jumorap/Geolo/one_geoV1.2-master/cambio-driver-camera-SDK.odt

Transición de software de Flycapture a Spinnaker

Durante el proceso de ejecución del programa, se observo una incompatibilidad para la comunicación del software con la camara cuya referencia pertenece BFS-U3-50S5C-C. El programa para la inicialización, captura y control se encuentra asociado con el SDK (software development kit) Flycapture2, que se encuentra en el programa servidor, ubicación code/pgr/serverzmq/camera_driver.hpp. Para su correcta configuración es necesario un SDK llamado Spinnaker, el cual contiene una estructura lógica diferente a la que se encuentra en el programa, lo que involucra, una modificación, en archivos relacionados con el procesamiento de imagen, sobre el control servidor y la comunicación con el cliente y sus dispositivos (arduino y perifericos “motores, iluminacion, finales de carrera.”).

Una posible solución:

-Inicio de documentación detallada del funcionamiento del programa que genera la ejecución del servidor, el objetivo principal de este proceso es alcanzar el analisis especifico de las funciones involucradas en el manejo de la camara, para de esta manera lograr asociar las funciones correspondietes al SDK Spinnaker.

-El tiempo para la estructuración del diseño presente en software (de lo que se tiene hasta el momento), en un documento legible y entendible para el refinamiento y escabilidad del proyecto, es aproximadamente de 3 semanas. Esto se debe a que parte del procesamiento y el control se encuentra en el servidor y corresponde a la arquitectura mas extensa de todo el proyecto.

-Para el rediseño a partir de la documentación antes elaborada, esta propuesta entre 2-3 semanas, pueden encontrarse incompatiblidad entre las funciones existentes y las que se quieren incorporar sobre el diseño, ademas de generar un control de errores para su correcto funcionamiento.

-En la implementacion en codigo, se estima un tiempo entre 1-2 semanas, como en el caso anteriror puede presentarse errores como el uso de dependencias o librerias presentes en el sistema operativo, que no esten incorporadas e impidan el correcto funcionamiento de la aplicación.
