jumorap/Geolo/one_geoV1.2-master/electrx/datasheet_onegeo/RAMPS_FD.png

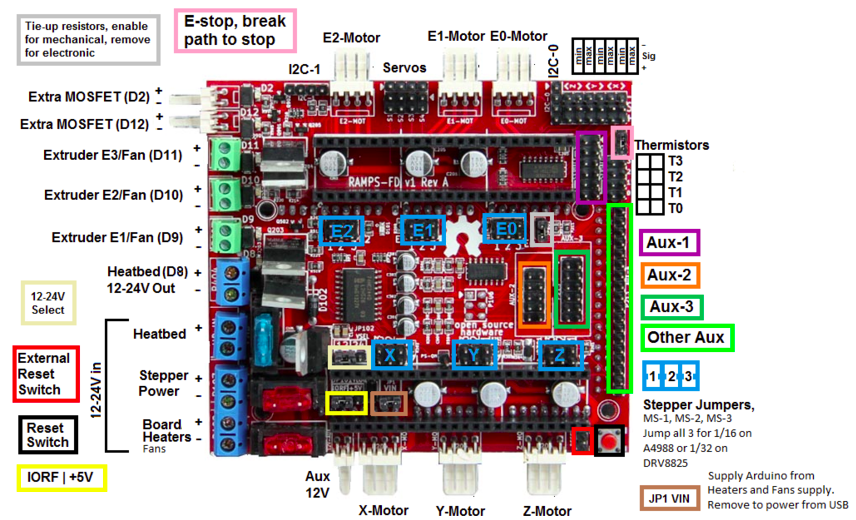
one_geoV1.2-master/electrx/datasheet_onegeo/RAMPS_FD.png
