jumorap/Geolo/one_geoV1.2-master/electrx/datasheet_onegeo/Screenshot_20191112_094737.png

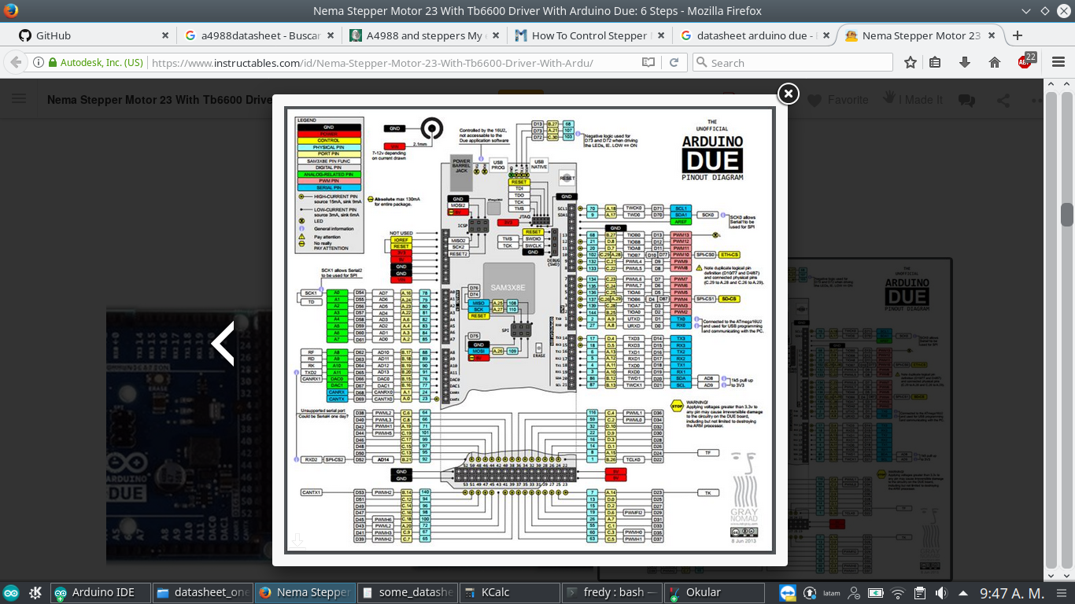
one_geoV1.2-master/electrx/datasheet_onegeo/Screenshot_20191112_094737.png
