jumorap/Geolo/one_geoV1.2-master/Mechanics/optica/imagenes_muestra/1.jpeg

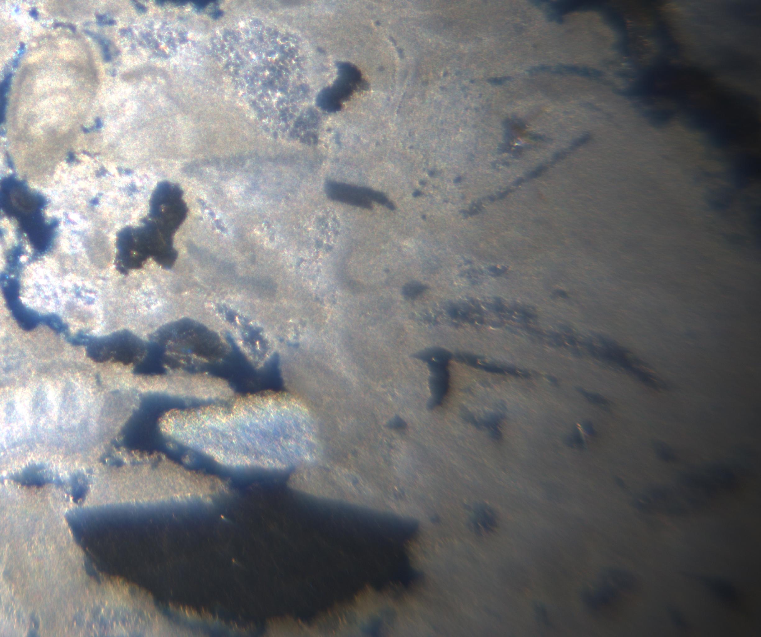
one_geoV1.2-master/Mechanics/optica/imagenes_muestra/1.jpeg
