jumorap/Geolo/one_geoV1.2-master/Mechanics/optica/imagenes_muestra/2.jpeg

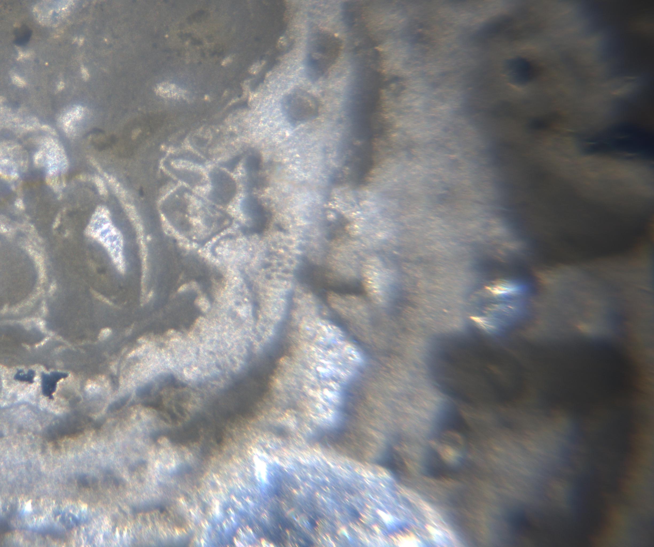
one_geoV1.2-master/Mechanics/optica/imagenes_muestra/2.jpeg
