jumorap/Geolo/one_geoV1.2-master/Mechanics/optica/imagenes_muestra/3.jpeg

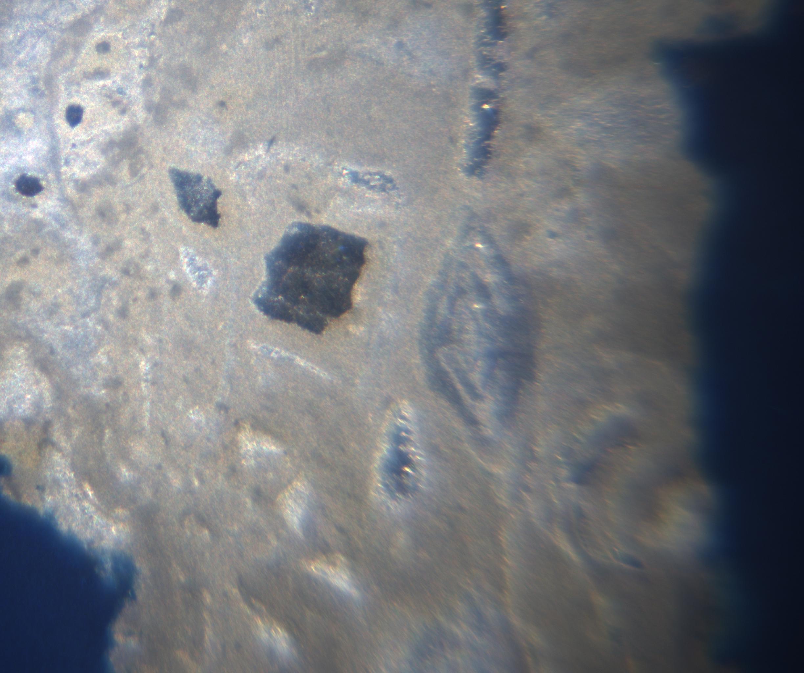
one_geoV1.2-master/Mechanics/optica/imagenes_muestra/3.jpeg
