jumorap/Geolo/one_geoV1.2-master/electrx/mainboard/BoardI_O.ods

SALIDAS | USO | OBS
Borne DC_OUT1 | Salida +V3 | Conversor DC/DC
Borne JM2 | Control Motor DC 1
Borne JM3 | Control Motor DC 2
Borne QM1 | Control MOSFET M1 | PWM
Borne QM2 | Control MOSFET M2 | PWM
Borne QG1 | Control MOSFET MX | On/Off
ENTRADAS | USO | OBS
Borne DC_IN1 | Entrada +V2 | Conversor DC/DC
Pinset x6 J11 | Sensores efecto hall 1 y 2
MD0 (ftp POLOLU) | Driver Motores DC
DSO (ftp POLOLU MOD) | Conversor DC/DC
PINS EN USO | USO | OBS
PWM(D2-5) | Driver motores DC | out
PWM(D6-7) | Mosfets M1 M2 | out
D37/9 | Control MOSFET Mx | out
D49 | NN | in
D32 | Sensor H1 | in
D47 | Sensor H2 | in
PINS DISPONIBLES | OBS
D8 | PWM
D9 | PWM
D10 | PWM
D11 | PWM
D12 | PWM
D23
D25
D27
D29
D31
D33
D35
D50-MISO
D51-MOSI
D52-SCK
AD0
AD1
AD2
AD3
