jumorap/Geolo/one_geoV1.2-master/electrx/mainboard/OneGeo/Lista de elementos y referencias.xlsx

Placa OneGeo V2.0 Controller |  |  |  |  |  |  |  |  | COMPONENTES GENERICOS
 | Empresa | Gmas+ |  |  |  |  | Descripción: | Placa RAMPS v2.0 (Shield de Arduino due) modificada para el proyecto OneGeo V2.0
 | Ingeniero responsabe | Fredy Osorio | Contacto | 3057210951
 | Proyecto | OneGeoV2.0
 |  |  |  |  | Electronilab | Sigma
ITEM | STATUS | N° DE PARTE en la PBC | CANTIDAD DEL COMPONENTE EN LA PCB | DESCRIPCIÓN DEL COMPONENTE |  |  | REFERENCIA : FABRICANTE | Segunda Opción de fabricante
1 | COLCIRCUITOS | D102 : SS10P4 | 1 | Schottky Barrier Rectifiers TO-277A 10A 40V | x | o | SS10P4:Vishay | podria ser modificado
2 | COLCIRCUITOS | R231 : 10k | 1 | resistencia SM 0805 10k | o |  | ERJ 6GEYJ103V:panasonic | generico
3 | COLCIRCUITOS | R305 : 4k7 | 1 | resistencia SM 0805 4K7 | o |  | ERJ 6GEYJ472V:panasonic | generico
4 | COLCIRCUITOS | RD23, RD24, RD25, RD26 : 2k | 4 | resistencia SM 0805 2k | x |  | ERJ 6GEYJ202V:panasonic | generico
5 | disponible | C1, C2, C305, C601 , C102: 100n 50V | 5 | Capacitor dielectrico 100nF 50V SM 0805 | o |  | Ref:CC0805 0.1UF50 | generico
6 | disponible | C100, C200, C400, C500 : 220n | 4 | Capacitor dielectrico 220nF 50V SM 0805 | o |  | Ref: CC0805 220NF50 | generico
7 | disponible | C101, C201, C202, C203, C205, C206 : 100u 35V | 6 | condensador electrolitico 100uF 35v 6.3x7.7mm | x | o | EEEFK1V101XP:panasonic | generico
8 | disponible | C3 : 47u | 1 | condensador electrolitico 47uF 16v 5x5.4mm | x | o | SMDAC-Dia5*5.4mm-16V47uF:Koky | generico
9 | disponible | D101 : LED GRN | 1 | Led verde smd 0805 5V | o |  | 598-8180-107F:dialight | WENGN01-C1M:Winger Electronics /generico
10 | disponible | D301 : 1N4148 | 1 | diodo small signal SM sod 323, 75V 150 mA | o |  | 1N4148WS SOD323: PANJIT | Vishay
11 | disponible | Dm2, Dm1 : 1N5819 | 2 | Schottky Diode 1N5819 40V 1A | x | o | SS5819:Vishay | generico
12 | disponible | DS0 : DC-DC-DSUN | 1 | cama hembra para conversor dc-dc d-sun/pin socket 2x1 (x4) | 0 |  | Linea de pines hembra 2x1 (x4) | generico
13 | disponible | F103, F102 : FUSE 10A | 2 | Soporte para fusible tipo bayoneta // elemento no disponible, no instalar solo dejar el espacio | x |  | PTF/50:RU | VDC
14 | disponible | J11, J22 : CONN_02X03 | 2 | Linea de pin macho 2x3 | o |  | 951206-8722AR:3M (x3) | generico
15 | disponible | J23 : V2_V3 | 1 | Linea de pin macho 1x3 | o |  | 951118-8722AR:3M (x8) | generico
16 | disponible | JM2 , JM3 , P102 JPMT1, JPPI1 | 5 | Linea de pin macho 1x2 | o |  | 951118-8722AR:3M (x8) | generico
17 | disponible | FCNT1, FCNT2, LD1, P107, P108, MSF2, MSF1, P105 | 8 | bloque terminal, borne atornillable, 10x7.5mm | o |  | PCB Screw Terminal Block Connector 2p (KF301-2P) | generico
18 | disponible | MD0 : A4990, U201 : X, U202 : Y, U203 : Z, U205 : Analyzer, U206 : Polarizer | 6 | cama hembra para um driver de stepper pololu A3988 (linea de pines hembra 1x8 (x2)) | o |  | DBCIDCB1S08AG1 : Dubilier | generico
19 | disponible | O1,O2, OR2 : IXDI604 | 3 | IXDI604SI 4-Ampere Dual Low-Side Ultrafast MOSFET Drivers SOIC-8 | x | o | IXDI604SI:IXYS
20 | disponible | P1 : SERIAL1, P216 : SERIAL0, P801 : CONN_6 | 3 | Linea de pin macho 1x6 | o |  | 951118-8722AR:3M (x8) | generico
21 | disponible | P103 : PS-ON | 1 | Linea de pin macho 1x1 | o |  | 951118-8722AR:3M (x8) | generico
22 | disponible | P2 : I2C-1 , P211 : I2C-0 | 2 | Linea de pin macho 1x4 | o |  | 951118-8722AR:3M (x8) | generico
23 | disponible | P204 : X-MOT, P205 : Y-MOT, P206 : Z-MOT, P212 : E1-MOT, P217 : E0-MOT | 5 | conector 4way tipo kk | x | o | KK 254 7395 4way:molex | generico
24 | disponible | P213 : AUX-4 | 1 | Linea de pin macho 1x18 | o |  | 951118-8722AR:3M (x8) | generico
25 | disponible | P214 : AUX-2 | 1 | Linea de pin macho 2x5 | o |  | 951206-8722AR:3M (x3) | generico
26 | disponible | P219 : EXT_5V, P302 : ESTOP | 2 | conector 2way tipo kk | x |  | KK 254 7395 2way:molex | generico
27 | disponible | P802 : CONN_6X2 | 1 | Linea de pin macho 2x6 | o |  | 951206-8722AR:3M (x3) | generico
28 | disponible | Q101 : 2N7002 | 1 | 2N7002 60 V, 300 mA N-channel Trench MOSFET sot23 | x | o | 2n7002:NXP | Vishay
29 | disponible | QG1 , QG2 : IRLZ44N | 2 | Power MOSFET N TO220AB 55V 49A | x | o | IRFZ44N:IOR | Vishay,NXP
30 | disponible | QM1, QM2 : IRF9530 | 2 | Power MOSFET P TO220AB -100V -12A | x | o | IRF9530:IOR | Samsung, Vishay
31 | disponible | R1, R2, R211, R212 : 1.5k | 4 | resistencia SM 0805 1.5k | o |  | ERJ 6GEYJ152V:panasonic | generico
32 | disponible | R101 : 330R | 1 | resistencia SM 0805 330R | o |  | ERJ 6GEYJ331V:panasonic | generico
33 | disponible | R201, R202, R203, R208, R210, R304 : 100k | 6 | resistencia SM 0805 100k | o |  | ERJ 6GEYJ104V:panasonic | generico
34 | disponible | RN23, RP801, RP802 : 10k | 3 | Arreglo de 4 resistencias sm 0603 10k | x | o | EXB V8V103JV :panasonic | generico
35 | disponible | SW101 : RESET | 1 | Switch B3F-1000 6x6mm | o |  | omron | generico
36 | disponible | U2 : 74ACT244D | 1 | Octal Buffer/Line Driver with 3-State Outputs 74ACT244D soic-20 | x | o | SN74ACT244DW:TI | MC75ACT244:on
38 | disponible | U601 : 24C512 | 1 | 2-wire Serial EEPROM 24c512 soic 8 5v | x | o | Ref:CAT24C512WI-GT3 | on semiconductor
39 | disponible | U801 : 4050_RMC | 1 | HCF4050BM1 Hex non-inverting HIGH -to-LOW level shifter so 16 | x | o | HCF4050BM1:ST Ref:CD4050BNSR
