jumorap/Geolo/one_geoV1.2-master/Mechanics/onegeo-prototype3/bandeja/STL/assembly.stl

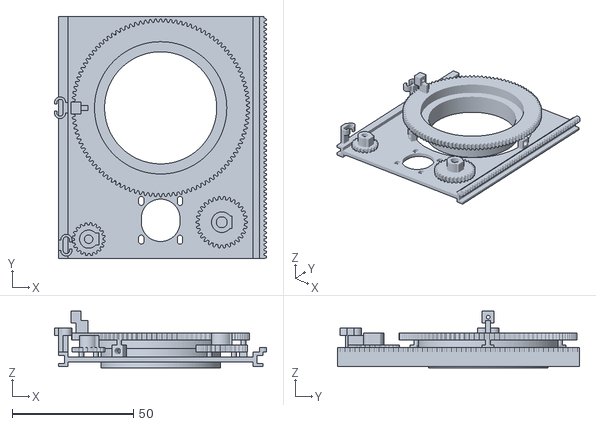
[picture p7: CAD file, 2020-01-25]
one_geoV1.2-master/Mechanics/onegeo-prototype3/bandeja/STL/assembly.stl
87.6 x 100.0 x 23.5
