jumorap/Geolo/one_geoV1.2-master/Mechanics/onegeo-prototype3/bandeja/DXF/gear_N108P2.1.dxf

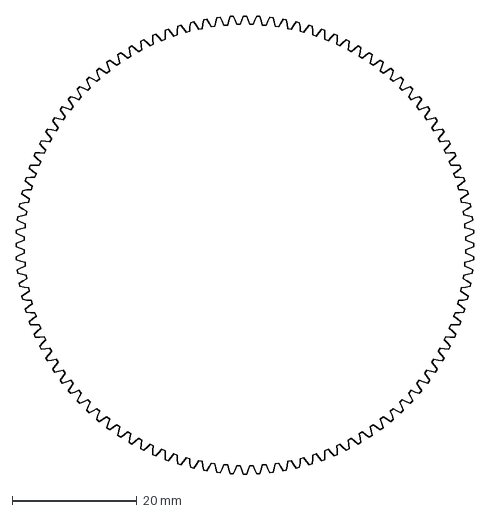
[picture p8: CAD file, 2020-01-25]
one_geoV1.2-master/Mechanics/onegeo-prototype3/bandeja/DXF/gear_N108P2.1.dxf
73.5 x 73.5 mm
