jumorap/Geolo/one_geoV1.2-master/Mechanics/onegeo-prototype3/muestra/STL/inferior.stl

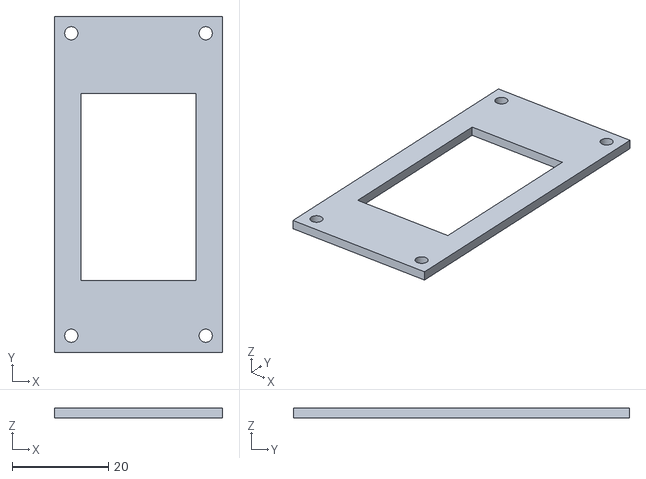
[picture p9: CAD file, 2020-01-25]
one_geoV1.2-master/Mechanics/onegeo-prototype3/muestra/STL/inferior.stl
35.0 x 70.0 x 2.00
