jumorap/Geolo/one_geoV1.2-master/Mechanics/onegeo-prototype3/soportes/STL/disipador_amortiguador.stl

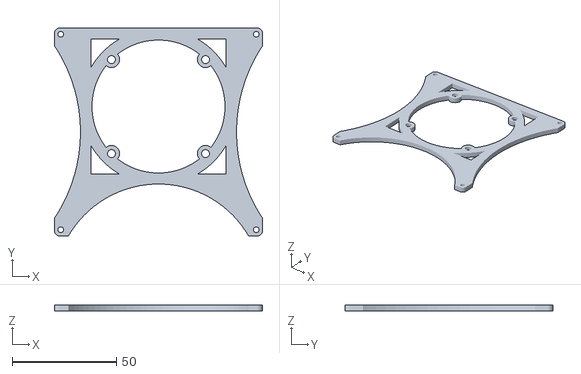
[picture p10: CAD file, 2020-01-25]
one_geoV1.2-master/Mechanics/onegeo-prototype3/soportes/STL/disipador_amortiguador.stl
100.0 x 100.0 x 3.00
