jumorap/Geolo/one_geoV1.2-master/Mechanics/onegeo-prototype3/bandeja/DXF/rack_pinion.dxf

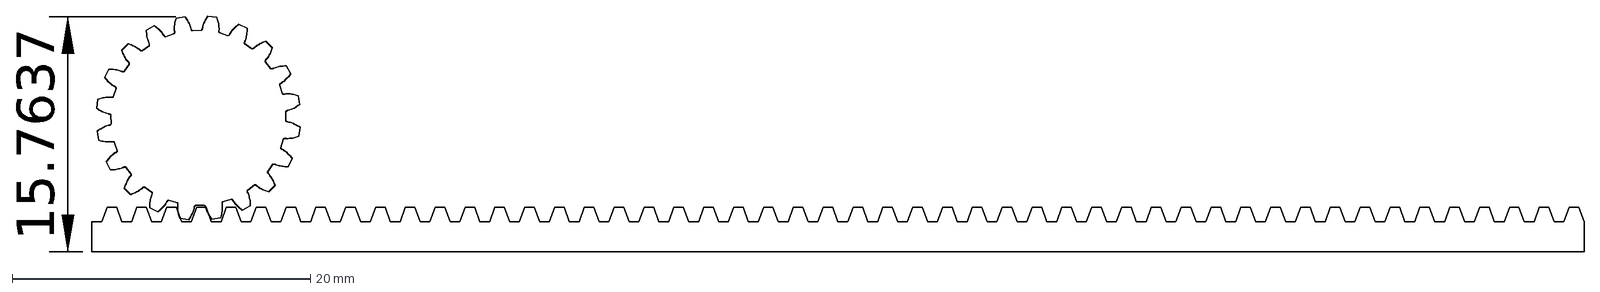
[picture p11: CAD file, 2020-01-25]
one_geoV1.2-master/Mechanics/onegeo-prototype3/bandeja/DXF/rack_pinion.dxf
15.7637
