jumorap/Geolo/one_geoV1.2-master/Mechanics/onegeo-prototype3/bandeja/STL/plate.stl

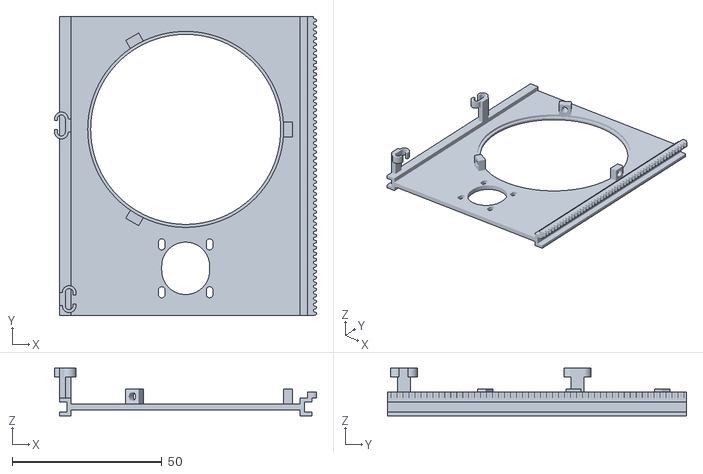
[picture p12: CAD file, 2020-01-25]
one_geoV1.2-master/Mechanics/onegeo-prototype3/bandeja/STL/plate.stl
87.6 x 100.0 x 16.0
