jumorap/Geolo/one_geoV1.2-master/Mechanics/onegeo-prototype3/muestra/STL/superior.stl

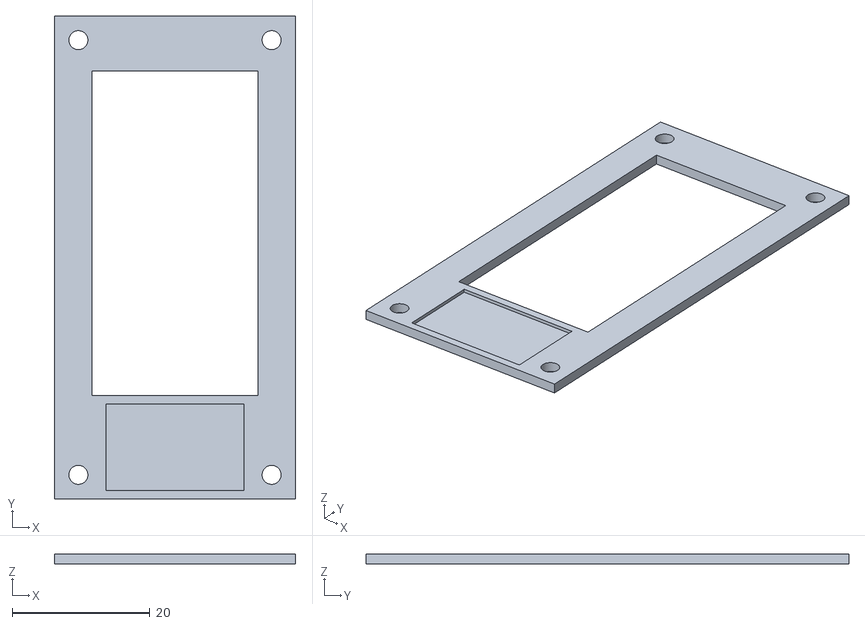
[picture p13: CAD file, 2020-01-25]
one_geoV1.2-master/Mechanics/onegeo-prototype3/muestra/STL/superior.stl
35.0 x 70.0 x 1.50
