jumorap/Geolo/one_geoV1.2-master/Mechanics/onegeo-prototype3/soportes/STL/objetivo.stl

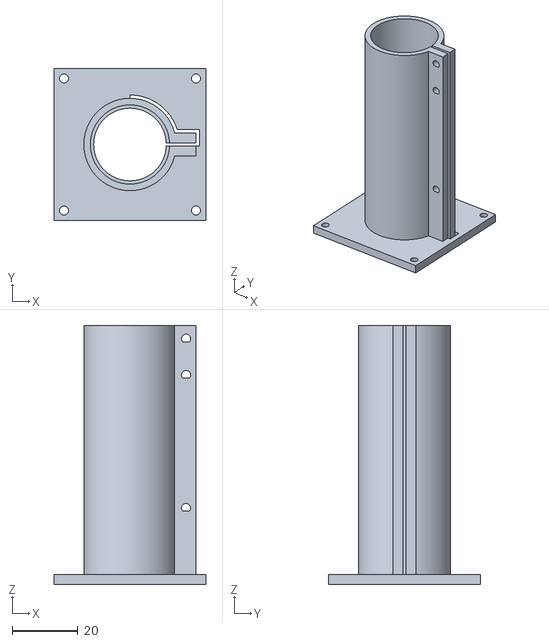
[picture p14: CAD file, 2020-01-25]
one_geoV1.2-master/Mechanics/onegeo-prototype3/soportes/STL/objetivo.stl
46.0 x 46.0 x 78.5
