jumorap/Geolo/one_geoV1.2-master/Mechanics/onegeo-prototype3/bandeja/DXF/pinion.dxf

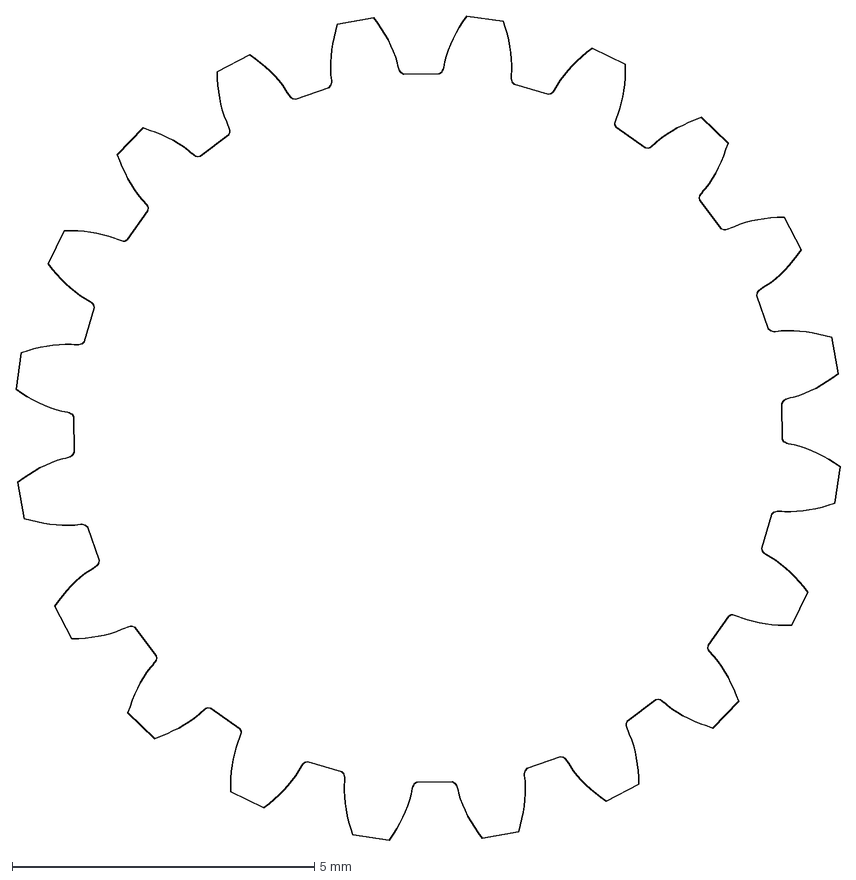
[picture p15: CAD file, 2020-01-25]
one_geoV1.2-master/Mechanics/onegeo-prototype3/bandeja/DXF/pinion.dxf
13.6 x 13.6 mm
