jumorap/Geolo/one_geoV1.2-master/Mechanics/onegeo-prototype3/bandeja/STL/stepper-gear.stl

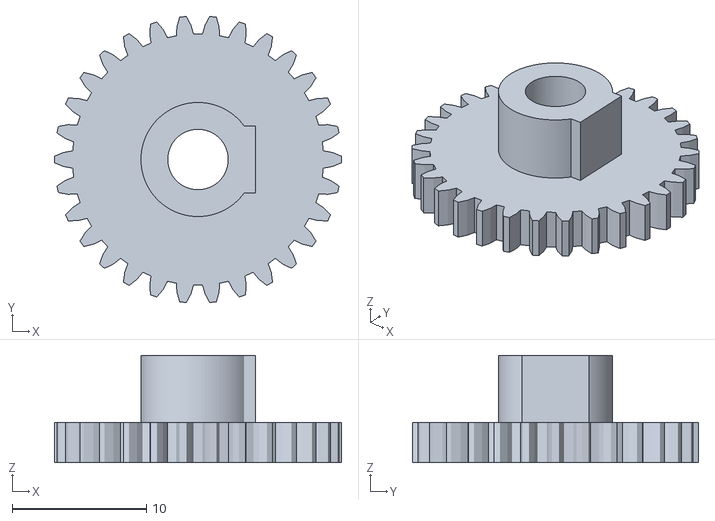
[picture p16: CAD file, 2020-01-25]
one_geoV1.2-master/Mechanics/onegeo-prototype3/bandeja/STL/stepper-gear.stl
21.4 x 21.3 x 8.00
