jumorap/Geolo/one_geoV1.2-master/Mechanics/onegeo-prototype3/muestra/STL/placa_1.stl

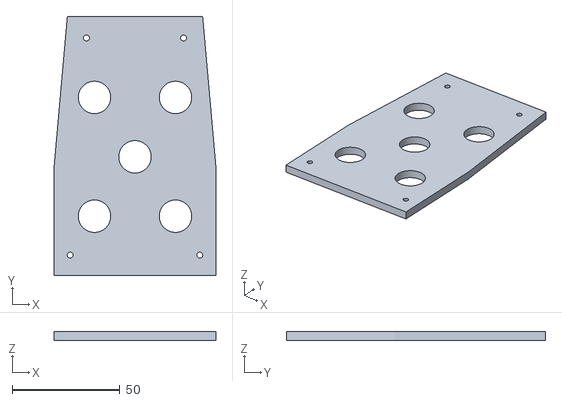
[picture p17: CAD file, 2020-01-25]
one_geoV1.2-master/Mechanics/onegeo-prototype3/muestra/STL/placa_1.stl
75.0 x 120.0 x 4.00
