jumorap/Geolo/one_geoV1.2-master/Mechanics/onegeo-prototype3/bandeja/DXF/gear_N30P2.1.dxf

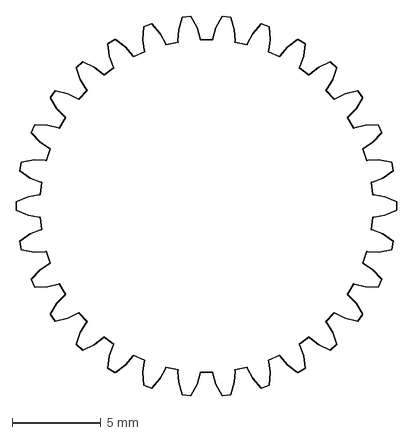
[picture p19: CAD file, 2020-01-25]
one_geoV1.2-master/Mechanics/onegeo-prototype3/bandeja/DXF/gear_N30P2.1.dxf
21.4 x 21.3 mm
