jumorap/Geolo/one_geoV1.2-master/Mechanics/onegeo-prototype3/bandeja/STL/bearing.stl

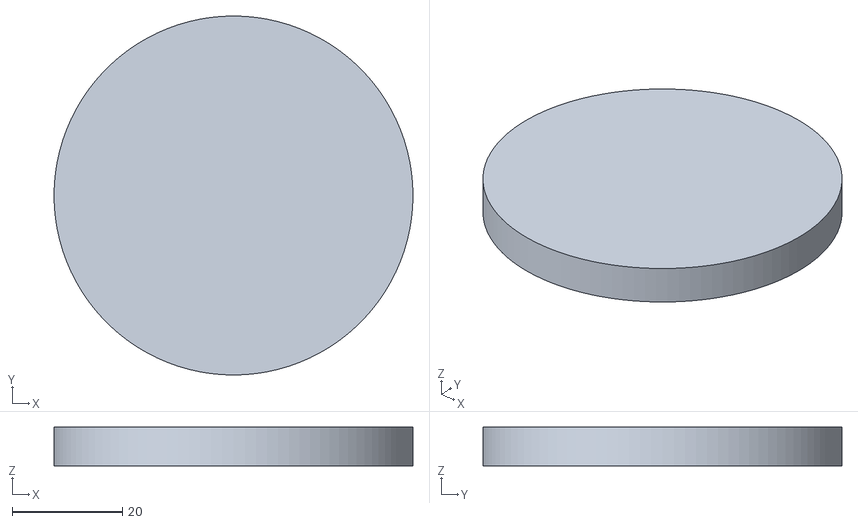
[picture p20: CAD file, 2020-01-25]
one_geoV1.2-master/Mechanics/onegeo-prototype3/bandeja/STL/bearing.stl
65.0 x 65.0 x 7.00
