jumorap/Geolo/one_geoV1.2-master/Mechanics/onegeo-prototype3/muestra/STL/placa_2.stl

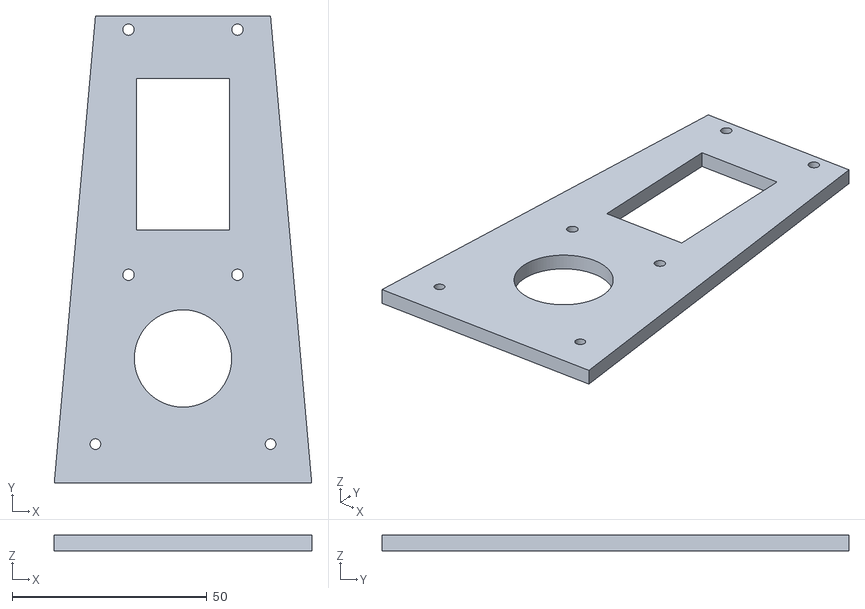
[picture p21: CAD file, 2020-01-25]
one_geoV1.2-master/Mechanics/onegeo-prototype3/muestra/STL/placa_2.stl
66.2 x 120.0 x 4.00
