jumorap/Geolo/one_geoV1.2-master/Mechanics/onegeo-prototype3/soportes/STL/camara-placa.stl

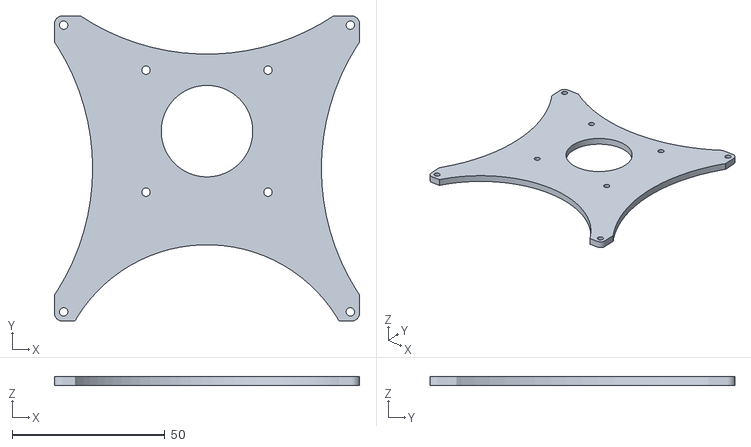
[picture p22: CAD file, 2020-01-25]
one_geoV1.2-master/Mechanics/onegeo-prototype3/soportes/STL/camara-placa.stl
100.0 x 100.0 x 3.00
