jumorap/Geolo/one_geoV1.2-master/Mechanics/onegeo-prototype3/bandeja/STL/motor-dc_pinion.stl

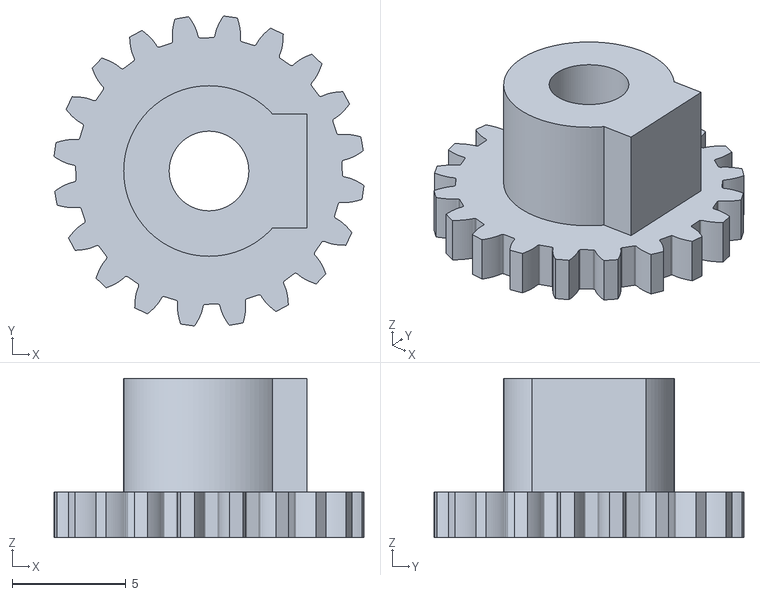
[picture p23: CAD file, 2020-01-25]
one_geoV1.2-master/Mechanics/onegeo-prototype3/bandeja/STL/motor-dc_pinion.stl
13.6 x 13.6 x 7.00
