jumorap/Geolo/one_geoV1.2-master/Mechanics/onegeo-prototype3/soportes/STL/platina.stl

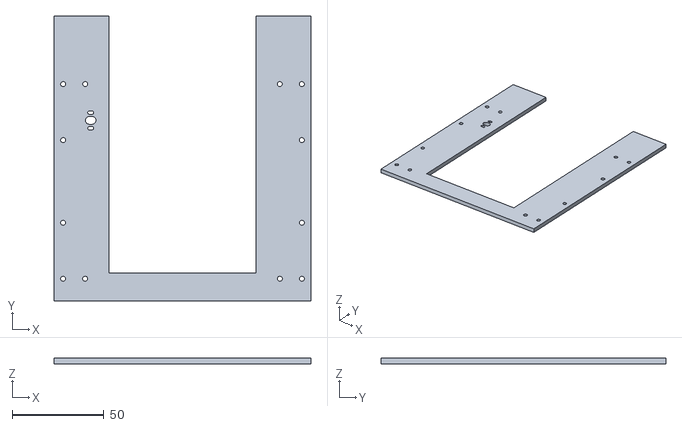
[picture p24: CAD file, 2020-01-25]
one_geoV1.2-master/Mechanics/onegeo-prototype3/soportes/STL/platina.stl
140.0 x 155.0 x 3.00
