jumorap/Geolo/one_geoV1.2-master/Mechanics/onegeo-prototype3/bandeja/DXF/engranajes.dxf

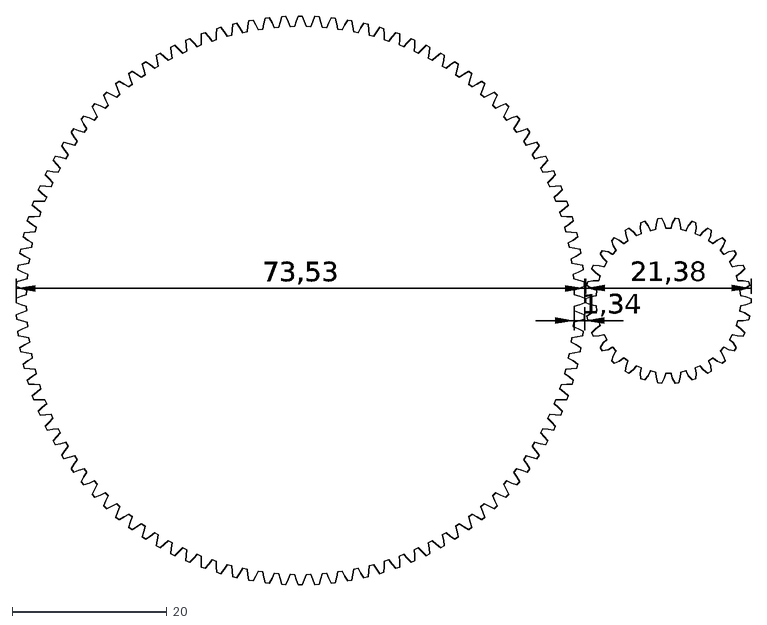
[picture p25: CAD file, 2020-01-25]
one_geoV1.2-master/Mechanics/onegeo-prototype3/bandeja/DXF/engranajes.dxf
73,53
21,38
1,34
