jumorap/Geolo/one_geoV1.2-master/Mechanics/onegeo-prototype3/soportes/STL/carcasa-superior.stl

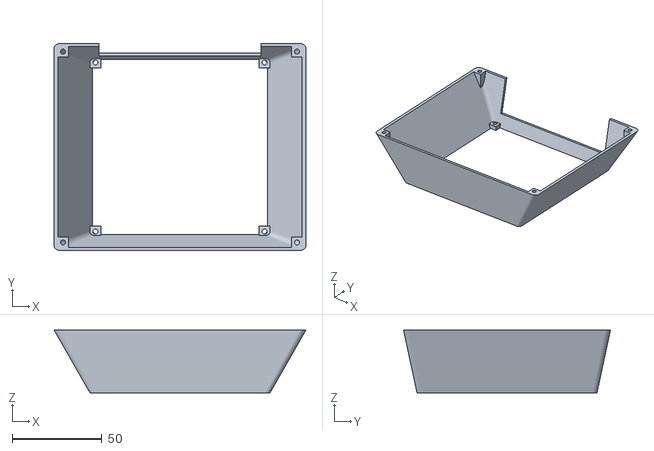
[picture p31: CAD file, 2020-01-25]
one_geoV1.2-master/Mechanics/onegeo-prototype3/soportes/STL/carcasa-superior.stl
140.0 x 115.0 x 35.0
