jumorap/Geolo/one_geoV1.2-master/Mechanics/onegeo-prototype3/soportes/STL/camara-ventilador.stl

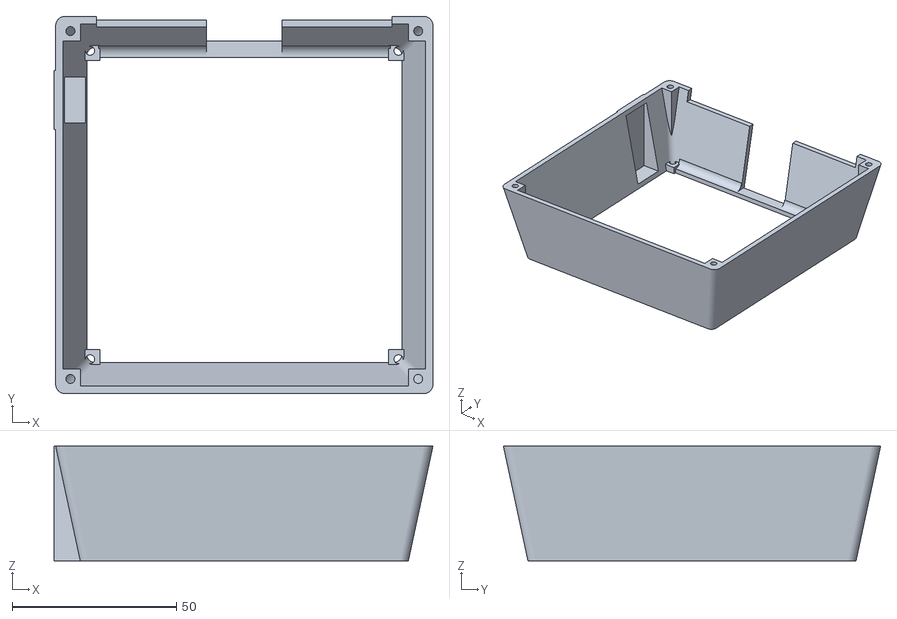
[picture p32: CAD file, 2020-01-25]
one_geoV1.2-master/Mechanics/onegeo-prototype3/soportes/STL/camara-ventilador.stl
115.5 x 115.0 x 35.0
