jumorap/Geolo/one_geoV1.2-master/Mechanics/onegeo-prototype3/soportes/STL/lente-tubo-clip.stl

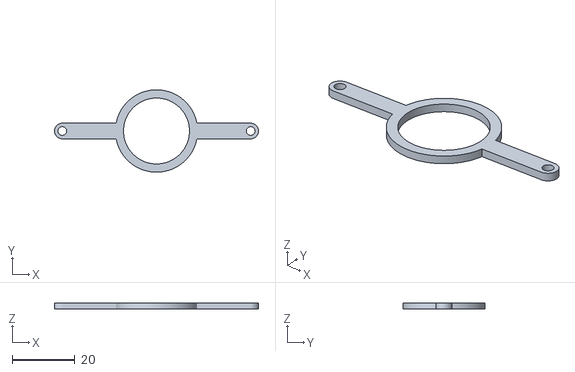
[picture p33: CAD file, 2020-01-25]
one_geoV1.2-master/Mechanics/onegeo-prototype3/soportes/STL/lente-tubo-clip.stl
65.0 x 26.2 x 2.00
