jumorap/Geolo/one_geoV1.2-master/Mechanics/onegeo-prototype3/muestra/inferior.scad

$fn = 90;

// Placa
lx = 35;
ly = 70;
lz = 2;

// Agujero
lx1 = 24;
ly1 = 39;
lz1 = lz;

// Tornillos
r = 2.75/2;
h = lz;
d = 3.5;


difference() {
  cube([lx, ly, lz]);

  // Agujero
  translate([(lx-lx1)/2, 15, 0]) cube([lx1, ly1, lz1]);

  // Tornillos
  translate([d, d, 0]) cylinder(r=r, h=h);
  translate([d, ly-d, 0]) cylinder(r=r, h=h);
  translate([lx-d, d, 0]) cylinder(r=r, h=h);
  translate([lx-d, ly-d, 0]) cylinder(r=r, h=h);
}
