jumorap/Geolo/(list of files, cad)

Other CAD files:
one_geoV1.2-master/Mechanics/onegeo-prototype3/bandeja/stepper_gear.scad
one_geoV1.2-master/Mechanics/onegeo-prototype3/muestra/superior.scad
one_geoV1.2-master/Mechanics/onegeo-prototype3/soportes/lente-tubo.scad
one_geoV1.2-master/Mechanics/onegeo-prototype3/soportes/objetivo.scad
one_geoV1.2-master/Mechanics/onegeo-prototype3/assembly.blend
one_geoV1.2-master/Mechanics/onegeo-prototype3/bandeja/DXF/gear_N108P2.1_old.dxf
one_geoV1.2-master/Mechanics/onegeo-prototype3/bandeja/DXF/gear_N30P2.1_old.dxf
one_geoV1.2-master/Mechanics/onegeo-prototype3/bandeja/assembly.blend
