jumorap/Geolo/one_geoV1.2-master/Manual/main.tex

%----------------------------------------------------------------------------------------
%	PACKAGES AND OTHER DOCUMENT CONFIGURATIONS
%----------------------------------------------------------------------------------------

\documentclass{tufte-book} % Use the tufte-book class which in turn uses the tufte-common class
\usepackage[spanish]{babel}
\usepackage[latin1]{inputenc}
\usepackage{flowfram}		
\hypersetup{colorlinks} % Comment this line if you don't wish to have colored links
\usepackage{microtype} % Improves character and word spacing
\usepackage{lipsum} % Inserts dummy text
\usepackage{booktabs} % Better horizontal rules in tables
\usepackage{graphicx}										% figures
\usepackage{url}											% URLs
\usepackage[usenames,dvipsnames]{xcolor}					% olor
\usepackage{multicol}										% columns env.
\setlength{\multicolsep}{0pt}
\usepackage{paralist}										% compact lists
\usepackage{tikz}
\usepackage{mfirstuc}
\usepackage{lipsum}
\usepackage{anyfontsize}
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
\newcommand{\na}{\quad--} % Used in tables for N/A cells
\newcommand{\measure}[3]{#1/#2$\times$\unit[#3]{pc}} % Typesets the font size, leading, and measure in the form of: 10/12x26 pc.
\newcommand{\tuftebs}{\symbol{'134}} % Command to print a backslash in tt type in OT1/T1

\providecommand{\XeLaTeX}{X\lower.5ex\hbox{\kern-0.15em\reflectbox{E}}\kern-0.1em\LaTeX}
\newcommand{\tXeLaTeX}{\XeLaTeX\index{XeLaTeX@\protect\XeLaTeX}} % Command to print the XeLaTeX logo while simultaneously adding the position to the index

\newcommand{\doccmdnoindex}[2][]{\texttt{\tuftebs#2}} % Command to print a command in texttt with a backslash of tt type without inserting the command into the index

\newcommand{\doccmddef}[2][]{\hlred{\texttt{\tuftebs#2}}\label{cmd:#2}\ifthenelse{\isempty{#1}} % Command to define a command in red and add it to the index
{ % If no package is specified, add the command to the index
\index{#2 command@\protect\hangleft{\texttt{\tuftebs}}\texttt{#2}}% Command name
}
{ % If a package is also specified as a second argument, add the command and package to the index
\index{#2 command@\protect\hangleft{\texttt{\tuftebs}}\texttt{#2} (\texttt{#1} package)}% Command name
\index{#1 package@\texttt{#1} package}\index{packages!#1@\texttt{#1}}% Package name
}}

\newcommand{\doccmd}[2][]{% Command to define a command and add it to the index
\texttt{\tuftebs#2}%
\ifthenelse{\isempty{#1}}% If no package is specified, add the command to the index
{%
\index{#2 command@\protect\hangleft{\texttt{\tuftebs}}\texttt{#2}}% Command name
}
{%
\index{#2 command@\protect\hangleft{\texttt{\tuftebs}}\texttt{#2} (\texttt{#1} package)}% Command name
\index{#1 package@\texttt{#1} package}\index{packages!#1@\texttt{#1}}% Package name
}}

% A bunch of new commands to print commands, arguments, environments, classes, etc within the text using the correct formatting
\newcommand{\docopt}[1]{\ensuremath{\langle}\textrm{\textit{#1}}\ensuremath{\rangle}}
\newcommand{\docarg}[1]{\textrm{\textit{#1}}}
\newenvironment{docspec}{\begin{quotation}\ttfamily\parskip0pt\parindent0pt\ignorespaces}{\end{quotation}}
\newcommand{\docenv}[1]{\texttt{#1}\index{#1 environment@\texttt{#1} environment}\index{environments!#1@\texttt{#1}}}
\newcommand{\docenvdef}[1]{\hlred{\texttt{#1}}\label{env:#1}\index{#1 environment@\texttt{#1} environment}\index{environments!#1@\texttt{#1}}}
\newcommand{\docpkg}[1]{\texttt{#1}\index{#1 package@\texttt{#1} package}\index{packages!#1@\texttt{#1}}}
\newcommand{\doccls}[1]{\texttt{#1}}
\newcommand{\docclsopt}[1]{\texttt{#1}\index{#1 class option@\texttt{#1} class option}\index{class options!#1@\texttt{#1}}}
\newcommand{\docclsoptdef}[1]{\hlred{\texttt{#1}}\label{clsopt:#1}\index{#1 class option@\texttt{#1} class option}\index{class options!#1@\texttt{#1}}}
\newcommand{\docmsg}[2]{\bigskip\begin{fullwidth}\noindent\ttfamily#1\end{fullwidth}\medskip\par\noindent#2}
\newcommand{\docfilehook}[2]{\texttt{#1}\index{file hooks!#2}\index{#1@\texttt{#1}}}
\newcommand{\doccounter}[1]{\texttt{#1}\index{#1 counter@\texttt{#1} counter}}

\usepackage{makeidx} % Used to generate the index
\makeindex % Generate the index which is printed at the end of the document

% This block contains a number of shortcuts used throughout the book

\newcommand{\GM}{\textit{Gmas $+$}\xspace}
\newcommand{\OG}{\textit{One Geo}\xspace}
\newcommand{\SDs}{\textit{secciones delgadas}\xspace}
\newcommand{\SD}{\textit{sección delgada}\xspace}

%----------------------------------------------------------------------------------------
%	BOOK META-INFORMATION
%----------------------------------------------------------------------------------------

\title{Manual de Operacion de OneGeo} % Title of the book

\author[Ing. Fredy Osorio]{Ing. Fredy Osorio\textbackslash Gmas} % Author

%\publisher{Publisher of This Book} % Publisher

%----------------------------------------------------------------------------------------

\begin{document}

\frontmatter

%----------------------------------------------------------------------------------------
%	EPIGRAPH
%----------------------------------------------------------------------------------------

\thispagestyle{empty}
%\openepigraph{The public is more familiar with bad design than good design. It is, in effect, conditioned to prefer bad design, because that is what it lives with. The new becomes threatening, the old reassuring.}{Paul Rand, {\itshape Design, Form, and Chaos}}
%\vfill
%\openepigraph{A designer knows that he has achieved perfection not when there is nothing left to add, but when there is nothing left to take away.}{Antoine de Saint-Exup\'{e}ry}
%\vfill
%\openepigraph{\ldots the designer of a new system must not only be the implementor and the first large-scale user; the designer should also write the first user manual\ldots If I had not participated fully in all these activities, literally hundreds of improvements would never have been made, because I would never have thought of them or perceived why they were important.}{Donald E. Knuth}

%----------------------------------------------------------------------------------------

\maketitle % Print the title page

%----------------------------------------------------------------------------------------
%	COPYRIGHT PAGE
%----------------------------------------------------------------------------------------

\newpage
\begin{fullwidth}
~\vfill
\thispagestyle{empty}
\setlength{\parindent}{0pt}
\setlength{\parskip}{\baselineskip}
Copyright \copyright\ \the\year\ \thanklessauthor

%\par\smallcaps{Published by \thanklesspublisher}

%\par\smallcaps{tufte-latex.googlecode.com}

%\par Licensed under the Apache License, Version 2.0 (the ``License''); you may not use this file except in compliance with the License. You may obtain a copy of the License at \url{http://www.apache.org/licenses/LICENSE-2.0}. Unless required by applicable law or agreed to in writing, software distributed under the License is distributed on an \smallcaps{``AS IS'' BASIS, WITHOUT WARRANTIES OR CONDITIONS OF ANY KIND}, either express or implied. See the License for the specific language governing permissions and limitations under the License.\index{license}

\par\textit{Primera impresión, \monthyear}
\end{fullwidth}

%----------------------------------------------------------------------------------------

\tableofcontents % Print the table of contents

%----------------------------------------------------------------------------------------

\listoffigures % Print a list of figures

%----------------------------------------------------------------------------------------

\listoftables % Print a list of tables

%----------------------------------------------------------------------------------------
%	INTRODUCTION
%----------------------------------------------------------------------------------------

\cleardoublepage

\chapter{Introducción}
\label{ch:intro}

Este documento tiene como propósito proporcionar una guía detallada para llevar a cabo la operación cotidiana del microscopio de \OG de \GM, además de ofrecer una manera raída y eficiente de desempeñar las tareas de toma y procesamiento de \SDs y de esta manera apoyar las tareas en el laboratorio de geología y petrofísica de la compañía.

\section{Objetivo del Manual de Operación}

El Objetivo del presente manual es el de proveer una guía y procedimientos de operación del microscopio de \OG que permita la efectiva y ágil toma y procesamiento de muestras de \SDs.

\section{Alcance del Manual}

El alcance de presente documento abarca las actividades a realizar desde la recepción de la \SD hasta el procedimiento de procesamiento de imágenes (\textit{stitching}) e ingreso del resultado a la plataforma web de \OG.
%----------------------------------------------------------------------------------------
%	BIBLIOGRAPHY
%----------------------------------------------------------------------------------------

%\bibliography{bibliography} % Use the bibliography.bib file for the bibliography
%\bibliographystyle{plainnat} % Use the plainnat style of referencing

%----------------------------------------------------------------------------------------

%\printindex % Print the index at the very end of the document

\end{document}
