jumorap/Geolo/one_geoV1.2-master/Manual/main.pdf

I N G . F R E DY O S O R I O \ G M A S

# M A N U A L D E O P E R A C I O N D E O N E G E O

Copyright © 2017 Ing. Fredy Osorio\Gmas

Primera impresión, Mayo 2017

## Índice general

Introducción 9

4

## Índice de figuras

6

## Índice de cuadros

8

## Introducción

Este documento tiene como propósito proporcionar una guía detallada para llevar a cabo la operación cotidiana del microscopio de One Geo de Gmas +, además de ofrecer una manera raída y eficiente de desempeñar las tareas de toma y procesamiento de secciones delgadas y de esta manera apoyar las tareas en el laboratorio de geología y petrofísica de la compañía.

Objetivo del Manual de Operación
El Objetivo del presente manual es el de proveer una guía y procedimientos de operación del microscopio de One Geo que permita la efectiva y ágil toma y procesamiento de muestras de secciones delgadas.

Alcance del Manual
El alcance de presente documento abarca las actividades a realizar desde la recepción de la sección delgada hasta el procedimiento de procesamiento de imágenes (stitching) e ingreso del resultado a la plataforma web de One Geo.
