jumorap/Geolo/one_geoV1.2-master/Manual/graphics/LOGOONEGEOblue.pdf

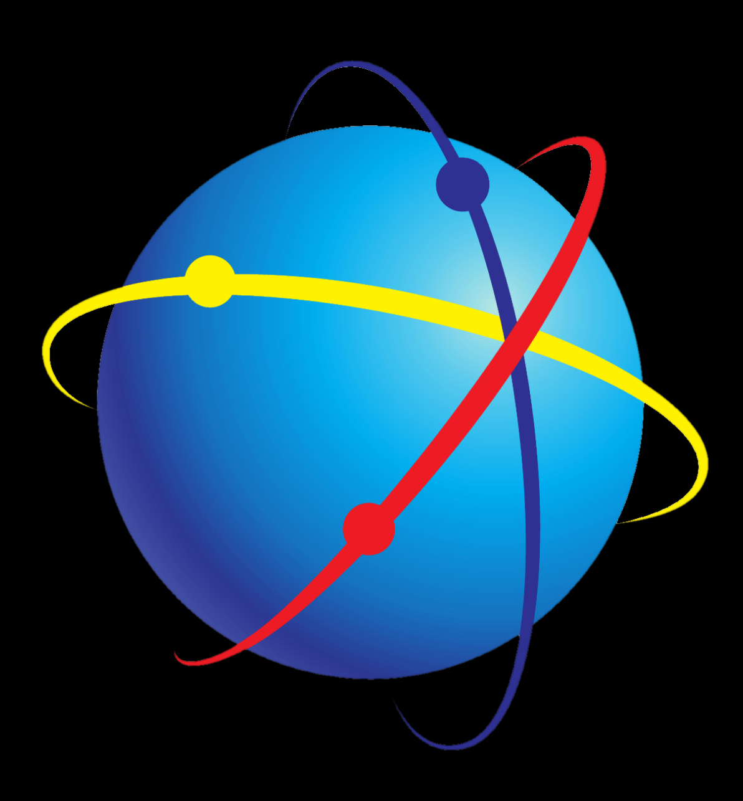
[picture p44: figure]

OneGeo
