jumorap/Geolo/one_geoV1.2-master/Manual/graphics/screen.pdf

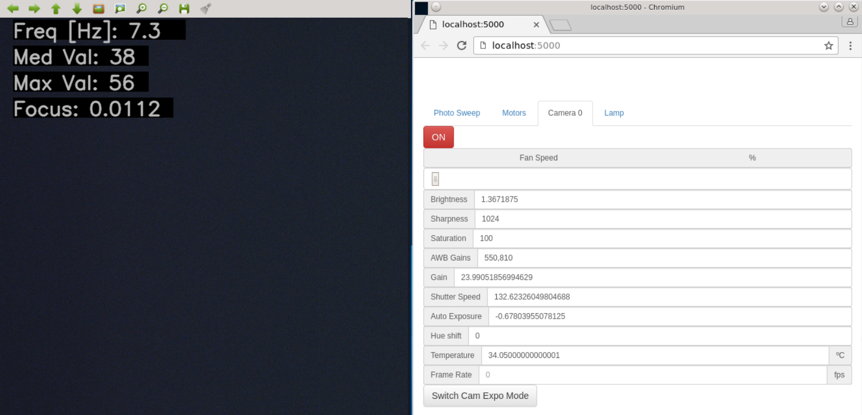
[picture p45: page 1]
