jumorap/Geolo/one_geoV1.2-master/Manual/graphics/alcohol.jpg

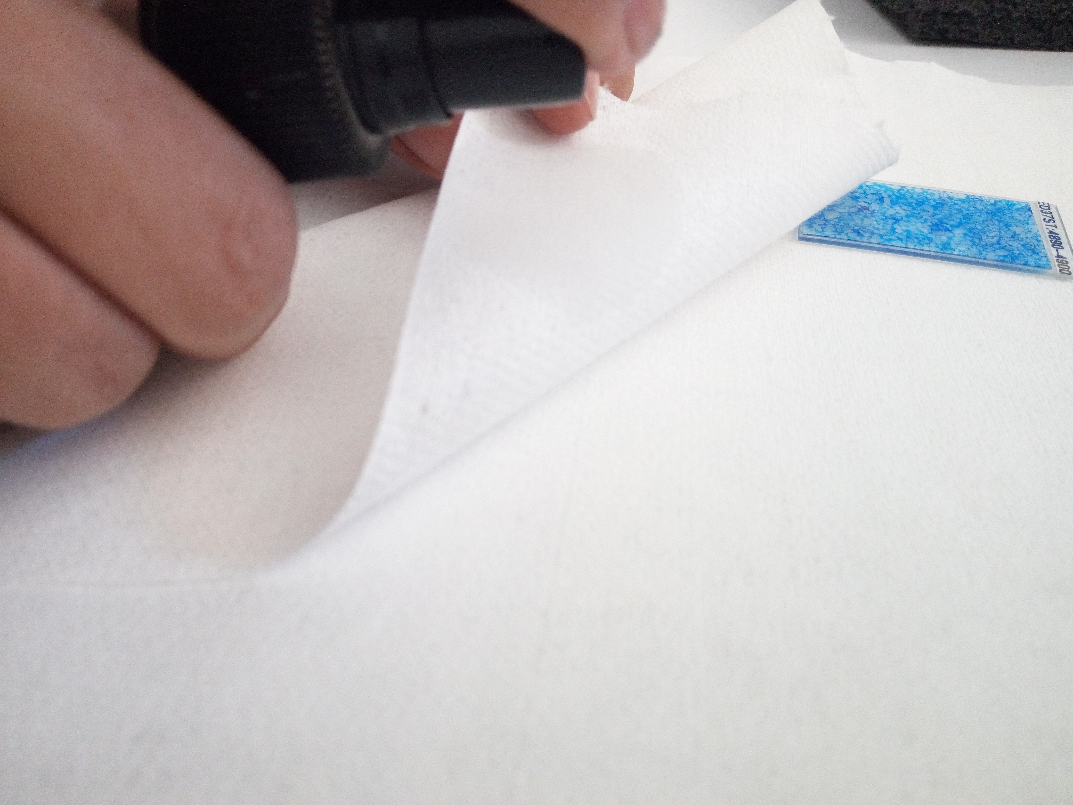
one_geoV1.2-master/Manual/graphics/alcohol.jpg
