jumorap/Geolo/one_geoV1.2-master/Manual/graphics/allsets.png

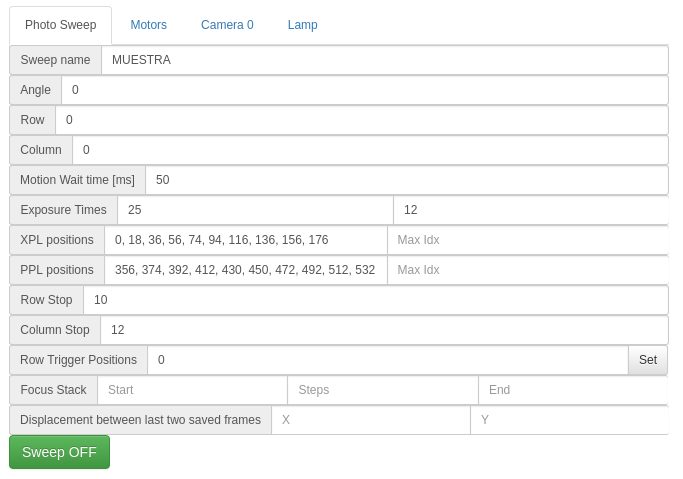
one_geoV1.2-master/Manual/graphics/allsets.png
