jumorap/Geolo/one_geoV1.2-master/Manual/graphics/analizer.png

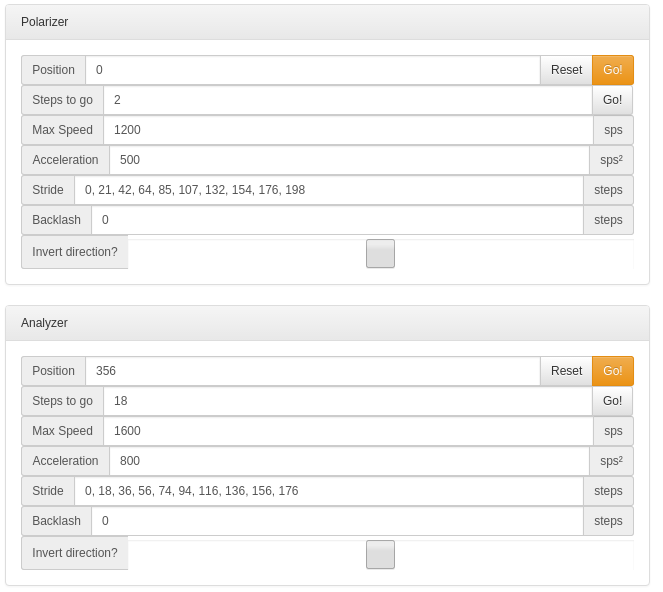
one_geoV1.2-master/Manual/graphics/analizer.png
