jumorap/Geolo/one_geoV1.2-master/Manual/graphics/OneGeo.png

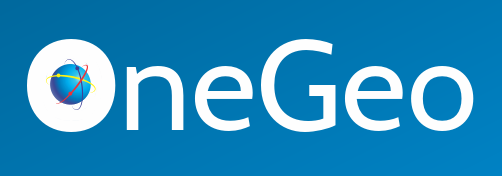
one_geoV1.2-master/Manual/graphics/OneGeo.png
