jumorap/Geolo/one_geoV1.2-master/Manual/graphics/pano.jpg

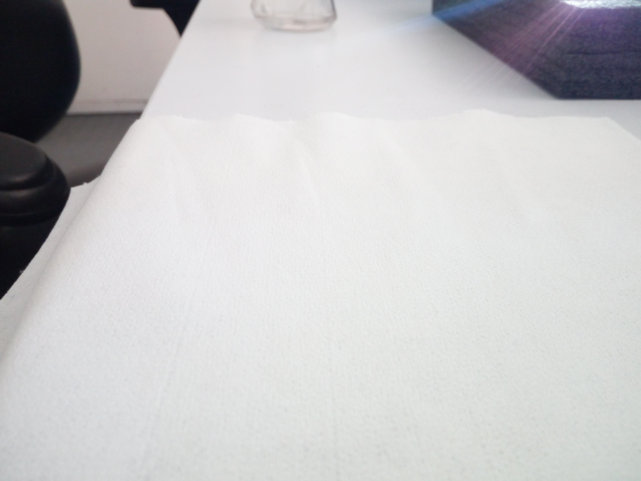
one_geoV1.2-master/Manual/graphics/pano.jpg
