jumorap/Geolo/one_geoV1.2-master/Manual/graphics/polar2.png

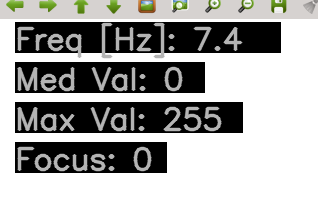
one_geoV1.2-master/Manual/graphics/polar2.png
