jumorap/Geolo/one_geoV1.2-master/Manual/graphics/polarized.png

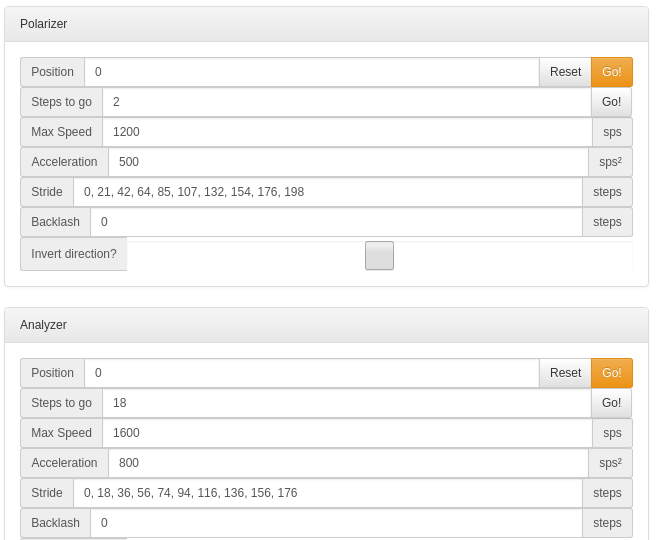
one_geoV1.2-master/Manual/graphics/polarized.png
