jumorap/Geolo/one_geoV1.2-master/Manual/graphics/satcali.png

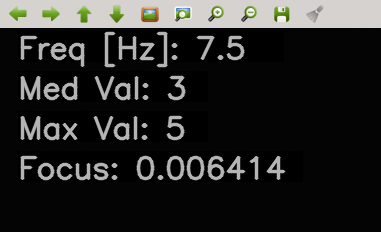
one_geoV1.2-master/Manual/graphics/satcali.png
