jumorap/Geolo/one_geoV1.2-master/Manual/graphics/screen.png

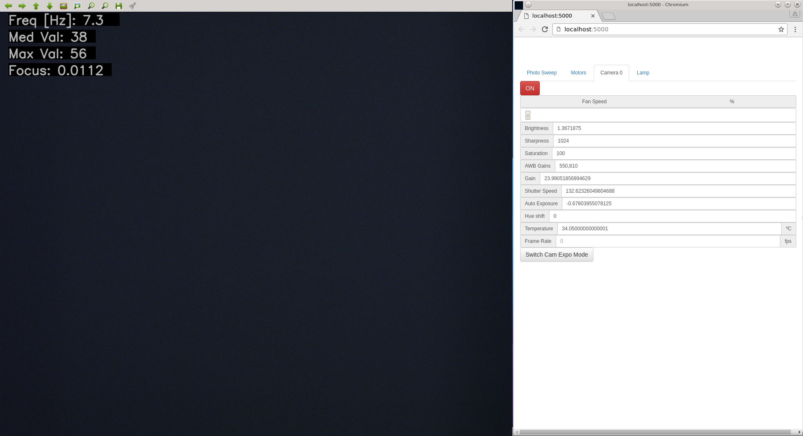
one_geoV1.2-master/Manual/graphics/screen.png
