jumorap/Geolo/one_geoV1.2-master/Mechanics/optica/experimento/calculo_distancias.htm

Aspectos de la Óptica OneGeo

1. Especificaciones de la Cámara





Tamaño del Sensor = 2/3"













2. Tamaño de la Sección Delgada



















3. Características de la Imagen obtenida



4. Distancias de Plano de Objeto y de Imagen

Al desconocer las características del lente fue necesario hacer un
experimento en el cual se deseaba encontrar la distacia al plano de
imagen, que es el plano donde la imagen se encuentra enfocada, teniendo
en cuenta la magnificación requerida.

Entonces se uso una fuente de luz de 3mm de diámetro y se empezo a
variar tanto la distancia entre un punto del lente (L) y la fuente
de luz que es plano del Objeto (O), y la distancia entre el plano de
Imagen enfocada (I) y el mismo punto de la lente (L). Tal como se
muestra en la siguiente figura:



El resultado fue que para una magnificación de 2.5X, donde D=2.5d,
las distancias son aproximadamente las siguientes:





5. Esquema de Montaje en OneGeo

La cámara Flir (antes PointGrey) que será empleada en el microscopio
es del modelo Blackfly S USB3, y la referencia es BFS-U3-50S5.
Parte de las especificaciones se presentaron en la sección 1. y
fueron empleadas para determinar las distancias al plano del objeto
y al plano de la imagen.

El link de acceso a la compra es
https://www.flir.com/products/blackfly-s-usb3/?model=BFS-U3-50S5C-C

En lo posible se piensa utilizar las piezas de sujeción de la cámara
al chasis del microscópio que ya existen, pero debe ser modificado
el tubo de extensión para ajustar la distancia del lente a la sensor
a la determinada en la sección 4. procurando tener un sistema que nos
de la oportunidad de hacer un ajuste fino.

Para el diseño del nuevo tubo de extensión se debe tener muy en cuenta
que hay la distancia en la cámara del punto de montaje del lente al
sensor de la cámara, que se conoce como Flange Back Length, que es
igual a 17,53mm según se informa en el enlace

www.flir.com/support-center/iis/machine-vision/application-note/selecting-a-lens-for-your-camera/
