jumorap/Geolo/one_geoV1.2-master/Mechanics/optica/experimento/IMG_20191119_122104.jpg

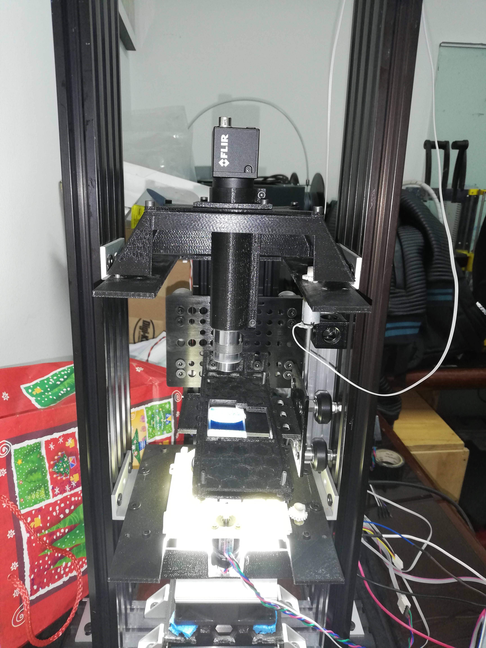
one_geoV1.2-master/Mechanics/optica/experimento/IMG_20191119_122104.jpg
