jumorap/Geolo/one_geoV1.2-master/electrx/mainboard/mainboard.pdf

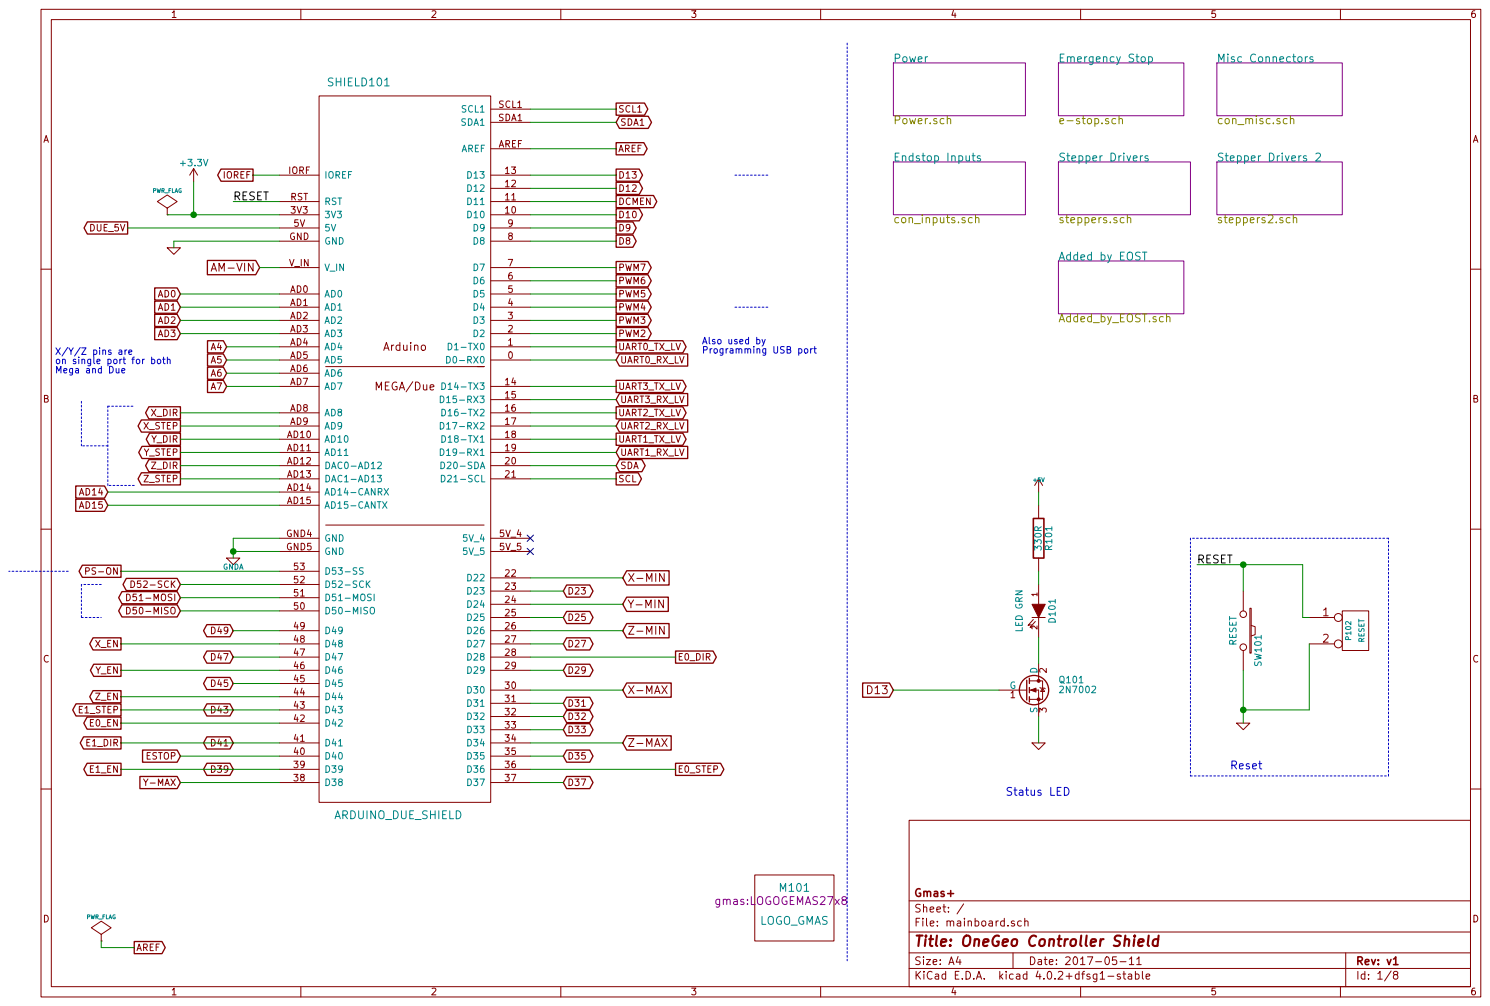
[picture p56: page 1]

X/Y/Z pins are
on single port for both

File: mainboard.sch Sheet: / Gmas+

Id: 1/8 Title: OneGeo Controller Shield

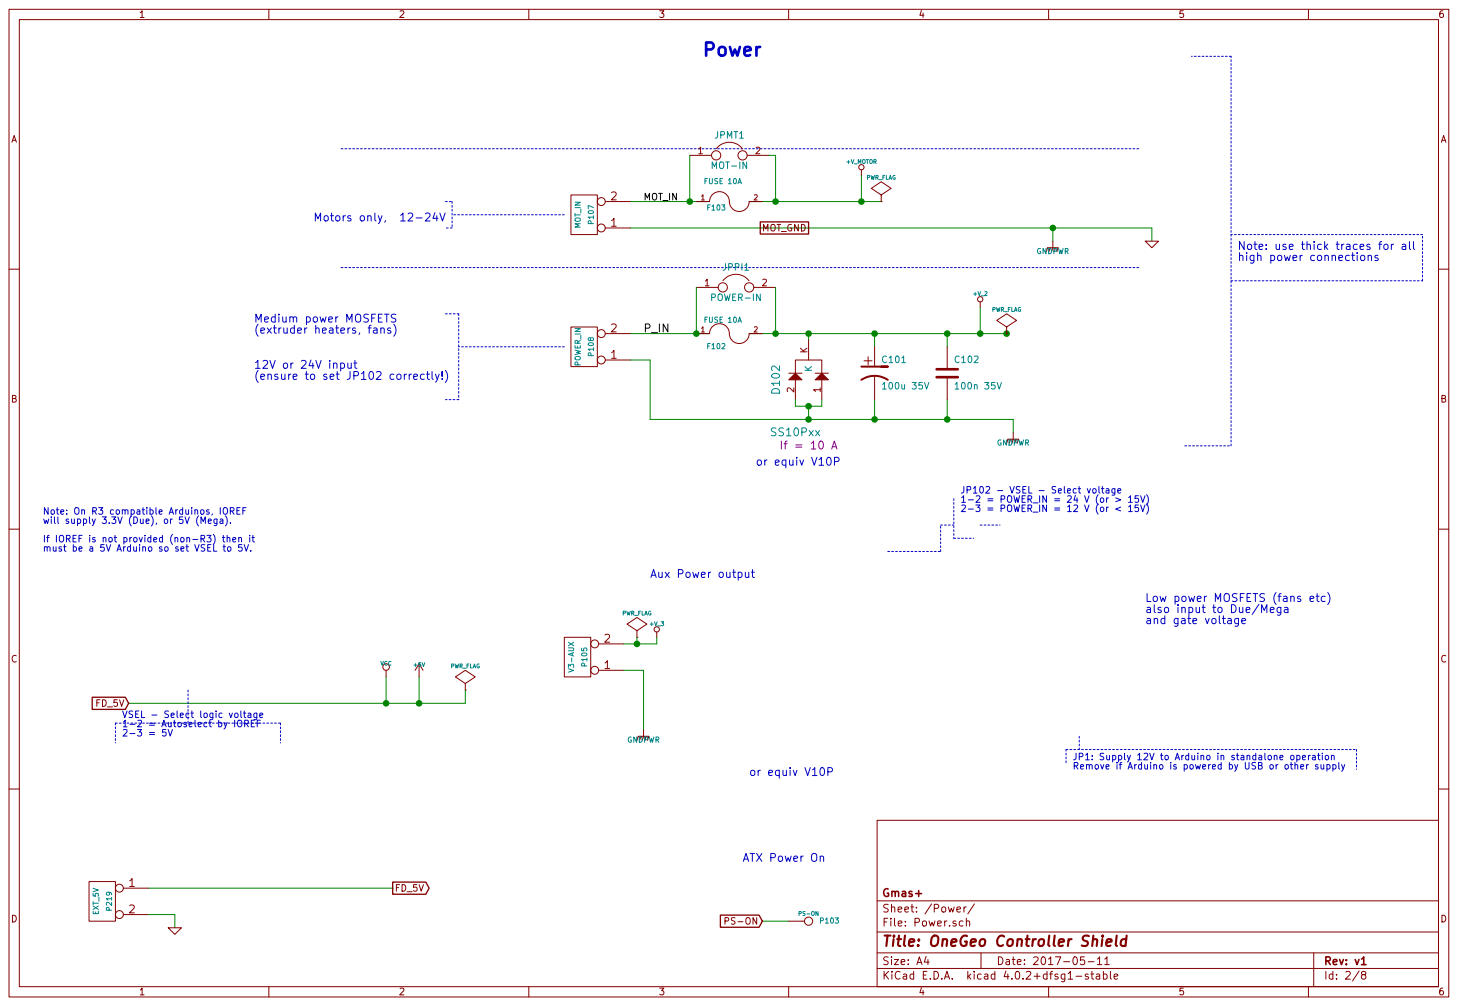
[picture p57: page 2]

Remove if Arduino is powered by USB or other supply Note: use thick traces for all high power connections

12V or 24V input
(ensure to set JP102 correctly!)

Note: On R3 compatible Arduinos, IOREF
will supply 3.3V (Due), or 5V (Mega).

Aux Power output VCC VSEL - Select logic voltage

Low power MOSFETS (fans etc)
also input to Due/Mega
and gate voltage

JP1: Supply 12V to Arduino in standalone operation

File: Power.sch Sheet: /Power/ Gmas+

Id: 2/8 Title: OneGeo Controller Shield

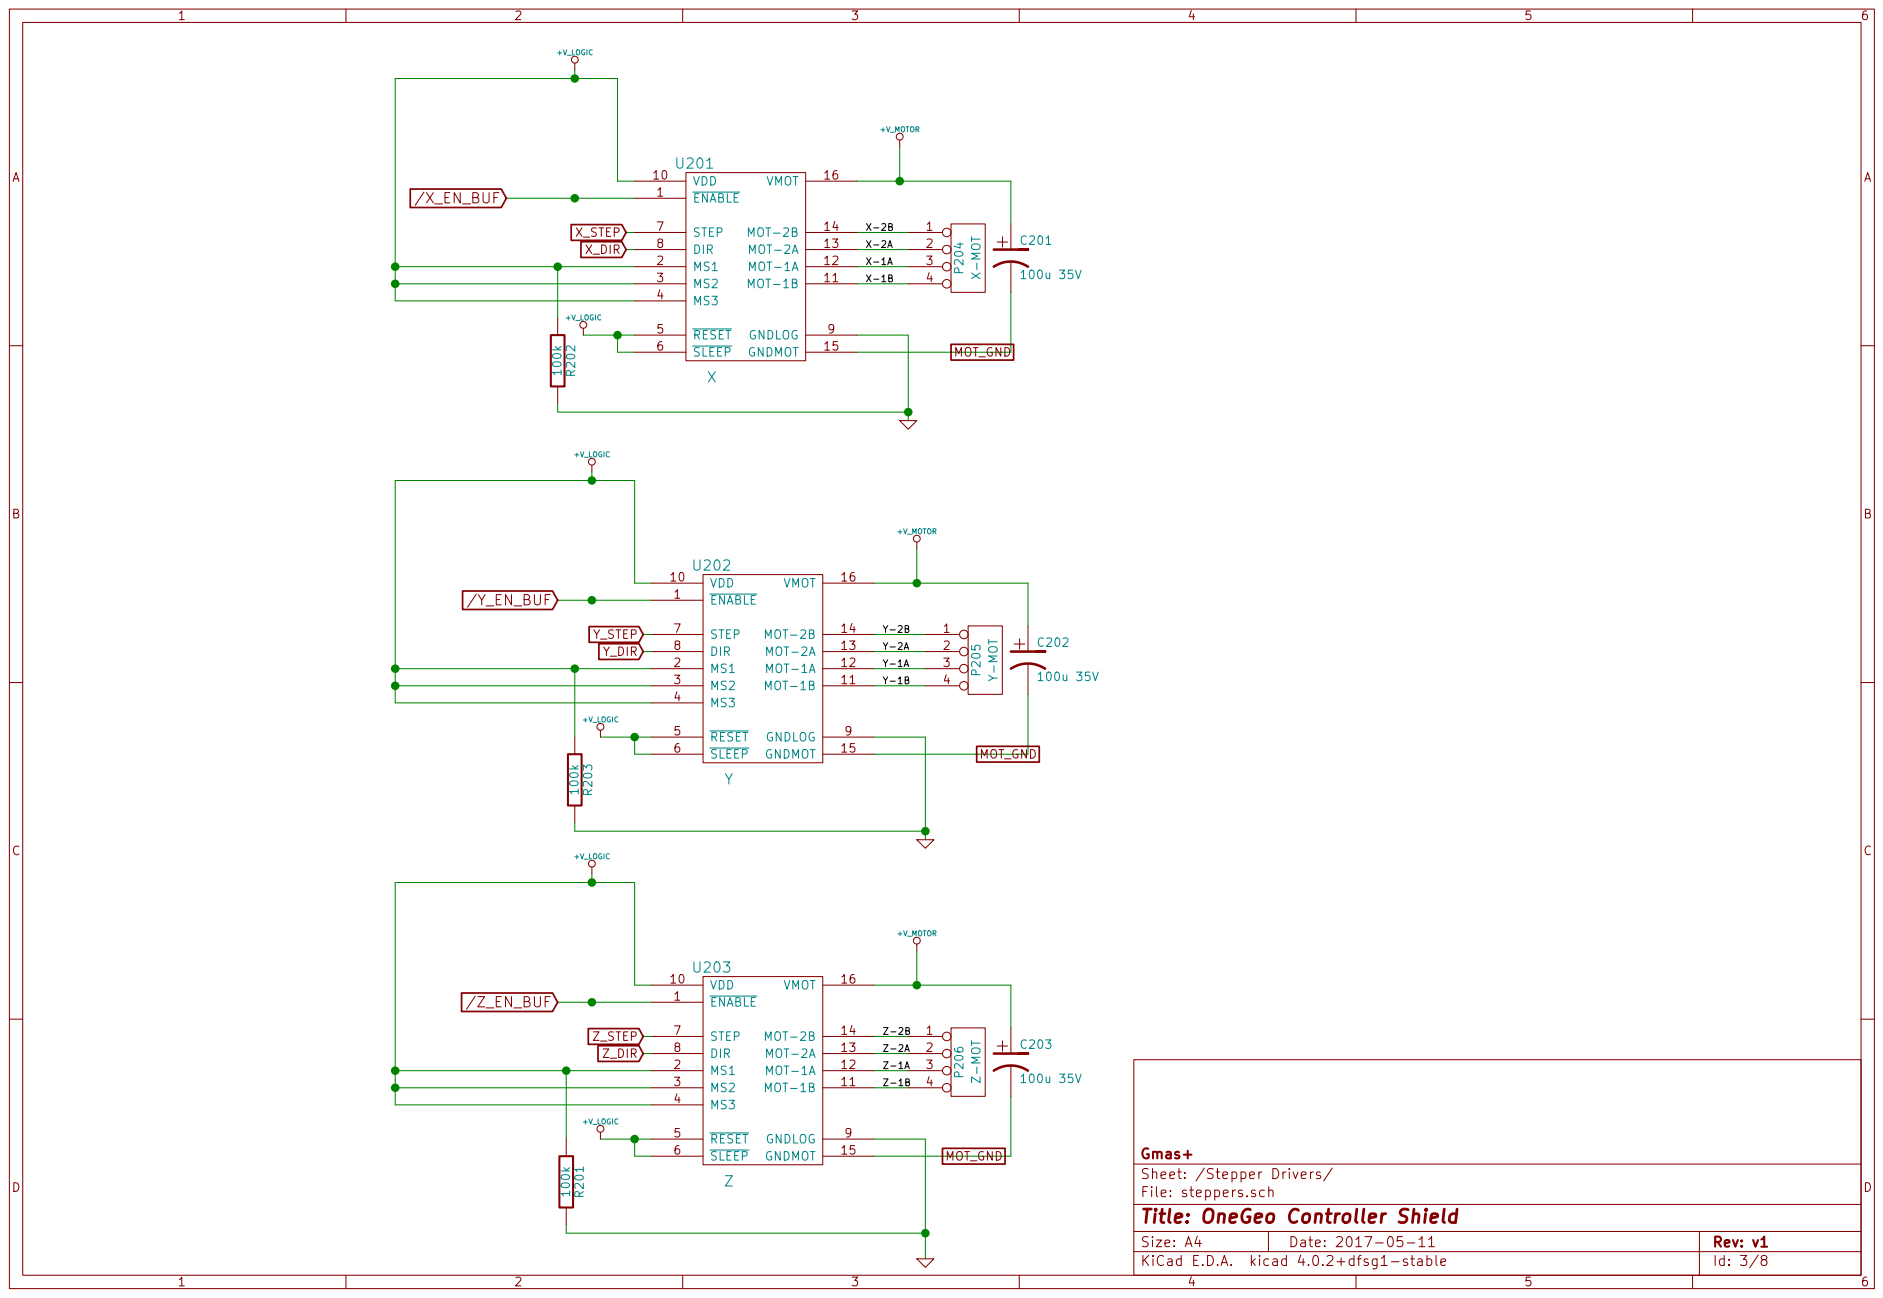
[picture p58: page 3]

Sheet: /Stepper Drivers/ Gmas+

File: steppers.sch
Id: 3/8 Title: OneGeo Controller Shield

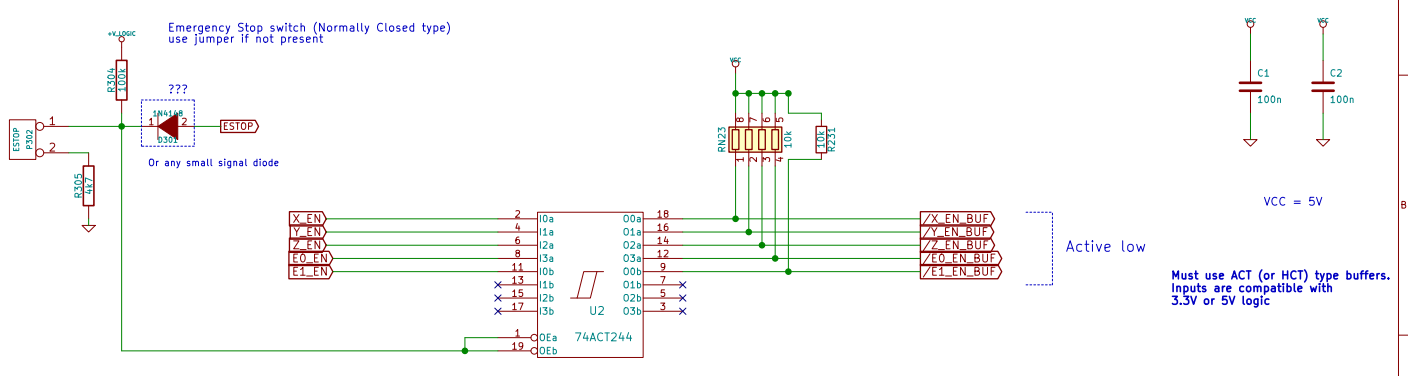
[picture p59: page 4]

VCC Emergency Stop switch (Normally Closed type)

Or any small signal diode

Must use ACT (or HCT) type buffers.
Inputs are compatible with
3.3V or 5V logic

Sheet: /Emergency Stop/ Gmas+

File: e-stop.sch
Id: 4/8 Title: OneGeo Controller Shield

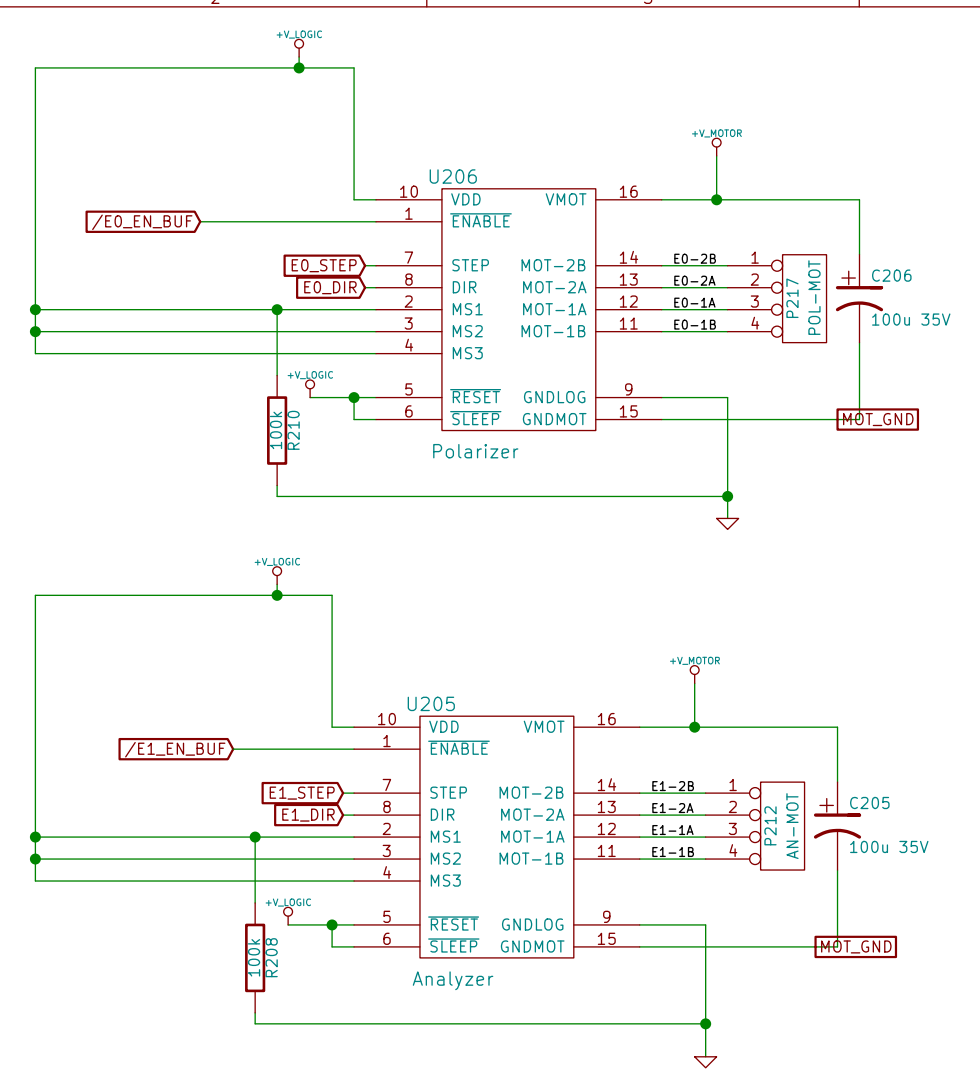
[picture p60: page 5]

Sheet: /Stepper Drivers 2/ Gmas+

File: steppers2.sch
Id: 5/8 Title: OneGeo Controller Shield

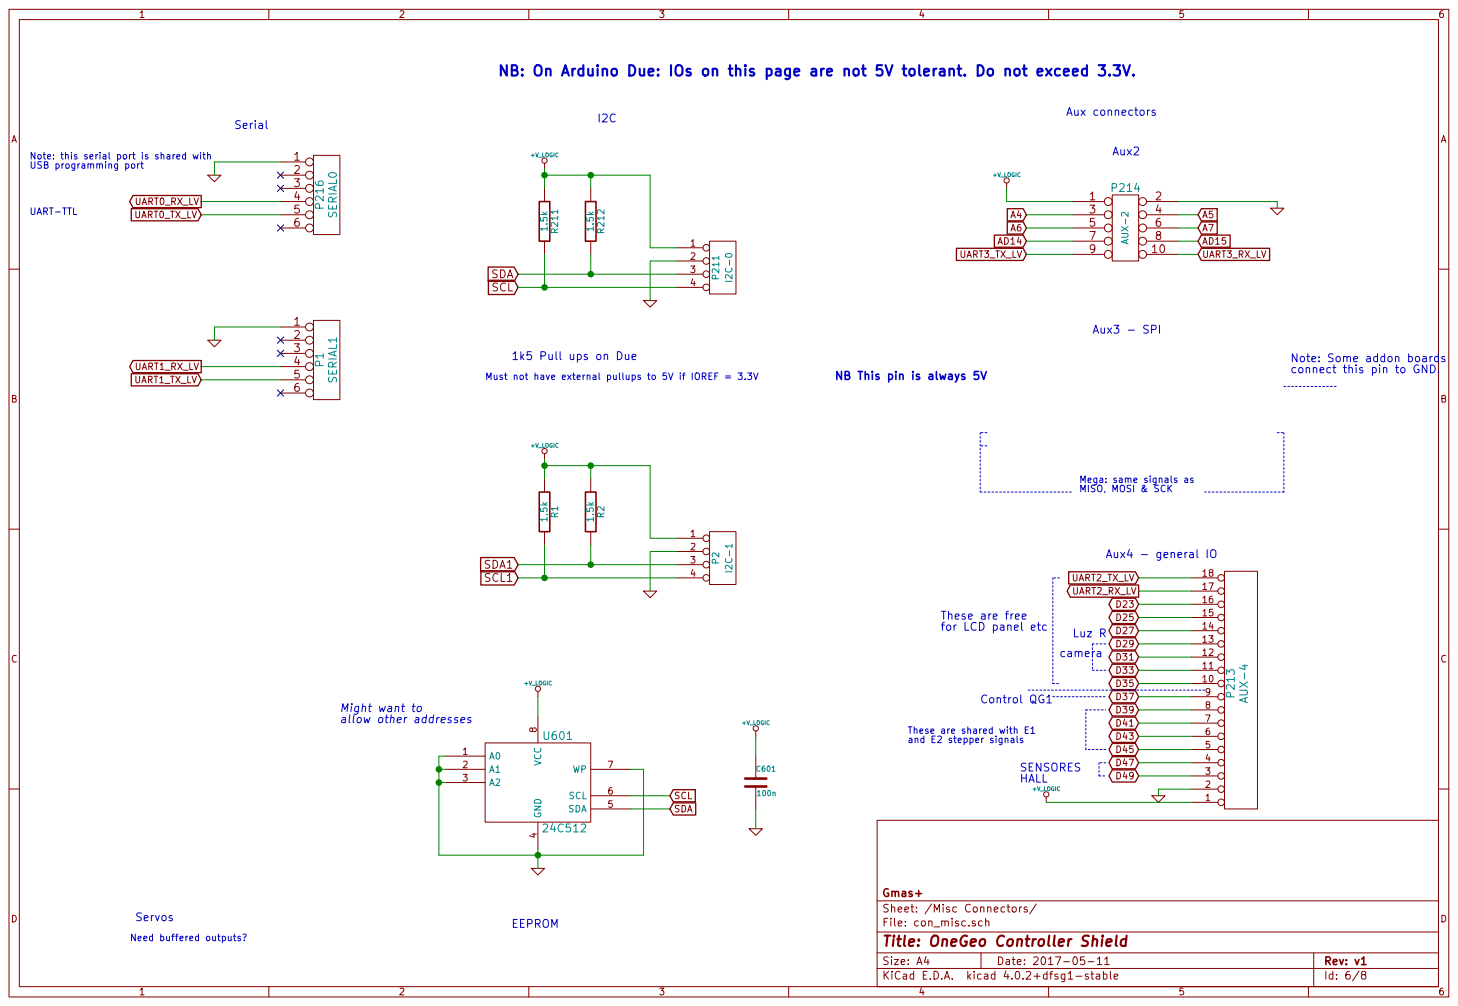
[picture p61: page 6]

NB: On Arduino Due: IOs on this page are not 5V tolerant. Do not exceed 3.3V.

Note: this serial port is shared with

Note: Some addon boards

connect this pin to GND. GND

Mega: same signals as MISO, MOSI & SCK D49 NB This pin is always 5V

These are free
for LCD panel etc

These are shared with E1 and E2 stepper signals

File: con_misc.sch Sheet: /Misc Connectors/ Gmas+

Id: 6/8 Title: OneGeo Controller Shield

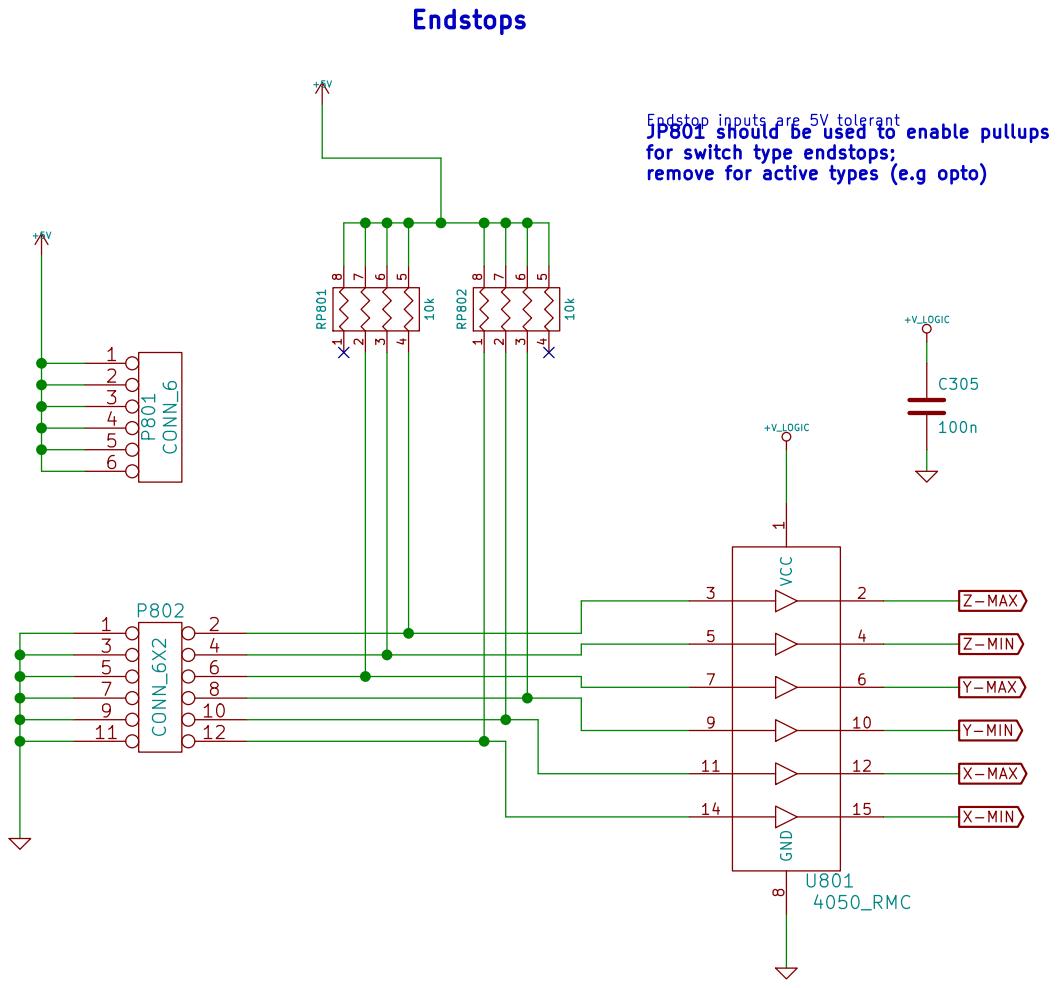
[picture p62: page 7]

JP801 should be used to enable pullups
for switch type endstops;
remove for active types (e.g opto)

Sheet: /Endstop Inputs/ Gmas+

File: con_inputs.sch
Id: 7/8 Title: OneGeo Controller Shield

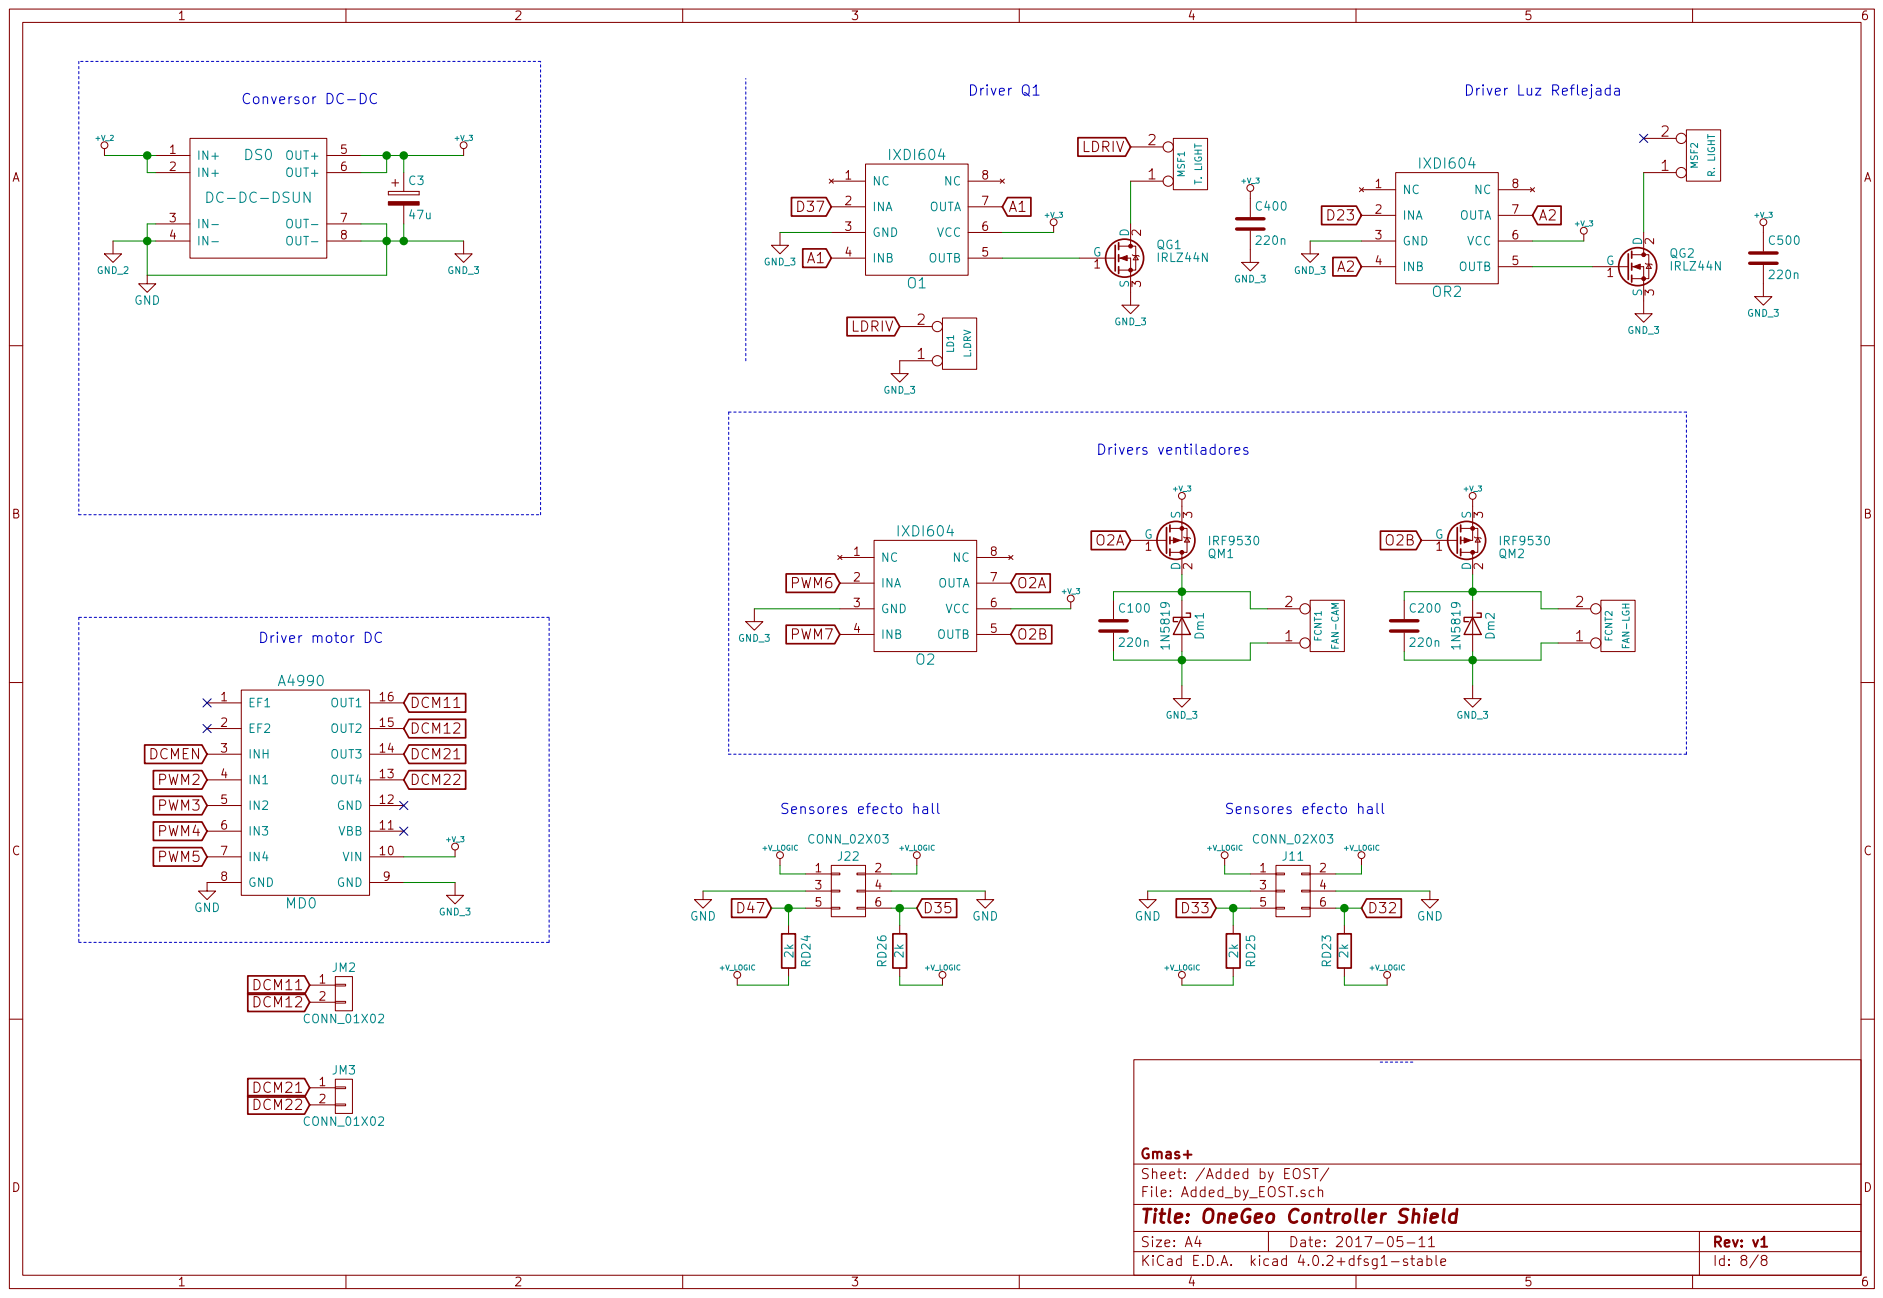
[picture p63: page 8]

Sheet: /Added by EOST/ Gmas+

File: Added_by_EOST.sch
Id: 8/8 Title: OneGeo Controller Shield
