jumorap/Geolo/one_geoV1.2-master/electrx/mainboard/OneGeo/mainboard-F.Paste.pdf

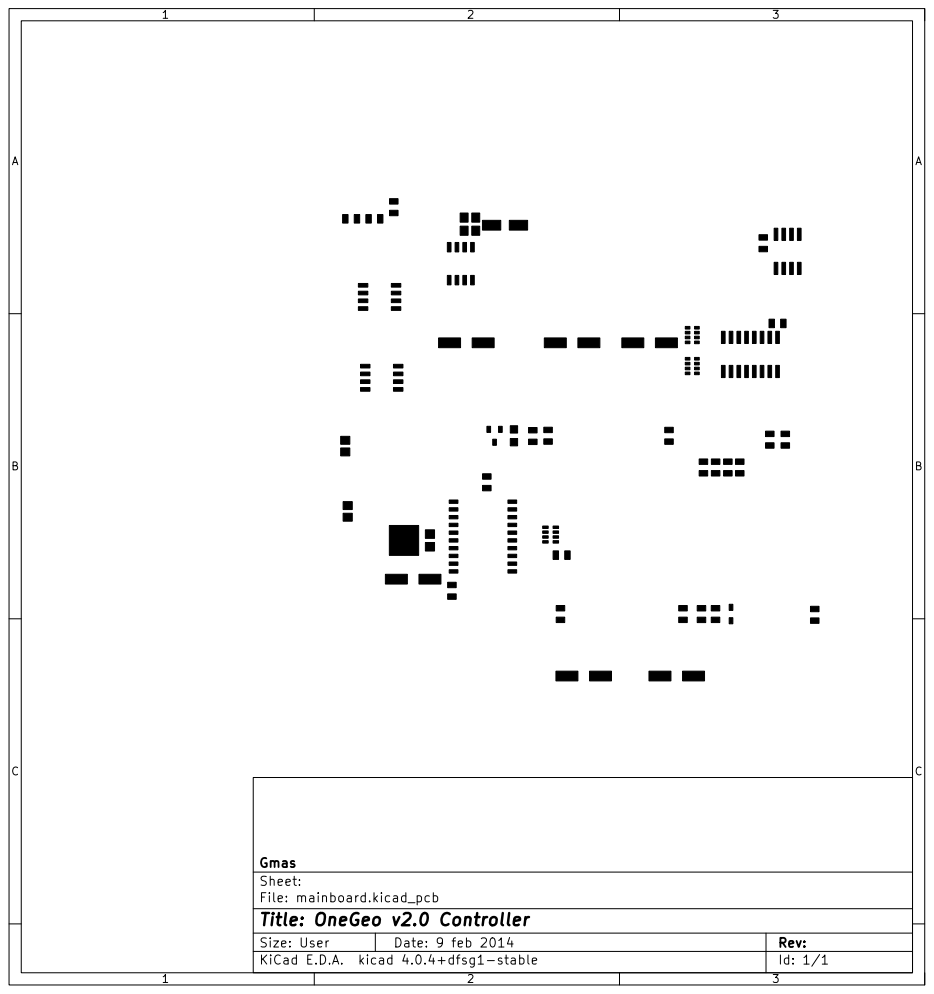
[picture p67: page 1]

File: mainboard.kicad_pcb Sheet: Gmas

Id: 1/1 Title: OneGeo v2.0 Controller
