jumorap/Geolo/one_geoV1.2-master/electrx/mainboard/OneGeo/mainboard-Front.pdf

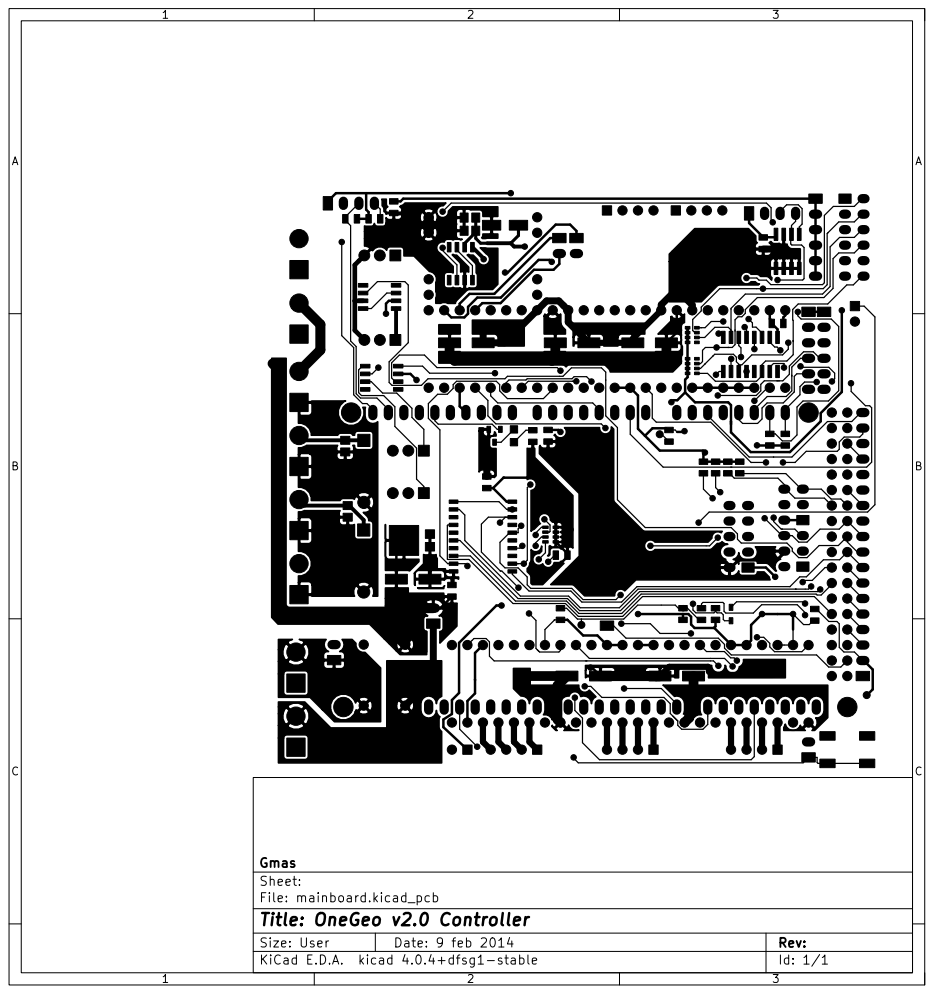
[picture p68: page 1]

File: mainboard.kicad_pcb Sheet: Gmas

Id: 1/1 Title: OneGeo v2.0 Controller
