jumorap/Geolo/one_geoV1.2-master/electrx/mainboard/OneGeo/mainboard-F.SilkS.pdf

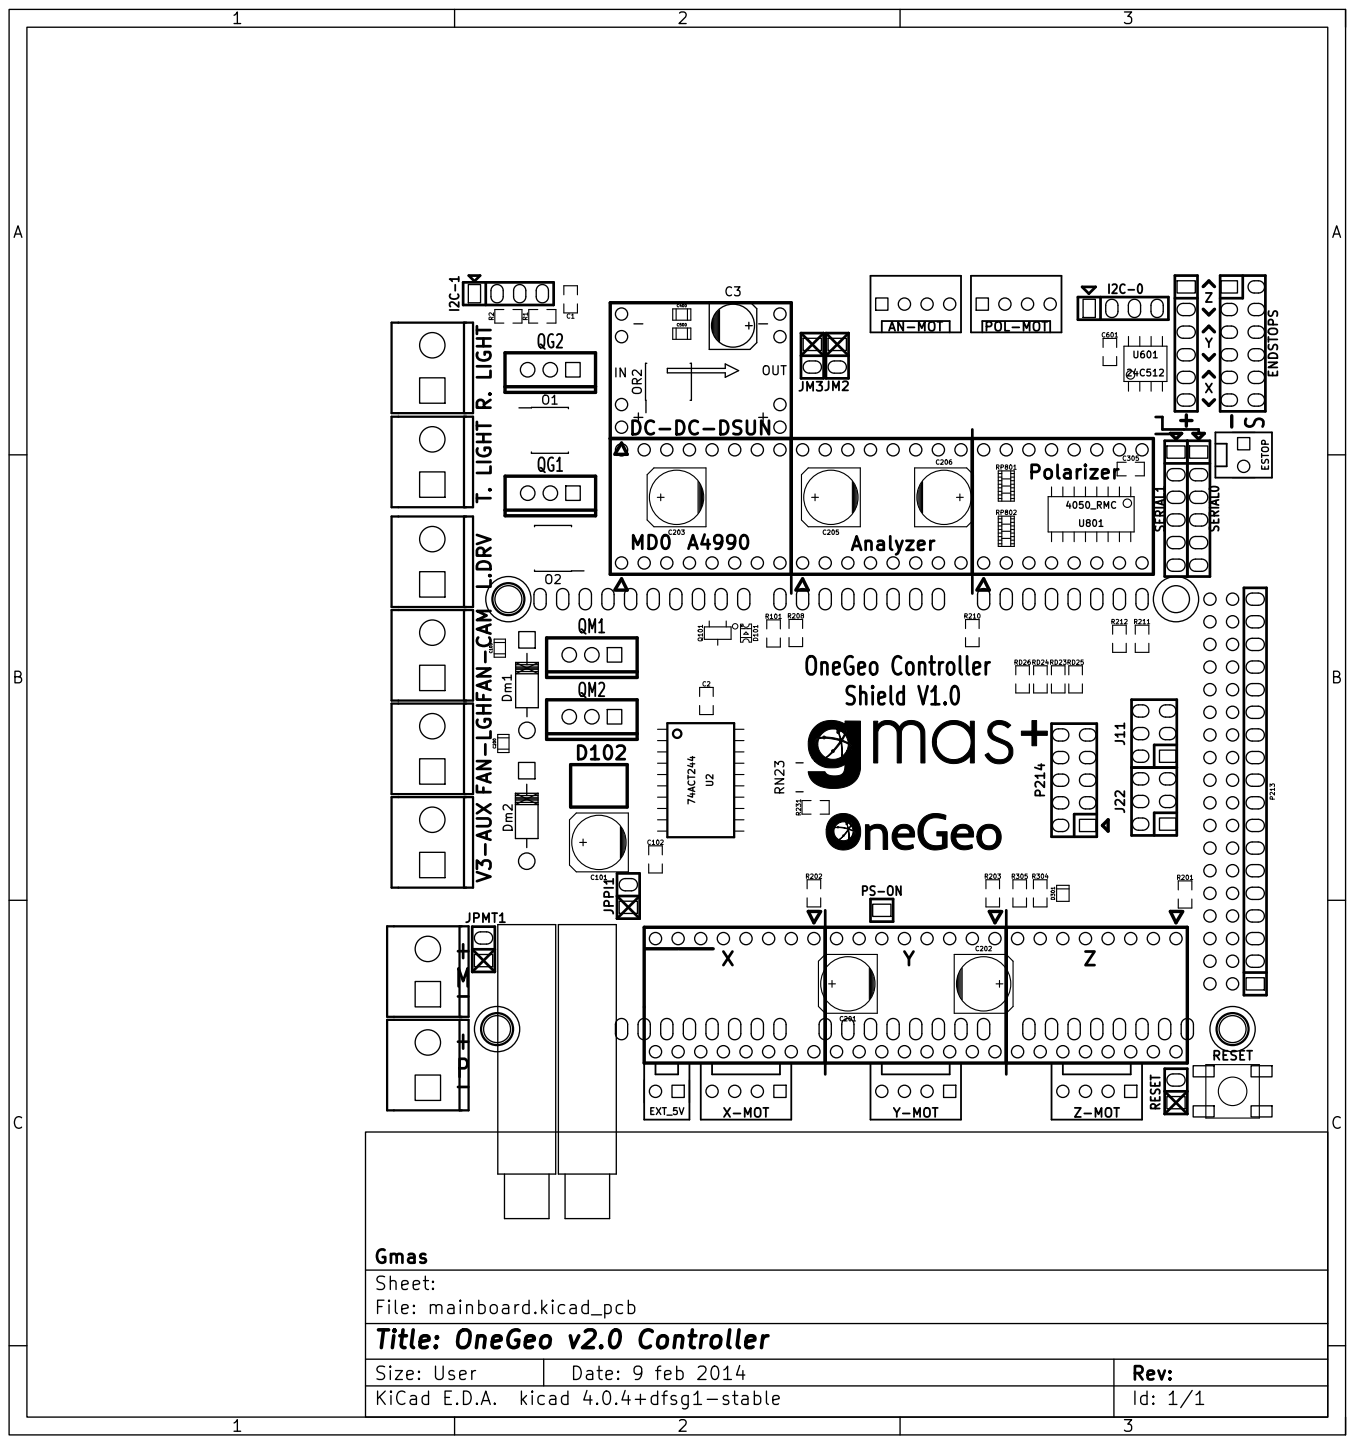
[picture p69: page 1]

Id: 1/1 Title: OneGeo v2.0 Controller
