jumorap/Geolo/(list of files, drawings)

Other design files:
one_geoV1.2-master/electrx/mainboard/routing file.dsn
one_geoV1.2-master/electrx/RAMPS-FD/RAMPS-FD.dsn
