jumorap/Geolo/one_geoV1.2-master/electrx/mainboard/mainboard.kicad_pcb

## KiCad design one_geoV1.2-master/electrx/mainboard/mainboard.kicad_pcb (2020-01-25)

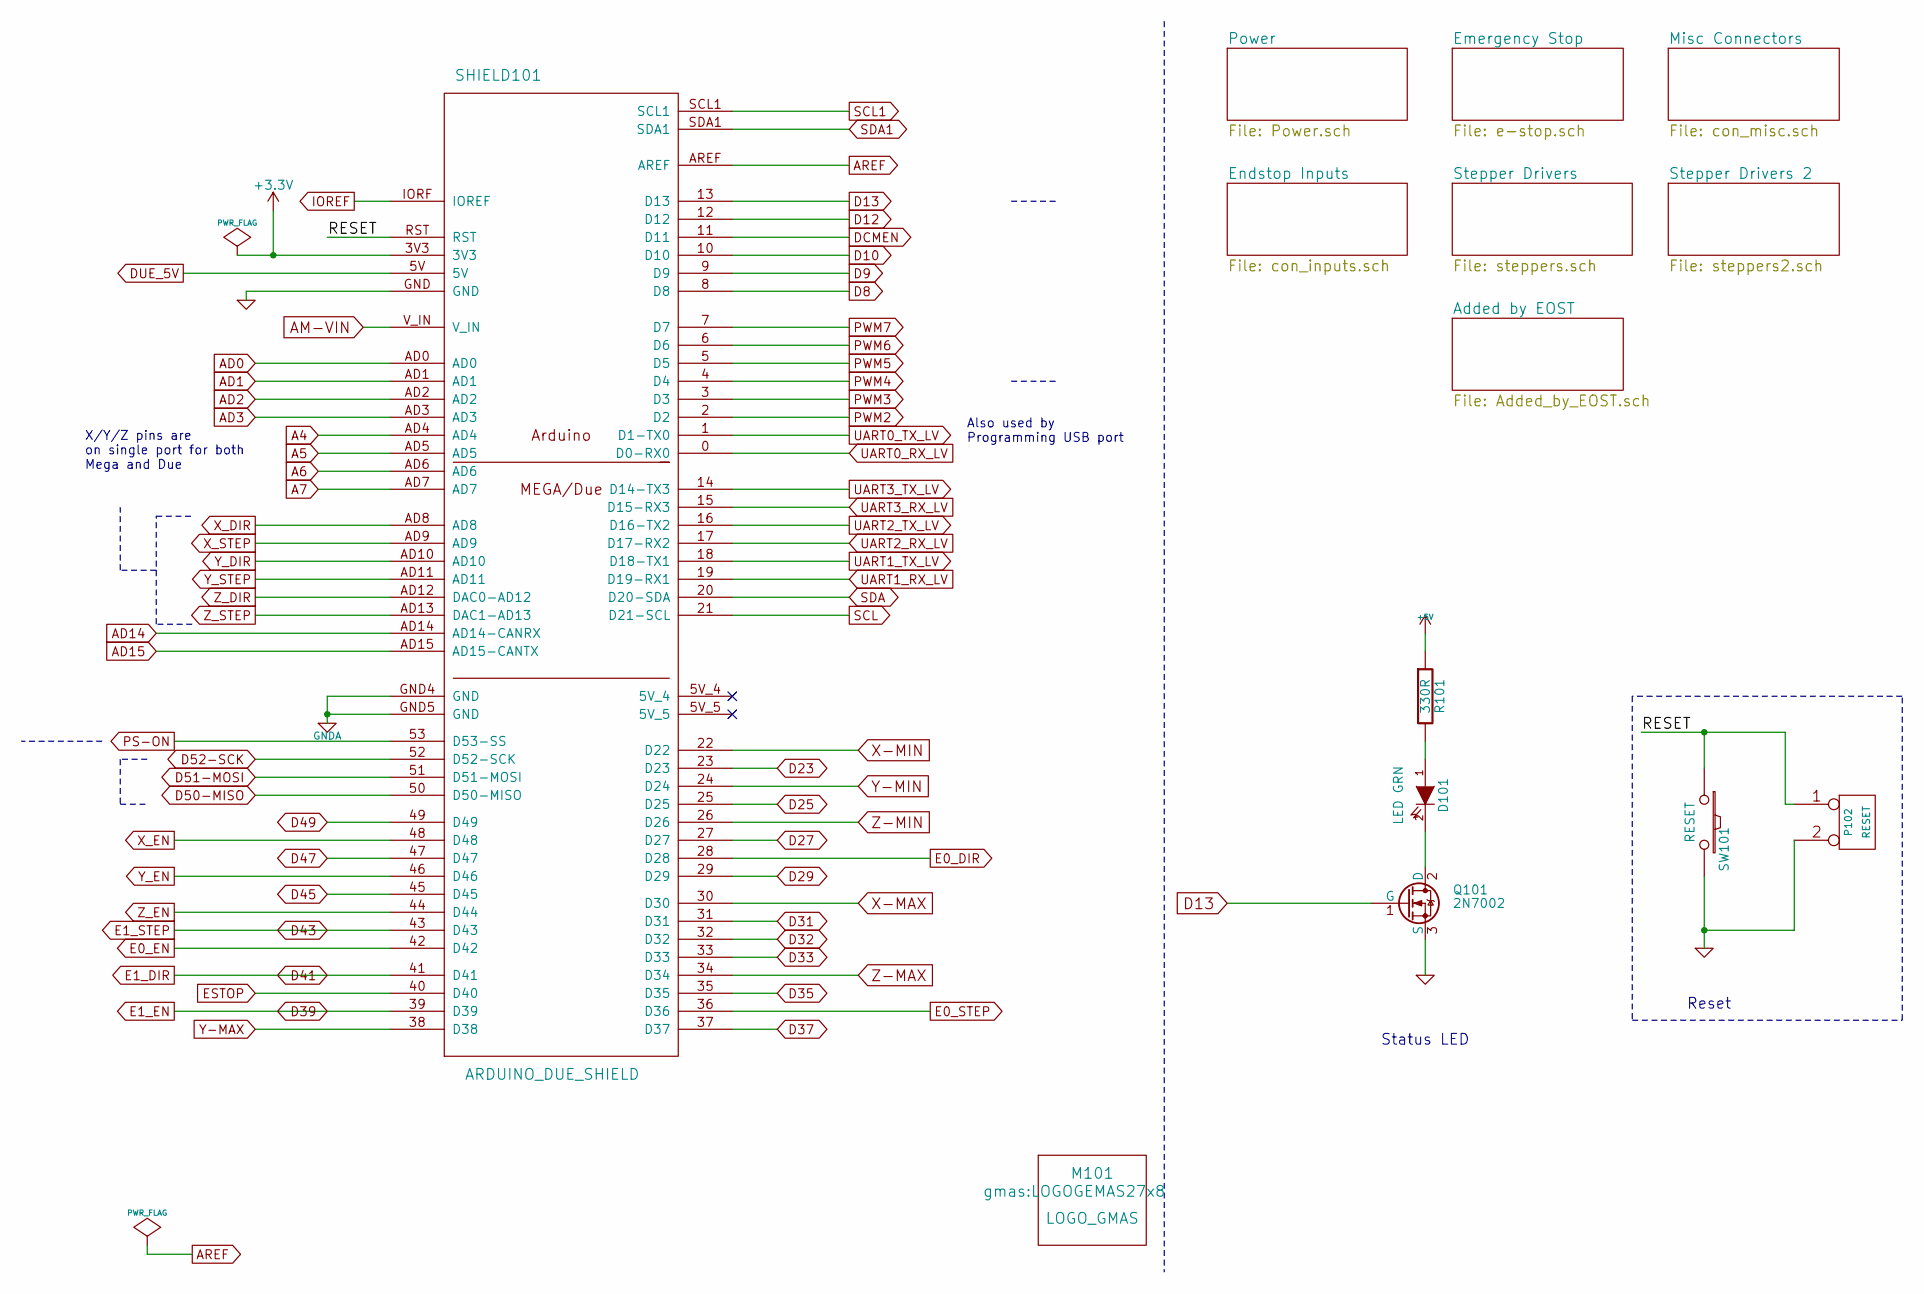
[picture p70: schematic mainboard.sch, OneGeo Controller Shield]

Parts:
D101: LED GRN; LED-0805_GREEN
M101: LOGO_GMAS; LOGOGEMAS27x8
P102: RESET; pin_strip_2
Q101: 2N7002; sot23
R101: 330R; SM0805_Opendous
SHIELD101: ARDUINO_DUE_SHIELD; ARDUINO_MEGA_DUE_SHIELD_FOOTPRINT_RMC
SW101: RESET; SW_6x6_MULTI

Connections:
+3V3: SHIELD101.3V3
/RESET: P102.1, SHIELD101.RST, SW101.1
A4: SHIELD101.AD4; also elsewhere on the board
A5: SHIELD101.AD5; also elsewhere on the board
A6: SHIELD101.AD6; also elsewhere on the board
A7: SHIELD101.AD7; also elsewhere on the board
AD0: SHIELD101.AD0
AD1: SHIELD101.AD1
AD2: SHIELD101.AD2
AD3: SHIELD101.AD3
AD14: SHIELD101.AD14 (AD14-CANRX); also elsewhere on the board
AD15: SHIELD101.AD15 (AD15-CANTX); also elsewhere on the board
AM-VIN: SHIELD101.V_IN
AREF: SHIELD101.AREF
D8: SHIELD101.8 (D8)
D9: SHIELD101.9 (D9)
D10: SHIELD101.10 (D10)
D12: SHIELD101.12 (D12)
D13: Q101.1 (G), SHIELD101.13 (D13)
D23: SHIELD101.23 (D23); also elsewhere on the board
D25: SHIELD101.25 (D25); also elsewhere on the board
D27: SHIELD101.27 (D27); also elsewhere on the board
D29: SHIELD101.29 (D29); also elsewhere on the board
D31: SHIELD101.31 (D31); also elsewhere on the board
D32: SHIELD101.32 (D32); also elsewhere on the board
D33: SHIELD101.33 (D33); also elsewhere on the board
D35: SHIELD101.35 (D35); also elsewhere on the board
D37: SHIELD101.37 (D37); also elsewhere on the board
D39: SHIELD101.39 (D39); also elsewhere on the board
D41: SHIELD101.41 (D41); also elsewhere on the board
D43: SHIELD101.43 (D43); also elsewhere on the board
D45: SHIELD101.45 (D45); also elsewhere on the board
D47: SHIELD101.47 (D47); also elsewhere on the board
D49: SHIELD101.49 (D49); also elsewhere on the board
D50-MISO: SHIELD101.50 (D50-MISO)
D51-MOSI: SHIELD101.51 (D51-MOSI)
D52-SCK: SHIELD101.52 (D52-SCK)
DCMEN: SHIELD101.11 (D11); also elsewhere on the board
DUE_5V: SHIELD101.5V
E0_DIR: SHIELD101.28 (D28); also elsewhere on the board
E0_EN: SHIELD101.42 (D42); also elsewhere on the board
E0_STEP: SHIELD101.36 (D36); also elsewhere on the board
ESTOP: SHIELD101.40 (D40); also elsewhere on the board
FD_5V: R101.1; also elsewhere on the board
GNDA: SHIELD101.GND4 (GND), SHIELD101.GND5 (GND)
IOREF: SHIELD101.IORF (IOREF)
MOT_GND: P102.2 (PM), Q101.3 (S), SHIELD101.GND, SW101.2; also elsewhere on the board
unnamed: D101.1 (A), R101.2
unnamed: D101.2 (K), Q101.2 (D)
PS-ON: SHIELD101.53 (D53-SS); also elsewhere on the board
PWM2: SHIELD101.2 (D2); also elsewhere on the board
PWM3: SHIELD101.3 (D3); also elsewhere on the board
PWM4: SHIELD101.4 (D4); also elsewhere on the board
PWM5: SHIELD101.5 (D5); also elsewhere on the board
PWM6: SHIELD101.6 (D6); also elsewhere on the board
PWM7: SHIELD101.7 (D7); also elsewhere on the board
SCL: SHIELD101.21 (D21-SCL); also elsewhere on the board
SCL1: SHIELD101.SCL1; also elsewhere on the board
SDA: SHIELD101.20 (D20-SDA); also elsewhere on the board
SDA1: SHIELD101.SDA1; also elsewhere on the board
UART0_RX_LV: SHIELD101.0 (D0-RX0); also elsewhere on the board
UART0_TX_LV: SHIELD101.1 (D1-TX0); also elsewhere on the board
UART1_RX_LV: SHIELD101.19 (D19-RX1); also elsewhere on the board
UART1_TX_LV: SHIELD101.18 (D18-TX1); also elsewhere on the board
UART2_RX_LV: SHIELD101.17 (D17-RX2); also elsewhere on the board
UART2_TX_LV: SHIELD101.16 (D16-TX2); also elsewhere on the board
UART3_RX_LV: SHIELD101.15 (D15-RX3); also elsewhere on the board
UART3_TX_LV: SHIELD101.14 (D14-TX3); also elsewhere on the board
X-MAX: SHIELD101.30 (D30); also elsewhere on the board
X-MIN: SHIELD101.22 (D22); also elsewhere on the board
X_DIR: SHIELD101.AD8; also elsewhere on the board
X_EN: SHIELD101.48 (D48); also elsewhere on the board
X_STEP: SHIELD101.AD9; also elsewhere on the board
Y-MAX: SHIELD101.38 (D38); also elsewhere on the board
Y-MIN: SHIELD101.24 (D24); also elsewhere on the board
Y_DIR: SHIELD101.AD10; also elsewhere on the board
Y_EN: SHIELD101.46 (D46); also elsewhere on the board
Y_STEP: SHIELD101.AD11; also elsewhere on the board
Z-MAX: SHIELD101.34 (D34); also elsewhere on the board
Z-MIN: SHIELD101.26 (D26); also elsewhere on the board
Z_DIR: SHIELD101.AD12 (DAC0-AD12); also elsewhere on the board
Z_EN: SHIELD101.44 (D44); also elsewhere on the board
Z_STEP: SHIELD101.AD13 (DAC1-AD13); also elsewhere on the board

Notes on the sheet:
Also used by Programming USB port
X/Y/Z pins are on single port for both Mega and Due
Reset
Status LED

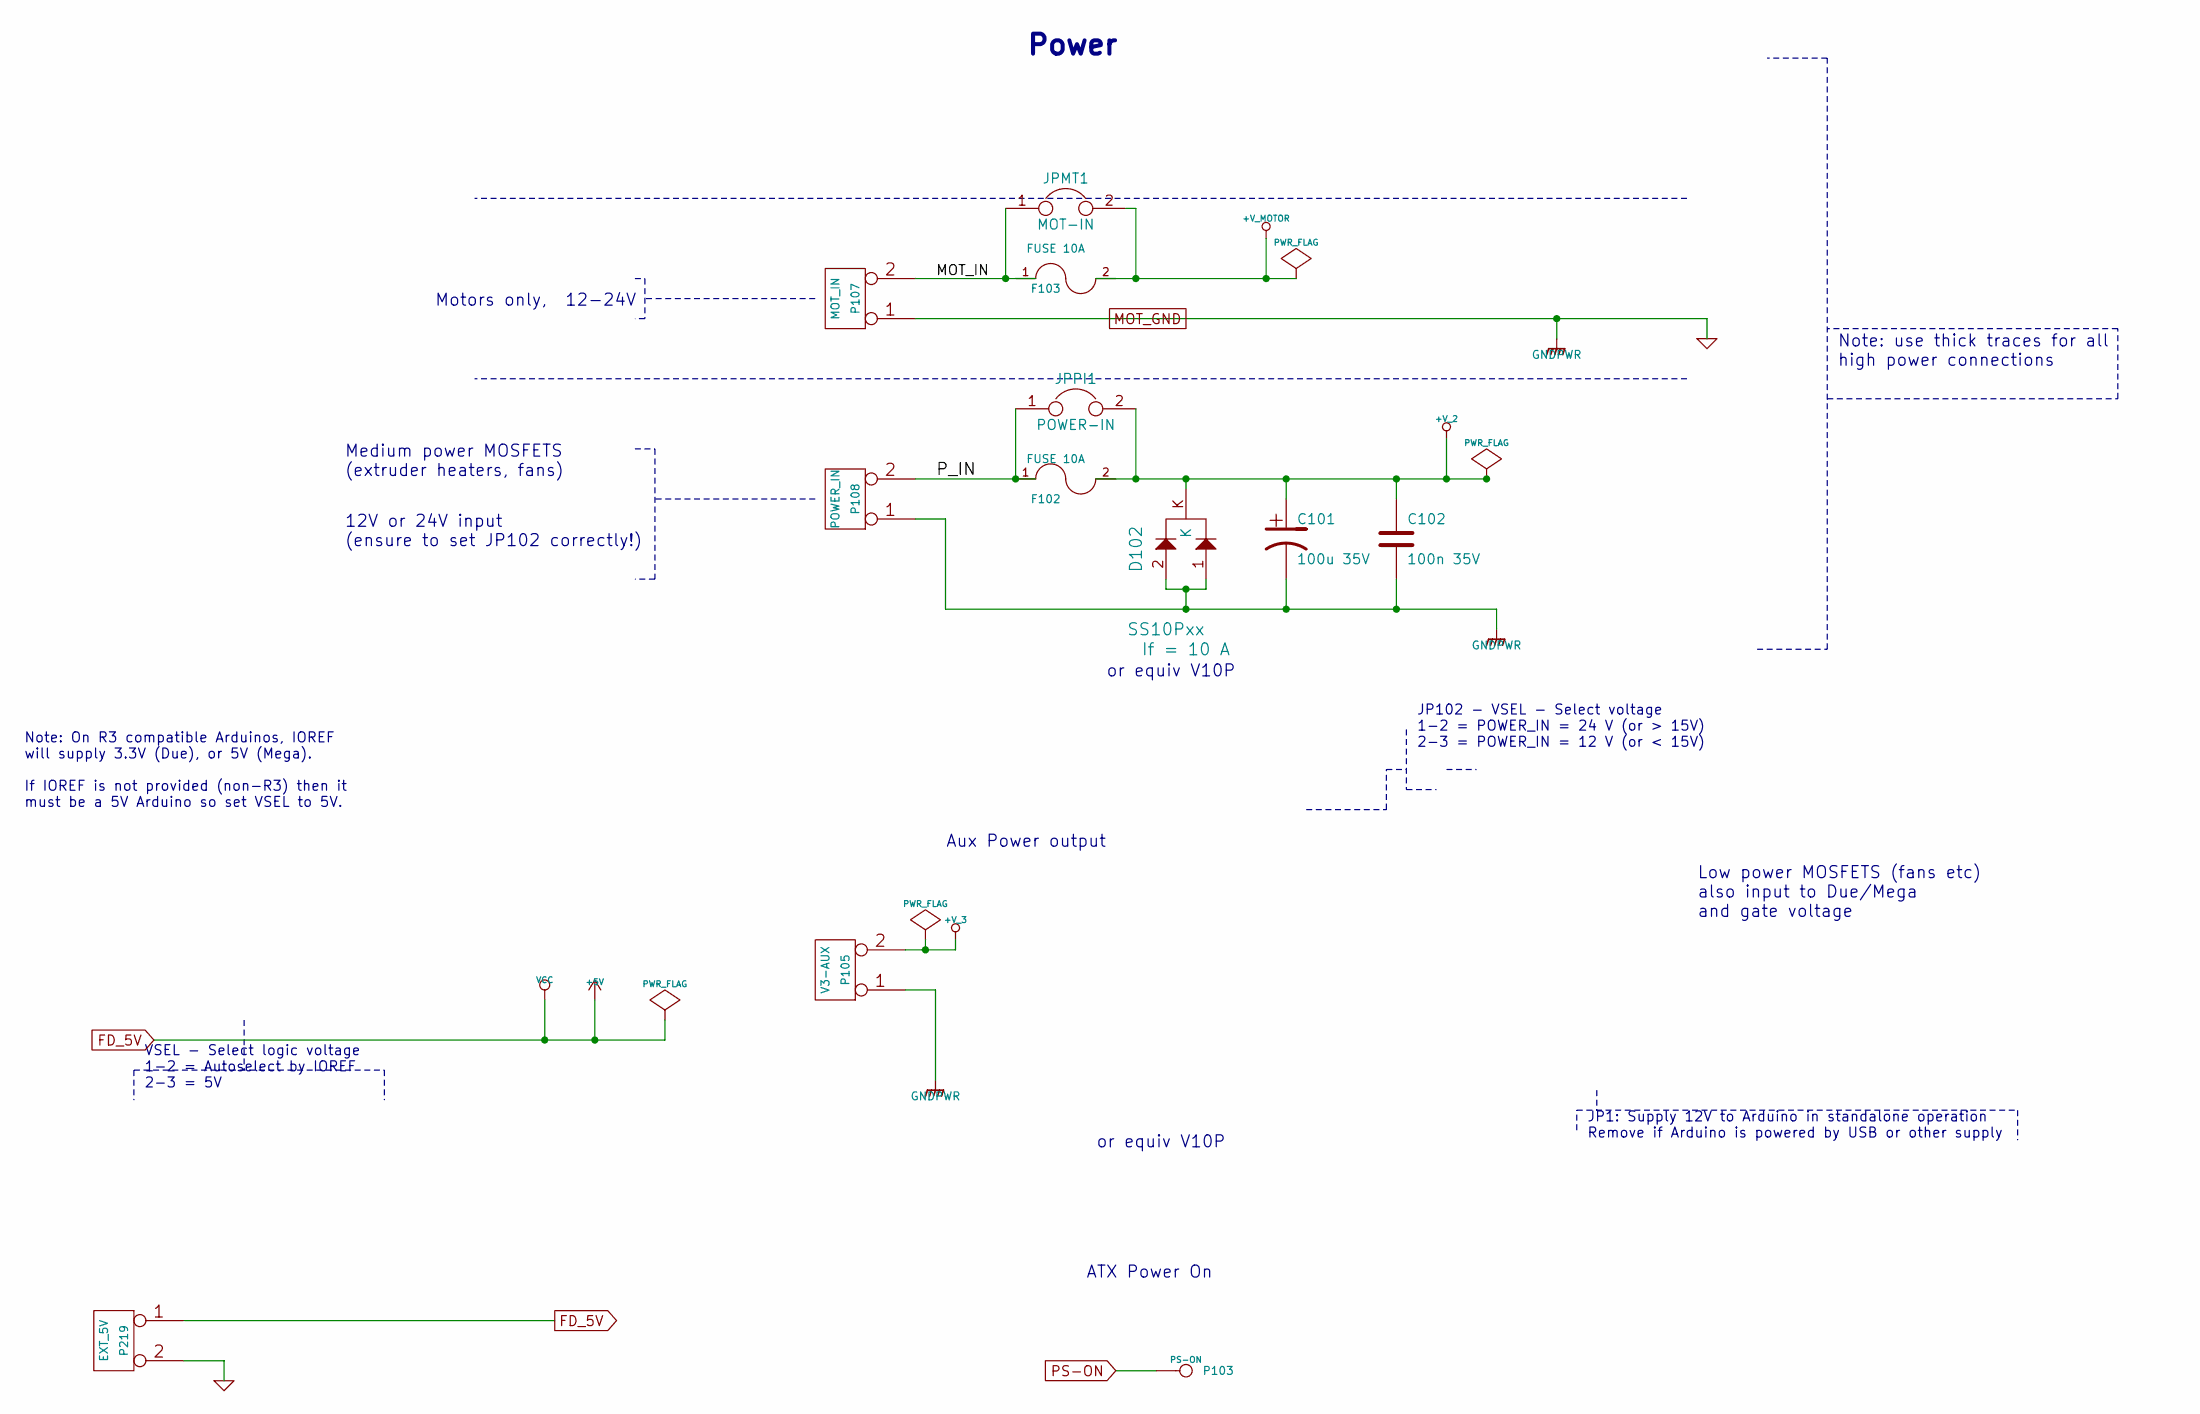
[picture p71: schematic Power.sch, OneGeo Controller Shield]

Parts:
C101: 100u 35V; c_elec_6.3x7.7
C102: 100n 35V; SM0805_Opendous
D102: SS10Pxx; TO277A_RMC
F102, F103: FUSE 10A; Fuse_Holder_bayoneta
JPMT1: MOT-IN; pin_socket_2
JPPI1: POWER-IN; pin_socket_2
P103: PS-ON; pin_strip_1
P105: V3-AUX; mors_2p
P107: MOT_IN; mors_2p
P108: POWER_IN; mors_2p
P219: EXT_5V; CONN_KK_2.54_2W

Connections:
+V_2: C101.1, C102.1, D102.K, F102.2, JPPI1.2; also elsewhere on the board
+V_3: P105.2 (PM); also elsewhere on the board
+V_MOTOR: F103.2, JPMT1.2; also elsewhere on the board
/Power/MOT_IN: F103.1, JPMT1.1, P107.2 (PM)
/Power/P_IN: F102.1, JPPI1.1, P108.2 (PM)
FD_5V: P219.1; also elsewhere on the board
MOT_GND: C101.2, C102.2, D102.1, D102.2, P105.1, P107.1, P108.1, P219.2 (PM); also elsewhere on the board
PS-ON: P103.1; also elsewhere on the board

Notes on the sheet:
JP102 - VSEL - Select voltage 1-2 = POWER_IN = 24 V (or > 15V) 2-3 = POWER_IN = 12 V (or < 15V)
Low power MOSFETS (fans etc) also input to Due/Mega and gate voltage
Aux Power output
VSEL - Select logic voltage 1-2 = Autoselect by IOREF 2-3 = 5V
Note: On R3 compatible Arduinos, IOREF will supply 3.3V (Due), or 5V (Mega). If IOREF is not provided (non-R3) then it must be a 5V Arduino so set VSEL to 5V.
Medium power MOSFETS (extruder heaters, fans)
Motors only, 12-24V
Power
JP1: Supply 12V to Arduino in standalone operation Remove if Arduino is powered by USB or other supply
Note: use thick traces for all high power connections
12V or 24V input (ensure to set JP102 correctly!)
ATX Power On
or equiv V10P

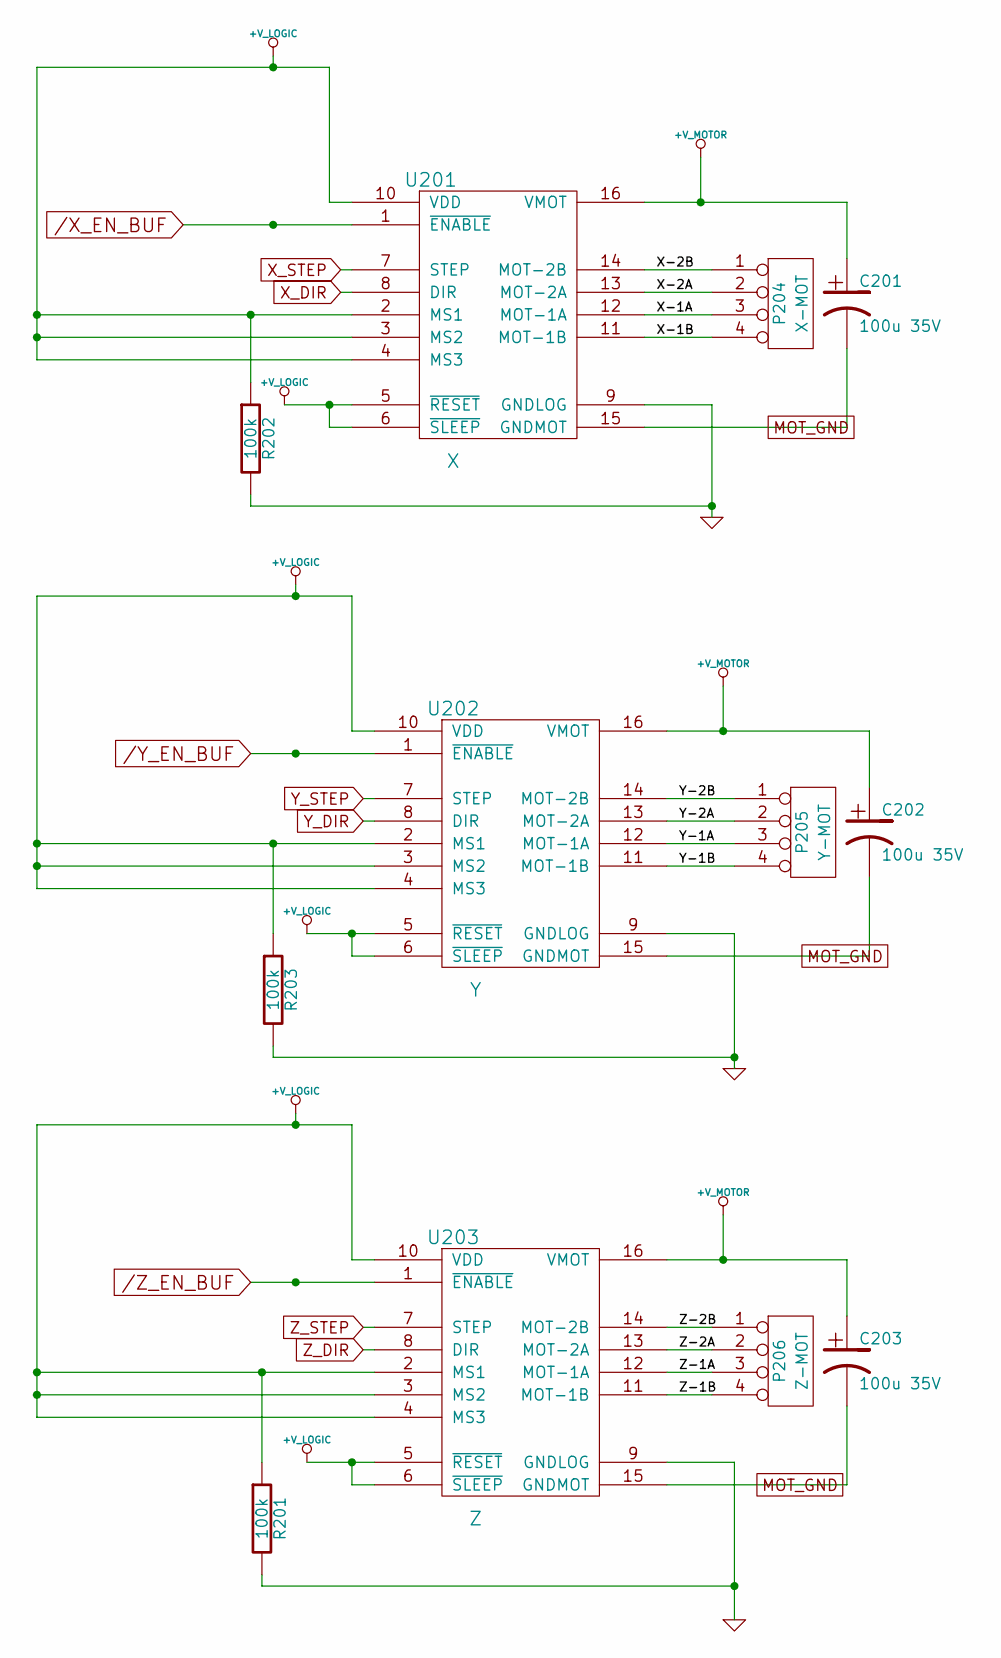
[picture p72: schematic steppers.sch, OneGeo Controller Shield]

Parts:
C201, C202, C203: 100u 35V; c_elec_6.3x7.7
P204: X-MOT; CONN_KK_2.54_4W
P205: Y-MOT; CONN_KK_2.54_4W
P206: Z-MOT; CONN_KK_2.54_4W
R201, R202, R203: 100k; SM0805_Opendous
U201: X; POLOLU
U202: Y; POLOLU
U203: Z; POLOLU

Connections:
+V_LOGIC: R201.1, R202.1, R203.1, U201.2 (MS1), U201.3 (MS2), U201.4 (MS3), U201.5 (~RESET), U201.6 (~SLEEP), U201.10 (VDD), U202.2 (MS1), U202.3 (MS2), U202.4 (MS3), U202.5 (~RESET), U202.6 (~SLEEP), U202.10 (VDD), U203.2 (MS1), U203.3 (MS2), U203.4 (MS3), U203.5 (~RESET), U203.6 (~SLEEP), U203.10 (VDD); also elsewhere on the board
+V_MOTOR: C201.1, C202.1, C203.1, U201.16 (VMOT), U202.16 (VMOT), U203.16 (VMOT); also elsewhere on the board
/Stepper Drivers/X-1A: P204.3, U201.12 (MOT-1A)
/Stepper Drivers/X-1B: P204.4, U201.11 (MOT-1B)
/Stepper Drivers/X-2A: P204.2, U201.13 (MOT-2A)
/Stepper Drivers/X-2B: P204.1, U201.14 (MOT-2B)
/Stepper Drivers/Y-1A: P205.3, U202.12 (MOT-1A)
/Stepper Drivers/Y-1B: P205.4, U202.11 (MOT-1B)
/Stepper Drivers/Y-2A: P205.2, U202.13 (MOT-2A)
/Stepper Drivers/Y-2B: P205.1, U202.14 (MOT-2B)
/Stepper Drivers/Z-1A: P206.3, U203.12 (MOT-1A)
/Stepper Drivers/Z-1B: P206.4, U203.11 (MOT-1B)
/Stepper Drivers/Z-2A: P206.2, U203.13 (MOT-2A)
/Stepper Drivers/Z-2B: P206.1, U203.14 (MOT-2B)
/X_EN_BUF: U201.1 (~ENABLE); also elsewhere on the board
/Y_EN_BUF: U202.1 (~ENABLE); also elsewhere on the board
/Z_EN_BUF: U203.1 (~ENABLE); also elsewhere on the board
MOT_GND: C201.2, C202.2, C203.2, R201.2, R202.2, R203.2, U201.9 (GNDLOG), U201.15 (GNDMOT), U202.9 (GNDLOG), U202.15 (GNDMOT), U203.9 (GNDLOG), U203.15 (GNDMOT); also elsewhere on the board
X_DIR: U201.8 (DIR); also elsewhere on the board
X_STEP: U201.7 (STEP); also elsewhere on the board
Y_DIR: U202.8 (DIR); also elsewhere on the board
Y_STEP: U202.7 (STEP); also elsewhere on the board
Z_DIR: U203.8 (DIR); also elsewhere on the board
Z_STEP: U203.7 (STEP); also elsewhere on the board

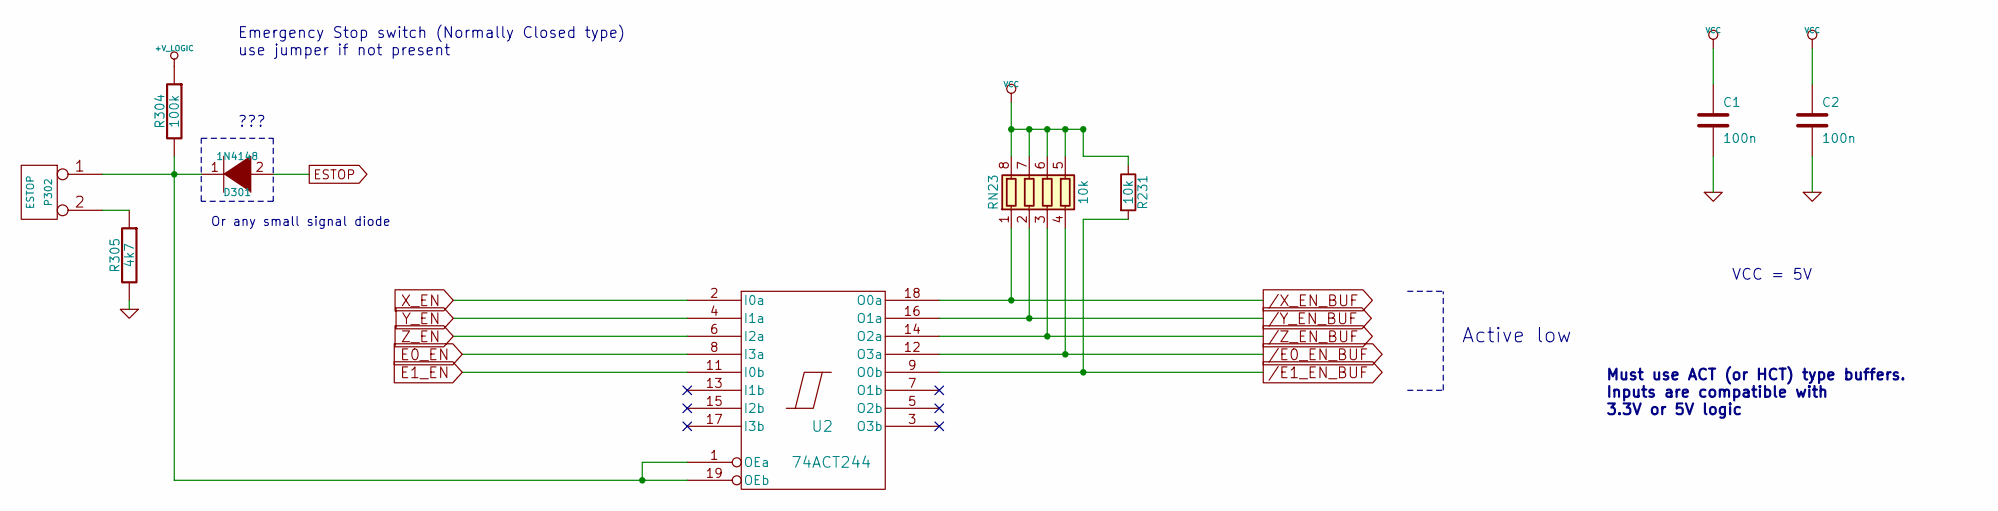
[picture p73: schematic e-stop.sch, OneGeo Controller Shield]

Parts:
C1, C2: 100n; SM0805_Opendous
D301: 1N4148; SOD323
P302: ESTOP; CONN_KK_2.54_2W
R231: 10k; SM0805_Opendous
R304: 100k; SM0805_Opendous
R305: 4k7; SM0805_Opendous
RN23: 10k; R_Array_Concave_4x0603
U2: 74ACT244; soic-20

Connections:
+V_LOGIC: R304.1; also elsewhere on the board
/E0_EN_BUF: RN23.4 (R4.1), U2.12 (O3a); also elsewhere on the board
/E1_EN_BUF: R231.2, U2.9 (O0b); also elsewhere on the board
/X_EN_BUF: RN23.1 (R1.1), U2.18 (O0a); also elsewhere on the board
/Y_EN_BUF: RN23.2 (R2.1), U2.16 (O1a); also elsewhere on the board
/Z_EN_BUF: RN23.3 (R3.1), U2.14 (O2a); also elsewhere on the board
D39: U2.11 (I0b); also elsewhere on the board
E0_EN: U2.8 (I3a); also elsewhere on the board
ESTOP: D301.2 (A); also elsewhere on the board
FD_5V: C1.1, C2.1, R231.1, RN23.5 (R4.2), RN23.6 (R3.2), RN23.7 (R2.2), RN23.8 (R1.2), U2.20 (VCC); also elsewhere on the board
MOT_GND: C1.2, C2.2, R305.2, U2.10 (GND); also elsewhere on the board
unnamed: D301.1 (K), P302.1, R304.2, U2.1 (OEa), U2.19 (OEb)
unnamed: P302.2 (PM), R305.1
X_EN: U2.2 (I0a); also elsewhere on the board
Y_EN: U2.4 (I1a); also elsewhere on the board
Z_EN: U2.6 (I2a); also elsewhere on the board

Notes on the sheet:
Emergency Stop switch (Normally Closed type) use jumper if not present
Or any small signal diode
Active low
VCC = 5V
Must use ACT (or HCT) type buffers. Inputs are compatible with 3.3V or 5V logic
???

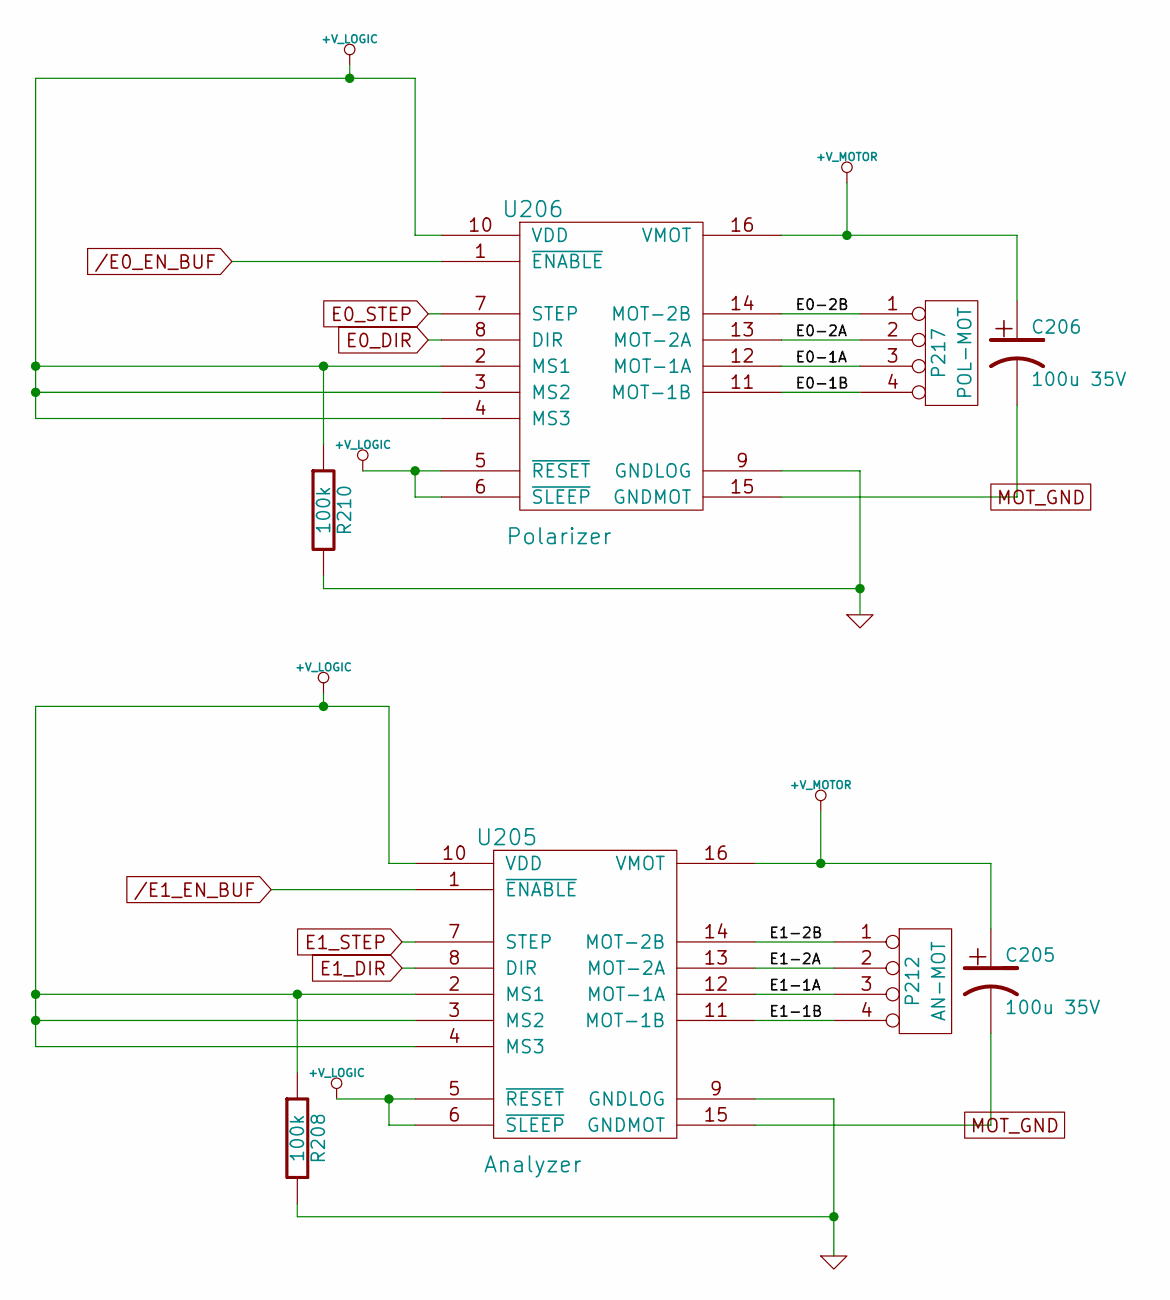
[picture p74: schematic steppers2.sch, OneGeo Controller Shield]

Parts:
C205, C206: 100u 35V; c_elec_6.3x7.7
P212: AN-MOT; CONN_KK_2.54_4W
P217: POL-MOT; CONN_KK_2.54_4W
R208, R210: 100k; SM0805_Opendous
U205: Analyzer; POLOLU
U206: Polarizer; POLOLU

Connections:
+V_LOGIC: R208.1, R210.1, U205.2 (MS1), U205.3 (MS2), U205.4 (MS3), U205.5 (~RESET), U205.6 (~SLEEP), U205.10 (VDD), U206.2 (MS1), U206.3 (MS2), U206.4 (MS3), U206.5 (~RESET), U206.6 (~SLEEP), U206.10 (VDD); also elsewhere on the board
+V_MOTOR: C205.1, C206.1, U205.16 (VMOT), U206.16 (VMOT); also elsewhere on the board
/E0_EN_BUF: U206.1 (~ENABLE); also elsewhere on the board
/E1_EN_BUF: U205.1 (~ENABLE); also elsewhere on the board
/Stepper Drivers 2/E0-1A: P217.3, U206.12 (MOT-1A)
/Stepper Drivers 2/E0-1B: P217.4, U206.11 (MOT-1B)
/Stepper Drivers 2/E0-2A: P217.2, U206.13 (MOT-2A)
/Stepper Drivers 2/E0-2B: P217.1, U206.14 (MOT-2B)
/Stepper Drivers 2/E1-1A: P212.3, U205.12 (MOT-1A)
/Stepper Drivers 2/E1-1B: P212.4, U205.11 (MOT-1B)
/Stepper Drivers 2/E1-2A: P212.2, U205.13 (MOT-2A)
/Stepper Drivers 2/E1-2B: P212.1, U205.14 (MOT-2B)
D41: U205.8 (DIR); also elsewhere on the board
D43: U205.7 (STEP); also elsewhere on the board
E0_DIR: U206.8 (DIR); also elsewhere on the board
E0_STEP: U206.7 (STEP); also elsewhere on the board
MOT_GND: C205.2, C206.2, R208.2, R210.2, U205.9 (GNDLOG), U205.15 (GNDMOT), U206.9 (GNDLOG), U206.15 (GNDMOT); also elsewhere on the board

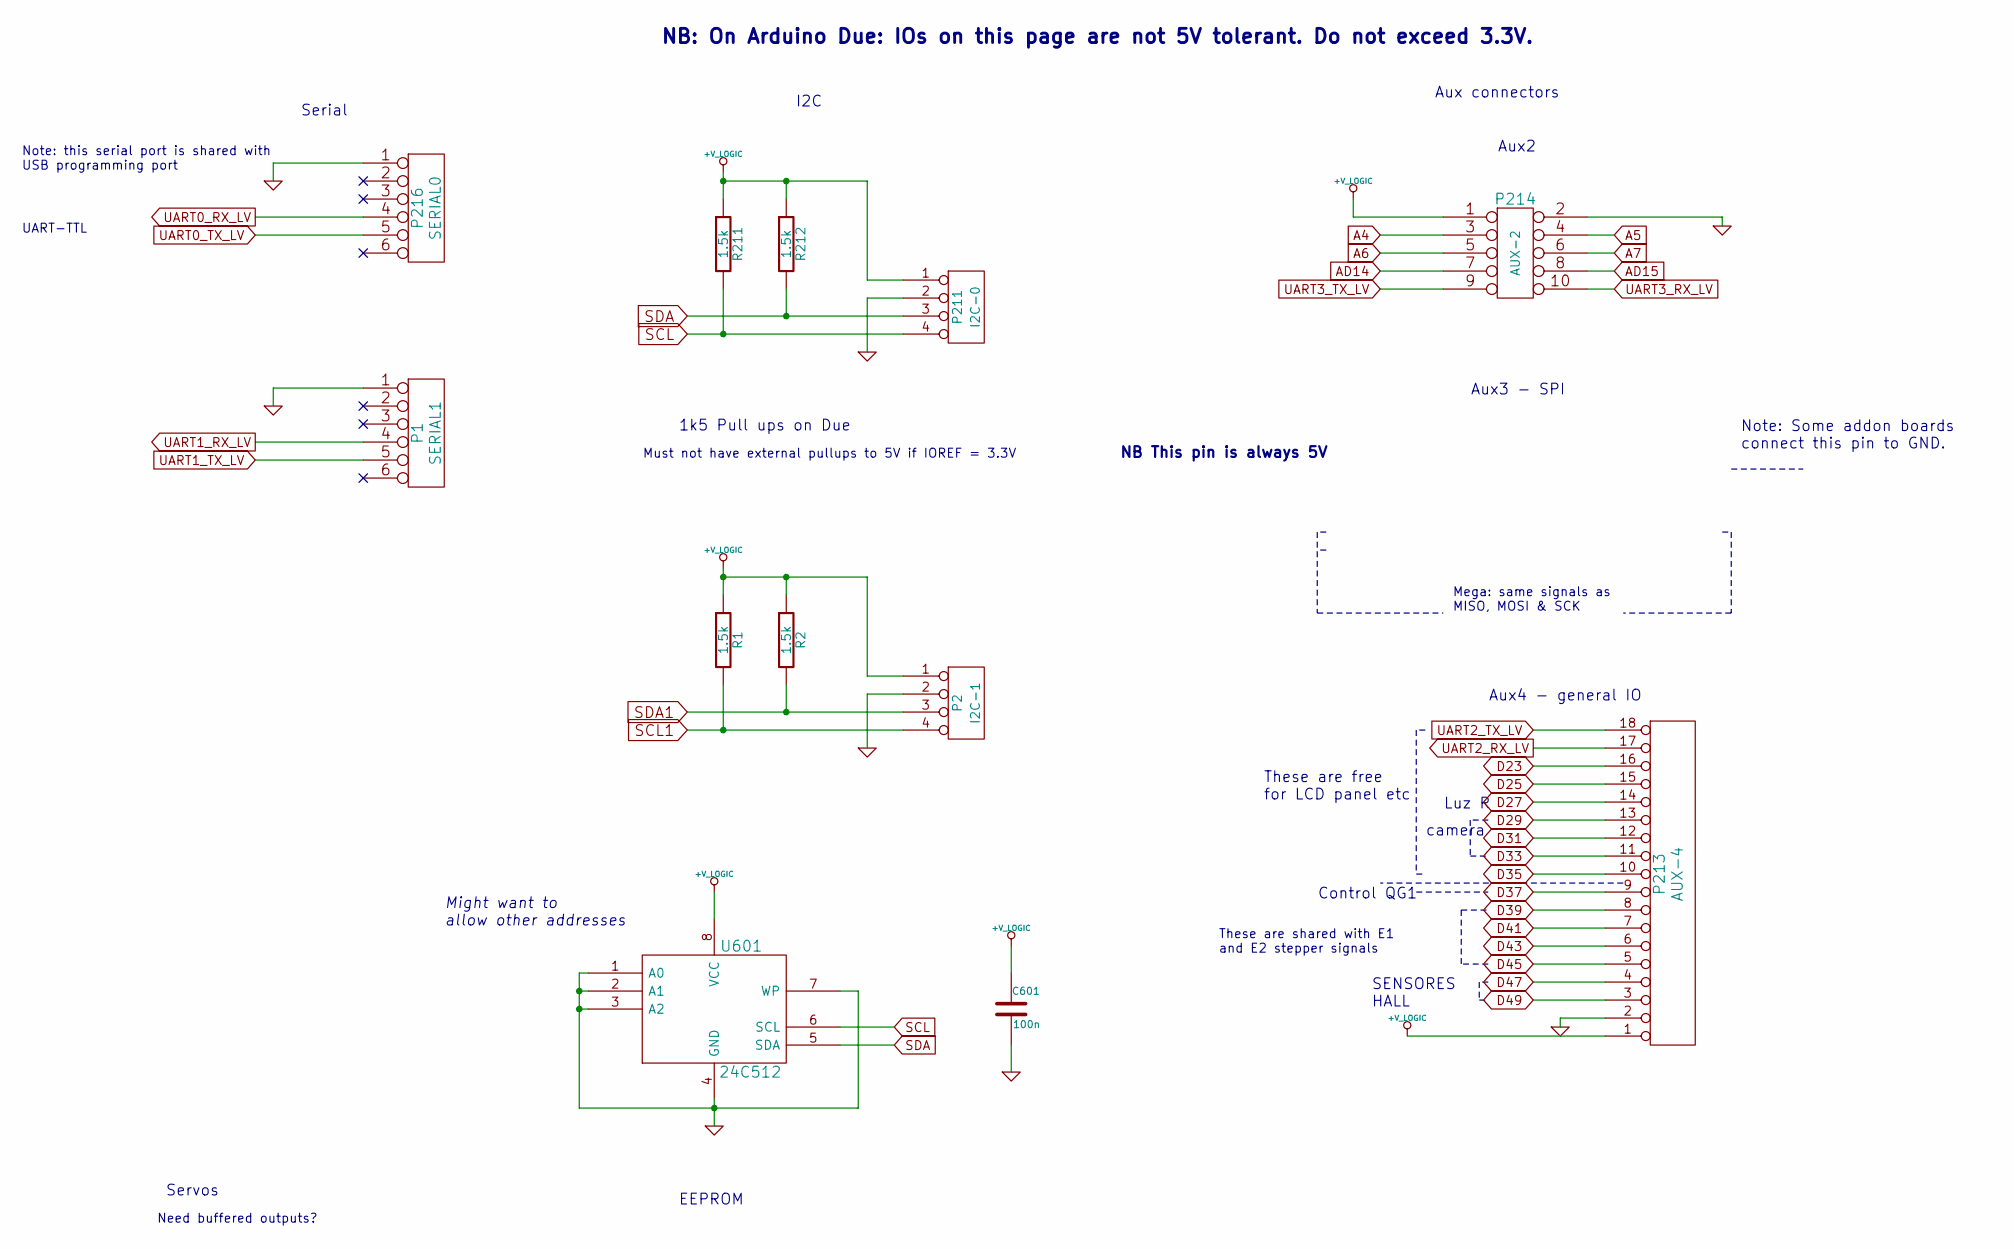
[picture p75: schematic con_misc.sch, OneGeo Controller Shield]

Parts:
C601: 100n; SM0805_Opendous
P1: SERIAL1; pin_strip_6
P2: I2C-1; pin_strip_4
P211: I2C-0; pin_strip_4
P213: AUX-4; pin_strip_18
P214: AUX-2; pin_strip_5x2
P216: SERIAL0; pin_strip_6
R1, R2, R211, R212: 1.5k; SM0805_Opendous
U601: 24C512; so-8

Connections:
+V_LOGIC: C601.1, P2.1, P211.1, P213.1, P214.1, R1.1, R2.1, R211.1, R212.1, U601.8 (VCC); also elsewhere on the board
A4: P214.3; also elsewhere on the board
A5: P214.4; also elsewhere on the board
A6: P214.5; also elsewhere on the board
A7: P214.6; also elsewhere on the board
AD14: P214.7; also elsewhere on the board
AD15: P214.8; also elsewhere on the board
D23: P213.16; also elsewhere on the board
D25: P213.15; also elsewhere on the board
D27: P213.14; also elsewhere on the board
D29: P213.13; also elsewhere on the board
D31: P213.12; also elsewhere on the board
D33: P213.11; also elsewhere on the board
D35: P213.10; also elsewhere on the board
D37: P213.9; also elsewhere on the board
D39: P213.8; also elsewhere on the board
D41: P213.7; also elsewhere on the board
D43: P213.6; also elsewhere on the board
D45: P213.5; also elsewhere on the board
D47: P213.4; also elsewhere on the board
D49: P213.3; also elsewhere on the board
MOT_GND: C601.2, P1.1, P2.2, P211.2, P213.2, P214.2, P216.1, U601.1 (A0), U601.2 (A1), U601.3 (A2), U601.4 (GND), U601.7 (WP); also elsewhere on the board
SCL: P211.4, R211.2, U601.6 (SCL); also elsewhere on the board
SCL1: P2.4, R1.2; also elsewhere on the board
SDA: P211.3, R212.2, U601.5 (SDA); also elsewhere on the board
SDA1: P2.3, R2.2; also elsewhere on the board
UART0_RX_LV: P216.4; also elsewhere on the board
UART0_TX_LV: P216.5; also elsewhere on the board
UART1_RX_LV: P1.4; also elsewhere on the board
UART1_TX_LV: P1.5; also elsewhere on the board
UART2_RX_LV: P213.17; also elsewhere on the board
UART2_TX_LV: P213.18; also elsewhere on the board
UART3_RX_LV: P214.10; also elsewhere on the board
UART3_TX_LV: P214.9; also elsewhere on the board

Notes on the sheet:
Serial
UART-TTL
Need buffered outputs?
Must not have external pullups to 5V if IOREF = 3.3V
1k5 Pull ups on Due
Aux4 - general IO
Aux3 - SPI
Aux2
Aux connectors
Servos
I2C
NB: On Arduino Due: IOs on this page are not 5V tolerant. Do not exceed 3.3V.
Note: this serial port is shared with USB programming port
These are shared with E1 and E2 stepper signals
Mega: same signals as MISO, MOSI & SCK
NB This pin is always 5V
These are free for LCD panel etc
Note: Some addon boards connect this pin to GND.
EEPROM
Might want to allow other addresses
SENSORES HALL
Control QG1
camera
Luz R

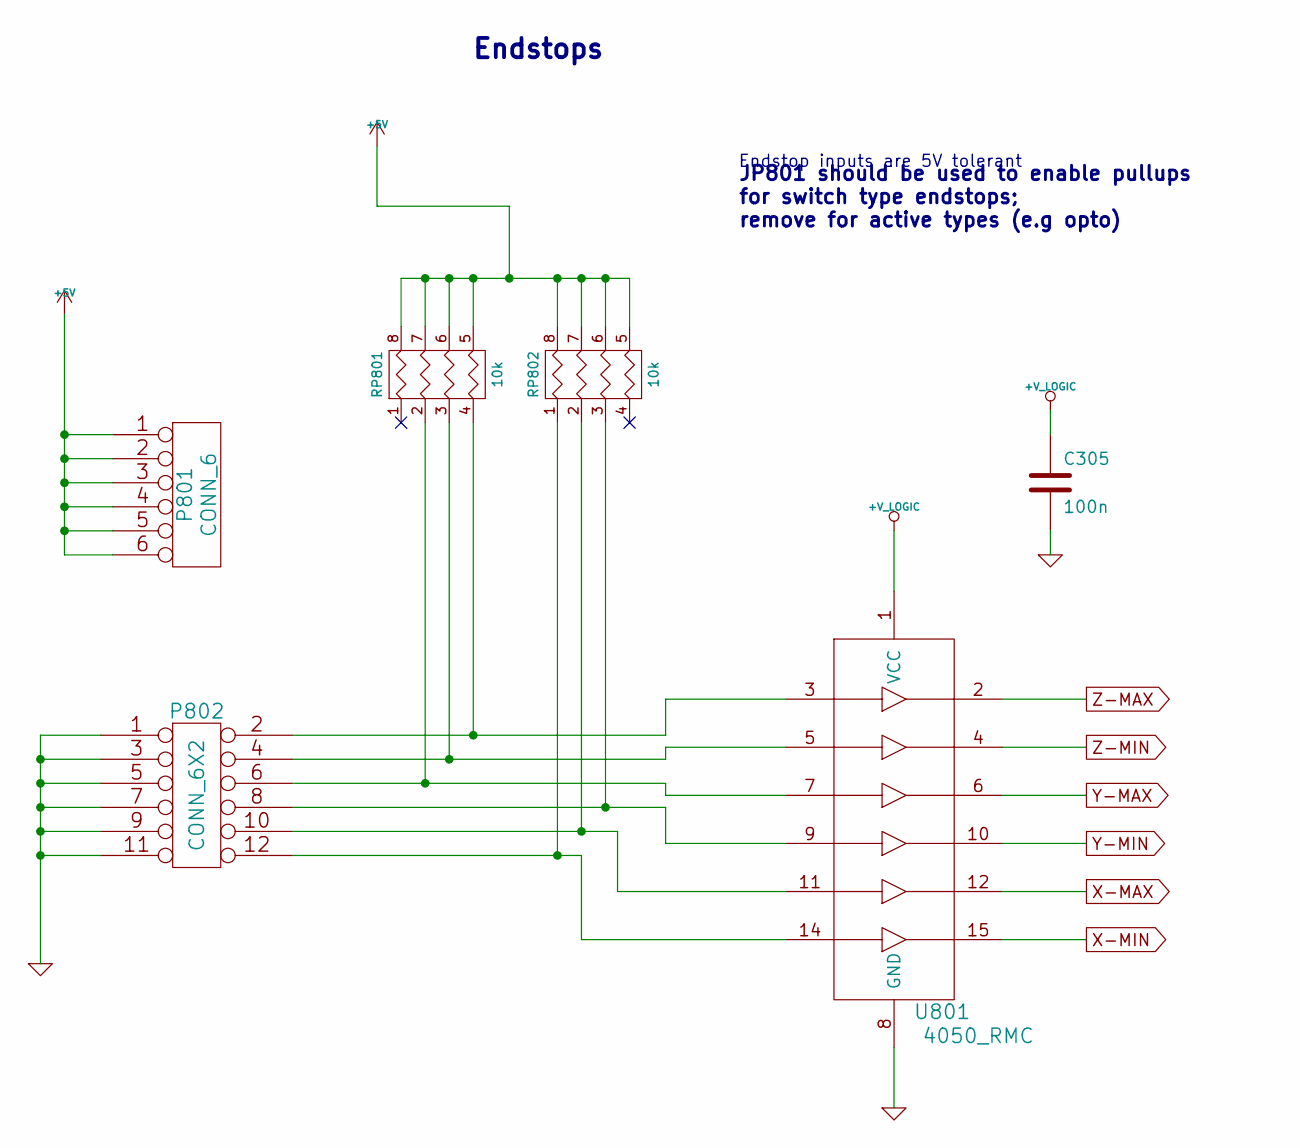
[picture p76: schematic con_inputs.sch, OneGeo Controller Shield]

Parts:
C305: 100n; SM0805_Opendous
P801: CONN_6; pin_strip_6
P802: CONN_6X2; pin_strip_6x2
RP801, RP802: 10k; r_cat16-4
U801: 4050_RMC; so-16

Connections:
+V_LOGIC: C305.1, U801.1 (VCC); also elsewhere on the board
FD_5V: P801.1, P801.2, P801.3, P801.4, P801.5, P801.6, RP801.5 (R4), RP801.6 (R3), RP801.7 (R2), RP801.8 (R1), RP802.5 (R4), RP802.6 (R3), RP802.7 (R2), RP802.8 (R1); also elsewhere on the board
MOT_GND: C305.2, P802.1, P802.3, P802.5, P802.7, P802.9, P802.11, U801.8 (GND); also elsewhere on the board
unnamed: P802.2, RP801.4, U801.3
unnamed: P802.4, RP801.3, U801.5
unnamed: P802.6, RP801.2, U801.7
unnamed: P802.8, RP802.3, U801.9
unnamed: P802.10, RP802.2, U801.11
unnamed: P802.12, RP802.1, U801.14
X-MAX: U801.12; also elsewhere on the board
X-MIN: U801.15; also elsewhere on the board
Y-MAX: U801.6; also elsewhere on the board
Y-MIN: U801.10; also elsewhere on the board
Z-MAX: U801.2; also elsewhere on the board
Z-MIN: U801.4; also elsewhere on the board

Notes on the sheet:
Endstop inputs are 5V tolerant
Endstops
JP801 should be used to enable pullups for switch type endstops; remove for active types (e.g opto)
