jumorap/Geolo/one_geoV1.2-master/electrx/mainboard/mainboard.kicad_pcb

## KiCad design one_geoV1.2-master/electrx/mainboard/mainboard.kicad_pcb (continued)

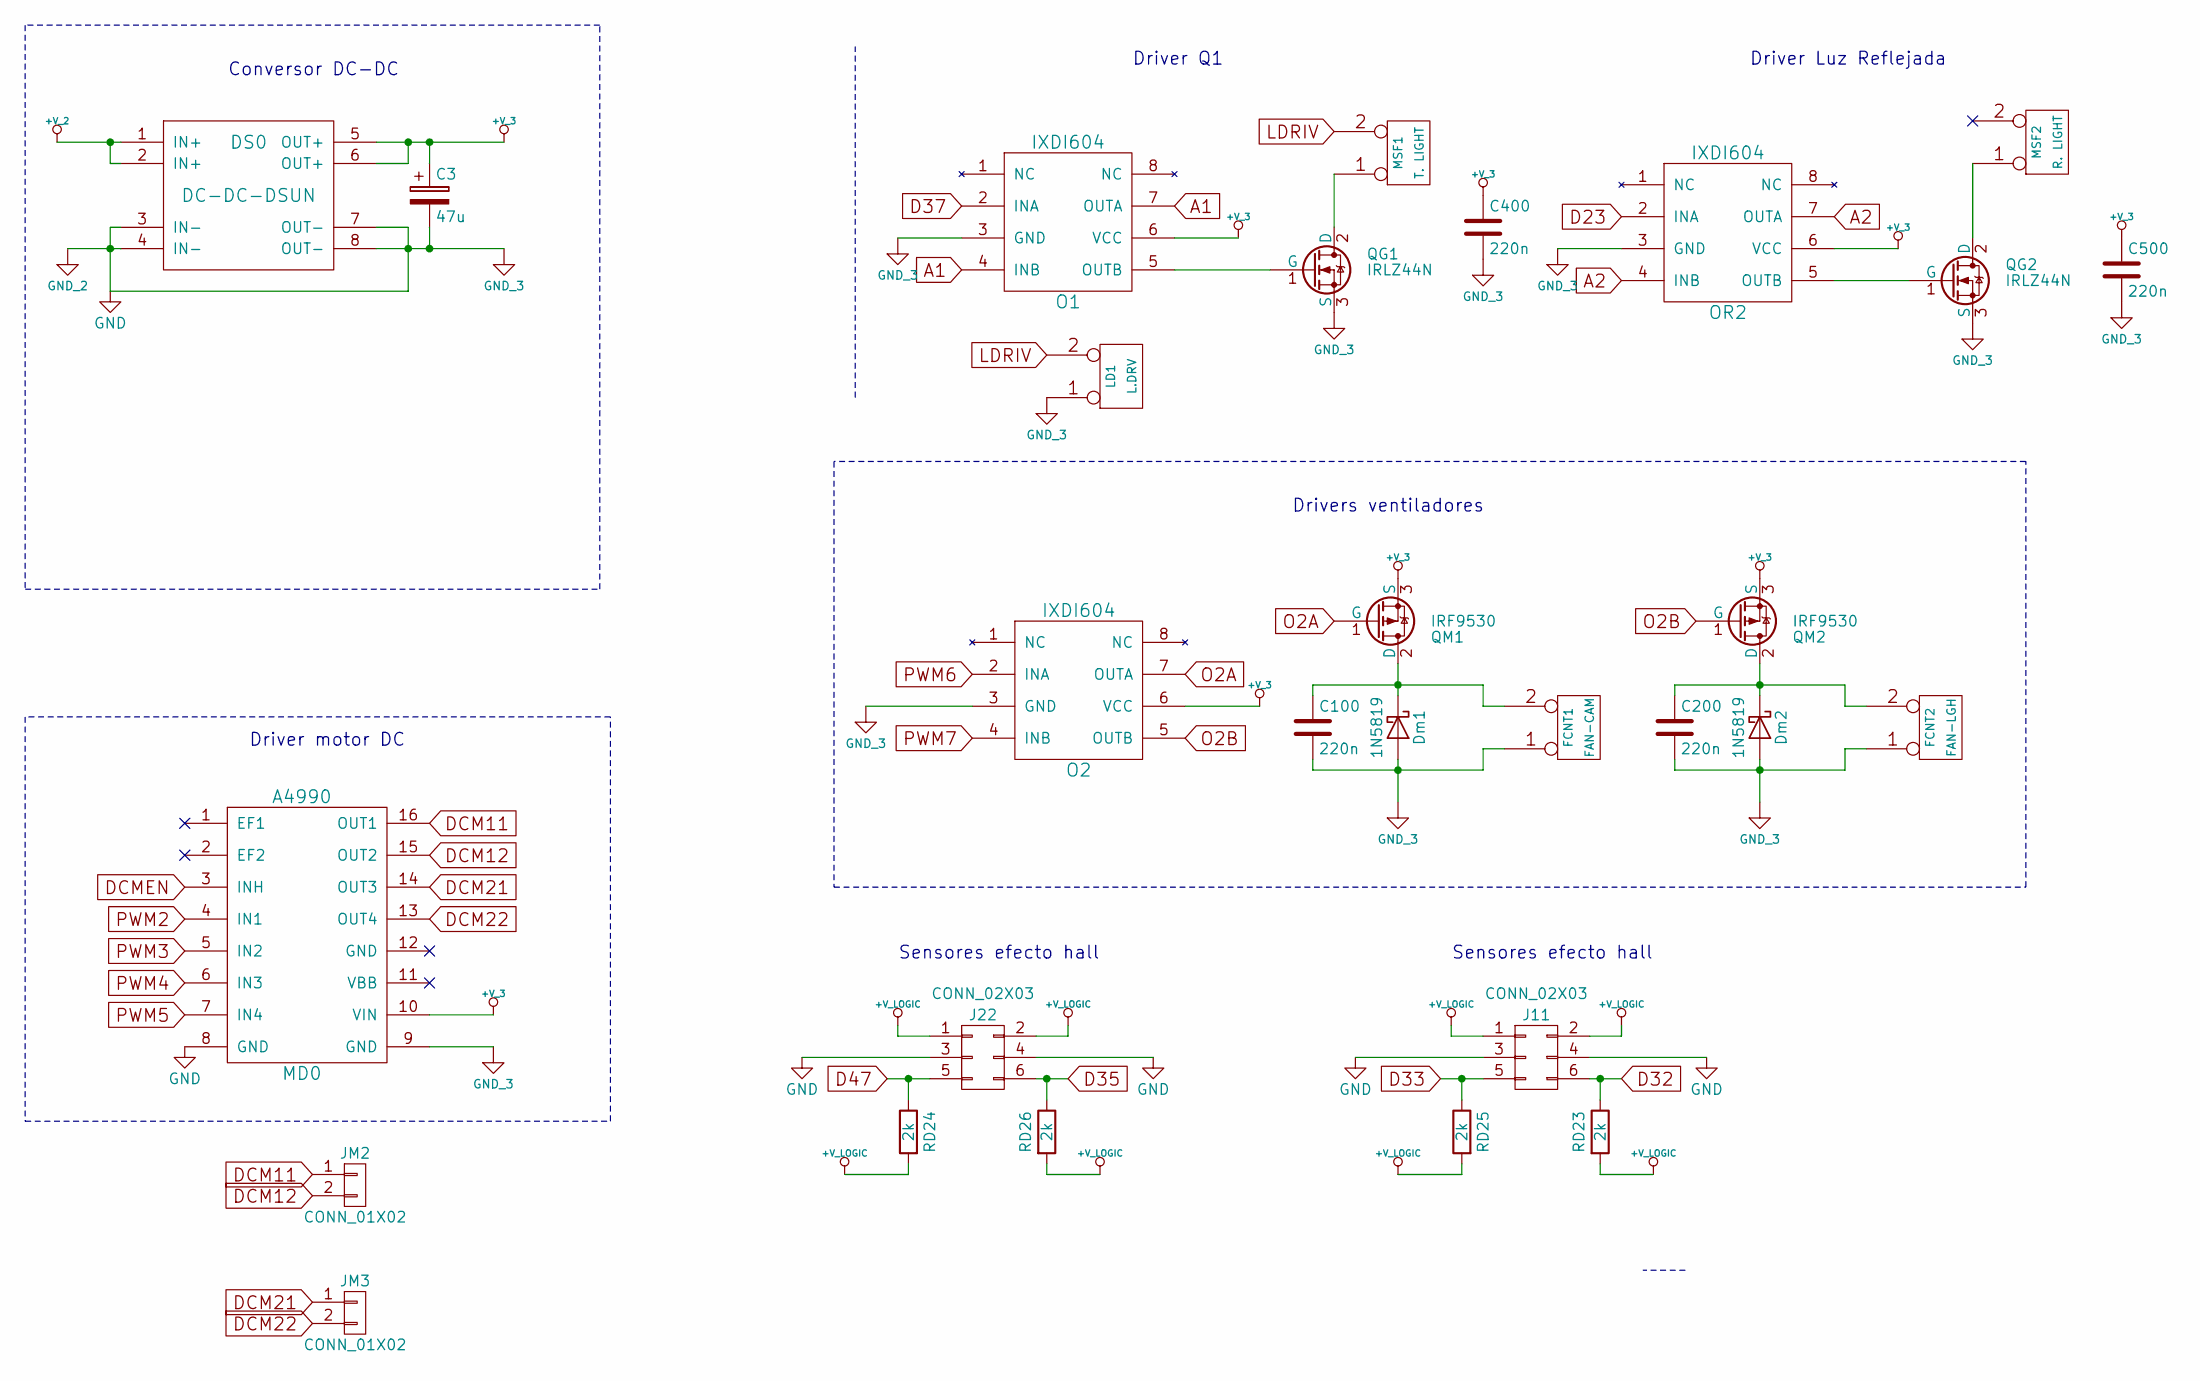
[picture p77: schematic Added_by_EOST.sch, OneGeo Controller Shield]

Parts:
C3: 47u; c_elec_5x5.3
C100, C200, C400, C500: 220n; c_0805
DS0: DC-DC-DSUN; D-SUN_DC-DC
Dm1, Dm2: 1N5819; Diode_DO-41_SOD81_Horizontal_RM10
FCNT1: FAN-CAM; mors_2p
FCNT2: FAN-LGH; mors_2p
J11, J22: CONN_02X03; pin_socket_3x2
JM2, JM3: CONN_01X02; pin_strip_2
LD1: L.DRV; mors_2p
MD0: A4990; POLOLU
MSF1: T. LIGHT; mors_2p
MSF2: R. LIGHT; mors_2p
O1, O2: IXDI604; SOIC-8_3.9x4.9mm_Pitch1.27mm
OR2: IXDI604; SOIC-8_3.9x4.9mm_Pitch1.27mm
QG1, QG2: IRLZ44N; TO220_V_RMC
QM1, QM2: IRF9530; TO220_V_RMC
RD23, RD24, RD25, RD26: 2k; SM0805_Opendous

Connections:
+V_2: DS0.1 (IN+), DS0.2 (IN+); also elsewhere on the board
+V_3: C3.1, C400.1, C500.1, DS0.5 (OUT+), DS0.6 (OUT+), MD0.10 (VIN), O1.6 (VCC), O2.6 (VCC), OR2.6 (VCC), QM1.3 (S), QM2.3 (S); also elsewhere on the board
+V_LOGIC: J11.1, J11.2, J22.1, J22.2, RD23.2, RD24.2, RD25.2, RD26.2; also elsewhere on the board
A1: O1.4 (INB), O1.7 (OUTA)
A2: OR2.4 (INB), OR2.7 (OUTA)
D23: OR2.2 (INA); also elsewhere on the board
D32: J11.6, RD23.1; also elsewhere on the board
D33: J11.5, RD25.1; also elsewhere on the board
D35: J22.6, RD26.1; also elsewhere on the board
D37: O1.2 (INA); also elsewhere on the board
D47: J22.5, RD24.1; also elsewhere on the board
DCM11: JM2.1, MD0.16 (OUT1)
DCM12: JM2.2, MD0.15 (OUT2)
DCM21: JM3.1, MD0.14 (OUT3)
DCM22: JM3.2, MD0.13 (OUT4)
DCMEN: MD0.3 (INH); also elsewhere on the board
LDRIV: LD1.2 (PM), MSF1.2 (PM)
MOT_GND: C3.2, C100.2, C200.2, C400.2, C500.2, DS0.3 (IN-), DS0.4 (IN-), DS0.7 (OUT-), DS0.8 (OUT-), Dm1.2 (A), Dm2.2 (A), FCNT1.1, FCNT2.1, J11.3, J11.4, J22.3, J22.4, LD1.1, MD0.8 (GND), MD0.9 (GND), O1.3 (GND), O2.3 (GND), OR2.3 (GND), QG1.3 (S), QG2.3 (S); also elsewhere on the board
unnamed: C100.1, Dm1.1 (K), FCNT1.2 (PM), QM1.2 (D)
unnamed: C200.1, Dm2.1 (K), FCNT2.2 (PM), QM2.2 (D)
unnamed: MSF1.1, QG1.2 (D)
unnamed: MSF2.1, QG2.2 (D)
unnamed: O1.5 (OUTB), QG1.1 (G)
unnamed: OR2.5 (OUTB), QG2.1 (G)
O2A: O2.7 (OUTA), QM1.1 (G)
O2B: O2.5 (OUTB), QM2.1 (G)
PWM2: MD0.4 (IN1); also elsewhere on the board
PWM3: MD0.5 (IN2); also elsewhere on the board
PWM4: MD0.6 (IN3); also elsewhere on the board
PWM5: MD0.7 (IN4); also elsewhere on the board
PWM6: O2.2 (INA); also elsewhere on the board
PWM7: O2.4 (INB); also elsewhere on the board

Notes on the sheet:
Sensores efecto hall
Driver motor DC
Conversor DC-DC
Drivers ventiladores
Driver Q1
Driver Luz Reflejada

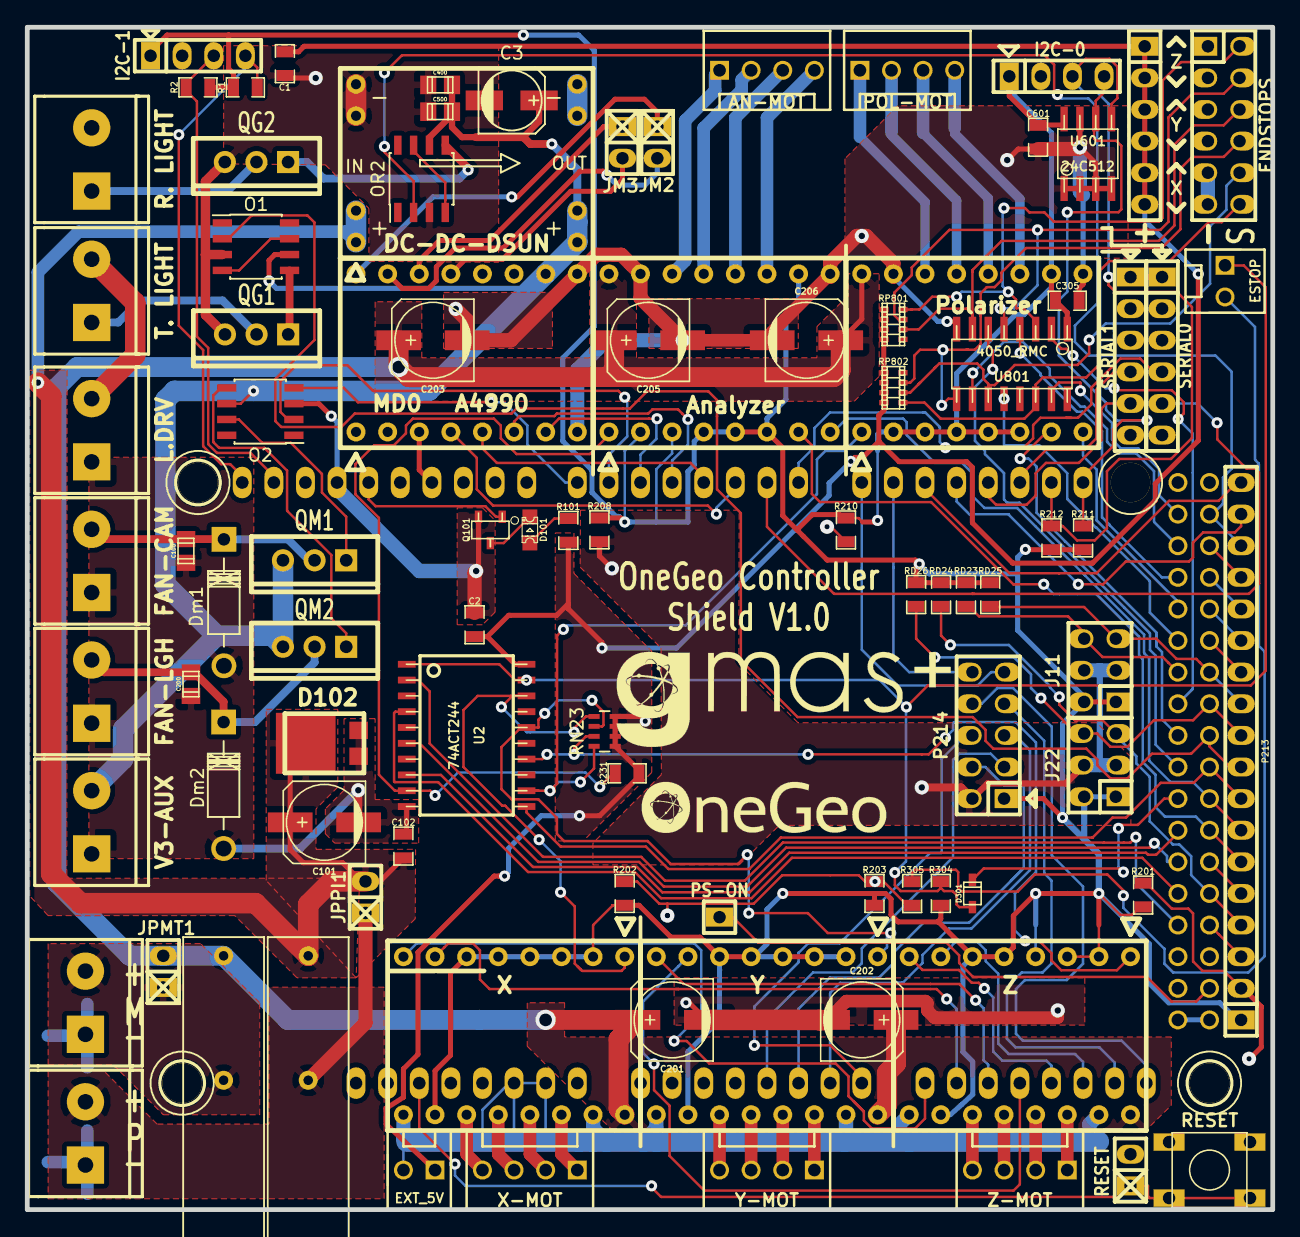
[picture p78: board mainboard.kicad_pcb from above]

Board: 2 copper layers, 100.1 x 95.0 mm, 95 parts (0 on the bottom side), 121 nets.
