jumorap/Geolo/one_geoV1.2-master/code/test_motors_arduino/OneGeo_motorE0/OneGeo_motorE0.ino

const int pin = 42; //D42 due enable
const int oe = 40;  //D40 due //ESTOP
const int stepPin = 36; //D36
const int dirPin = 28; //D28
//int customDelay, customDelayMapped;
int customDelayMapped = 250;

void setup(){
  pinMode(pin, OUTPUT);
  pinMode(oe, OUTPUT);
  pinMode(stepPin, OUTPUT);
  pinMode(dirPin, OUTPUT);
  //pinMode(LED_BUILTIN, OUTPUT);
  
  
  }

  void loop(){
  digitalWrite(dirPin, LOW);
  //digitalWrite(LED_BUILTIN, LOW);
  digitalWrite(oe, LOW);
  digitalWrite(pin, LOW);
//  customDelayMapped = speedUp();
  digitalWrite(stepPin, HIGH);
      delayMicroseconds(customDelayMapped);
      digitalWrite(stepPin, LOW);
      delayMicroseconds(customDelayMapped);
  }
