jumorap/Geolo/one_geoV1.2-master/code/test_motors_arduino/prueba_motor/prueba_motor.ino

const int dirPin = 63;
const int stepPin = 62;
const int enbPin=52;
 
const int steps = 200;
int stepDelay;
 
void setup() {
   // Marcar los pines como salida
   pinMode(enbPin, OUTPUT);
   pinMode(dirPin, OUTPUT);
   pinMode(stepPin, OUTPUT);
  
  
}
 
void loop() {


  
   //Activar una direccion y fijar la velocidad con stepDelay
   digitalWrite(enbPin, HIGH);
   digitalWrite(dirPin, HIGH);
   stepDelay = 500;
   // Giramos 200 pulsos para hacer una vuelta completa
   for (int x = 0; x < 200; x++) {
      digitalWrite(stepPin, HIGH);
      delayMicroseconds(stepDelay);
      digitalWrite(stepPin, LOW);
      delayMicroseconds(stepDelay);
   }
   delay(10000);
 
   //Cambiamos la direccion y aumentamos la velocidad
   digitalWrite(dirPin, LOW);
   stepDelay = 150;
   // Giramos 400 pulsos para hacer dos vueltas completas
   for (int x = 0; x < 400; x++) {
      digitalWrite(stepPin, HIGH);
      delayMicroseconds(stepDelay);
      digitalWrite(stepPin, LOW);
      delayMicroseconds(stepDelay);
   }
   delay(10000);
}
