jumorap/Geolo/(notices)

Notices in the files:
one_geoV1.2-master/electrx/mainboard/Extra_Mosfets.sch:
GPL v3
